Saultes45/Mini-Shake-Table-UoA/README.md

# Mini Shake Table UoA
 A repo for the in-house shake table ressources: both design files and exercises for students
