Saultes45/Mini-Shake-Table-UoA/Design Ressources/03_Diagrams/Mini Shake Front Panel.png

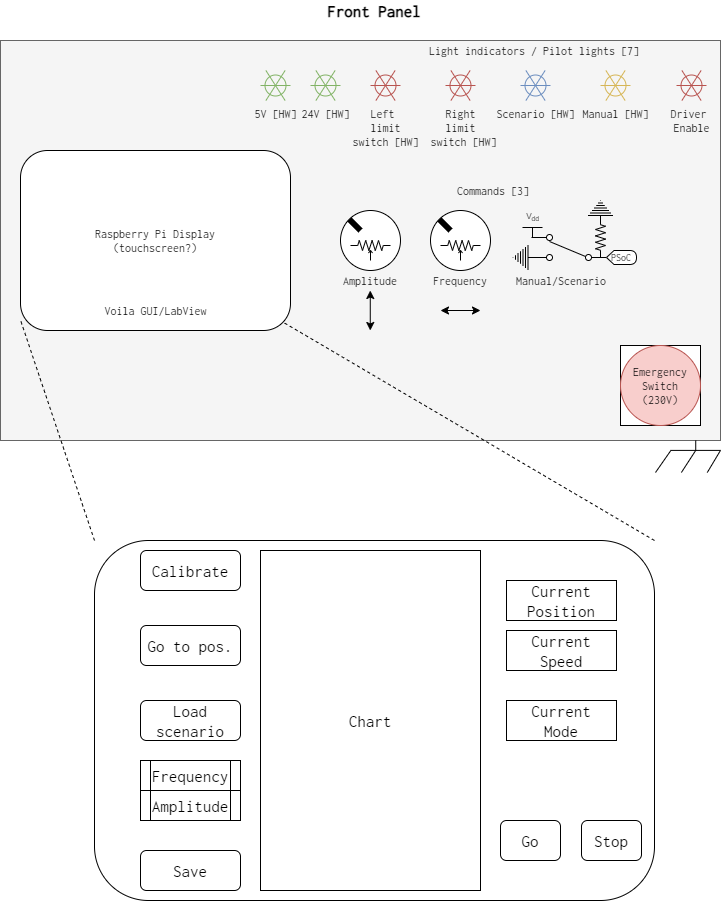
Design Ressources/03_Diagrams/Mini Shake Front Panel.png
