Saultes45/Mini-Shake-Table-UoA/Design Ressources/03_Diagrams/MiniShake bloc diagram stepper.png

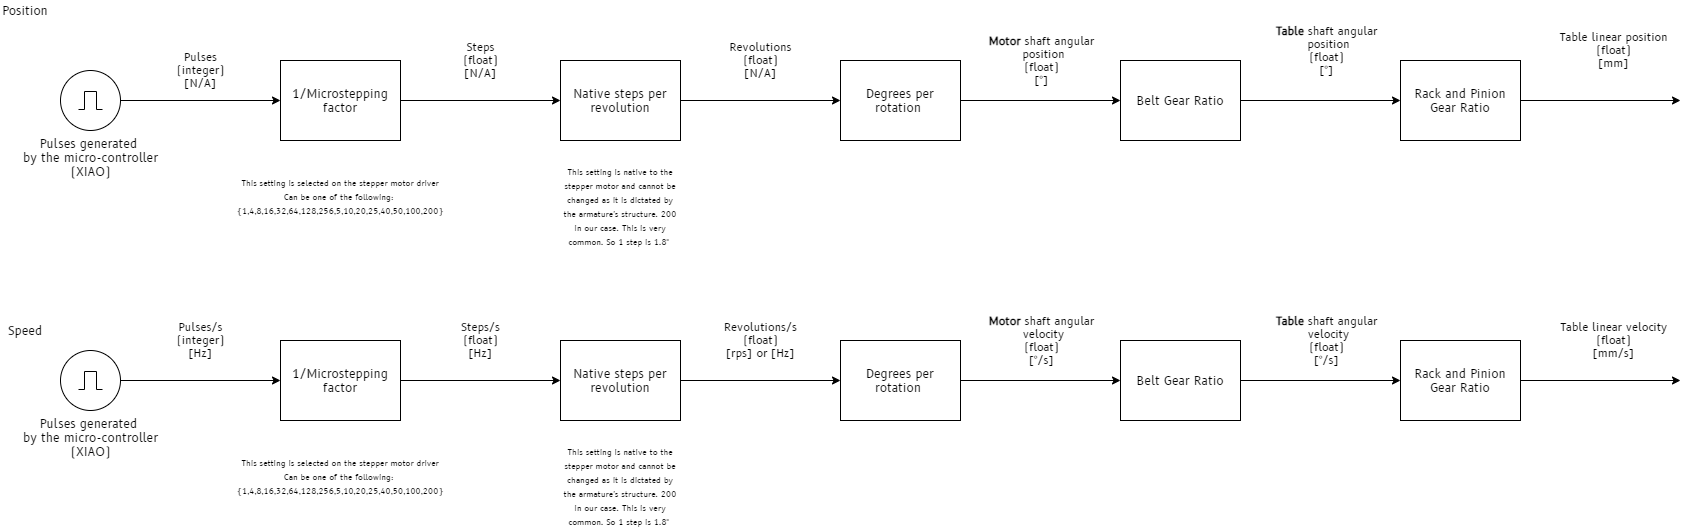
Design Ressources/03_Diagrams/MiniShake bloc diagram stepper.png
