Saultes45/Mini-Shake-Table-UoA/Design Ressources/03_Diagrams/MiniShaker Xiao Pinout.png

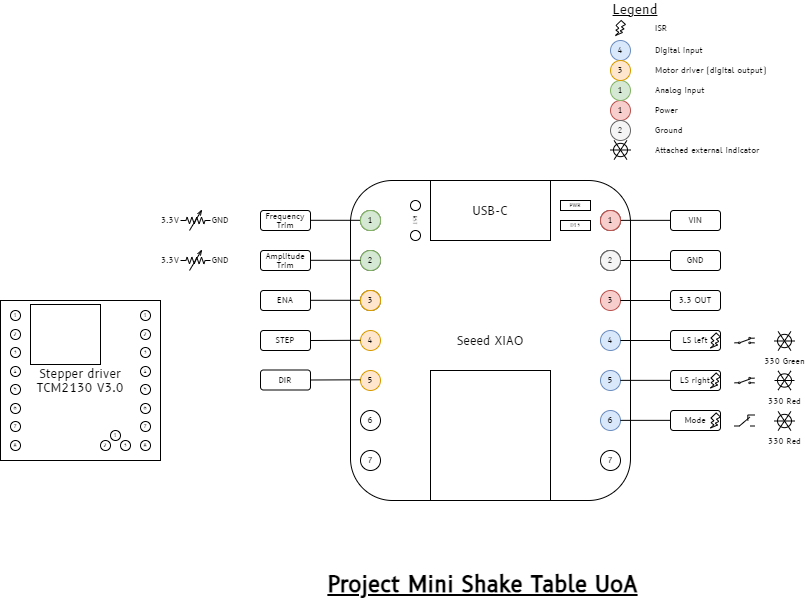
Design Ressources/03_Diagrams/MiniShaker Xiao Pinout.png
