Saultes45/Mini-Shake-Table-UoA/Design Ressources/03_Diagrams/Shake Table.png

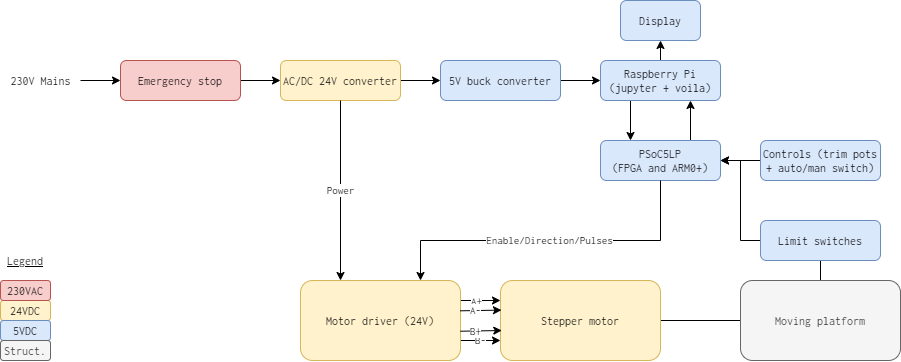
Design Ressources/03_Diagrams/Shake Table.png
