Saultes45/Mini-Shake-Table-UoA/Design Ressources/03_Diagrams/Trimpot Reading.png

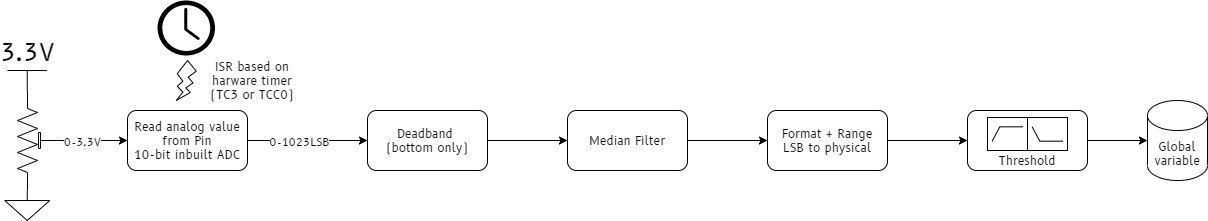
Design Ressources/03_Diagrams/Trimpot Reading.png
