Saultes45/Mini-Shake-Table-UoA/Design Ressources/02_PCB/BOM_Minishake RT micro_2021-07-20.xlsx

ID | Designator | Footprint | Quantity | Manufacturer Part | Manufacturer | Supplier | Supplier Part | Order?
1 | CN1,CN2,CN3,CN6,CN7,CN9,CN10,CN11,CN12,CN13 | CONN-TH_A2543WV-2P | 10 | A2543WV-2P | Changjiang Connectors | LCSC | C239362 | Yes
2 | CN4,CN5 | CONN-TH_A2543WV-3P | 2 | A2543WV-3P | Changjiang Connectors | LCSC | C239363 | Yes
3 | CN8 | CONN-TH_A2543WV-4P | 1 | A2543WV-4P | Changjiang Connectors | LCSC | C239364 | Yes
4 | F2 | F1210 | 1 | MF-USMF050-2 | BOURNS | LCSC | C210831 | Yes
5 | FID1,FID2,FID3,FID4 | FIDUCIAL | 4 |  |  |  |  | No
6 | P1 | UART_HEADER | 1 | Header 1*1P | ReliaPro | LCSC | C81276 | Yes
7 | R1,R2,R3,R4,R5,R6 | R0805 | 6 | RTT053303FTP | RALEC | LCSC | C104230 | Yes
8 | SB1,SB2,SB3,SB4,SB5,SB6,SB7,SB9 | 0402-BRIDGE | 8 | Solder Bridge |  |  |  | No
9 | SJ1 | SOLDER BRIDGE 3P | 1 |  |  |  |  | No
10 | SW1 | SW-SMD_4P-L6.0-W6.0-P4.50-LS9.0_C23873 | 1 | SMD Tactile Switch6*6*6mm | ReliaPro | LCSC | C23873 | No
11 | U1 | PI4_HAT_SLOTS_NO_POE | 1 | RaspberryPi 3 |  |  |  | No
12 | U4 | LM2596 DC-DC BUCK | 1 |  |  |  |  | Yes
13 | U5 | CONN-TH_2P-P2.54_JL301-50002U02 | 1 | JL301-50002U02 | JILN | LCSC | C395214 | Yes
14 | U6 | SEEEDUINO XIAO SMD 3 | 1 | 102010328 | Seeedstudio |  |  | Yes
