Saultes45/Mini-Shake-Table-UoA/Student Ressources/01_Tutorials/Tutorial 1.rtf

Tutorial 1 – Getting familiar with the machine, the front panel commands and indicators, and the general theory of operation

Goal: In this short tutorial, you will learn the different parts of the machine like the inputs, the readings and indicator and most importantly, the security feature made to protect you from the device and vice versa. Let's get started.
1. Theory of operation:
<TO BE FINISHED>

2. Presentation of the different parts of the machine [5]

1. front panel
2. controller
3. power transmission
4. table
5. rail
1.1. The knobs [2 of them]
They are only used in manual mode to choose, and slowing vary 2 movement parameters: the frequency of the movement and the amplitude.
1.2. The enable switch [2 of them]
Overrides the enable and disable orders from the controller. This is a security feature and is explained in detail in 1.2.
1.3. The mode switch [1 of them]
This switch let you pick a mode. You can choose between Manual and Scenario. In "Manual" mode, you use the 2 knobs to make the table describe the movement you want by tweaking the frequency and amplitude you wish. In Scenario mode, the movements you want the table to describe are already pre-programmed in the controller and they will be executed automatically.
1.4. The indicators or pilot lights [6 of them]
There are 6 indicators on the front panel. Some are just for debug, and others are for checking the machine's state so you can understand what it is doing and in which phase it is.
The 2 green indicators indicate when there is power going to the motor (24V) and when there is power going to the controller (3.3V). Both of them should be on at all times when the machine is plugged and the mains switch is in the ON position. If not, your machine has a problem and is will not work.
The 2 red indicators correspond to the 2 limit switches: the left and right one. They illuminate as long as the switch is pressed. The only time you should see those 2 indicator illumination is during calibration mode, when the controller is trying to detect where the table has reached one end.
The amber indicator is linked to the “Enable” state of the motor. When the motor is enabled, and caution is strongly recommended, this indicator is ON. When it is OFF then it MIGHT be safe to operate. To be 100% sure, please use the disable override rocker switch and check the enable status with the help of the indicator.
The white or blue (depending of the model) indicates if the position of the Scenario-manual rocker switch. It just indicates the state of the rocker switch and not the state the controller is in. In calibration mode for example, the mode select rocker switch could be in manual, the indicator will reflect this switch position but in reality, the controller is in calibration mode and will switch to manual as soon as it can. If the “manual” mode is selected, the indicator will be ON, and if the “scenario” mode is selected, the indicator will be OFF.
1. The security features [3]

1.1. The limit switches
There are 2 and are located on both sides of the rail. They are simple temporary spring-loaded, very sensitive switches. They are triggered when the table or any object slams into it. The code detects and acts immediately, within a few ms, to disable the motor. It is important to understand that disabling the motor means the absolute positioning of the table is lost, and therefore, a calibration is required. In calibration mode, limit switches indicate when the table has reached one end of the table.
1.2. The stepper disable toggle (or rocker) switch
The stepper is a strong motor by default, and it packs a lot of torque for its relatively small size. There are very few chances for you to fight its action and succeed. That is the 2.5A we are feeding it, which can go up to 7.2. A stepper motor is stronger when it is static. In that state, the torque and current consumed are maximal. When it is producing a motion, however, the stepper is more susceptible to being moved against. Indeed, in that state, the current fluctuations in its 2 coils are designed to induce rotation of its shaft. This alternance of current diminishes the overall current and, therefore, torque.
As a side note, it is essential to notice that when a stepper is static, it uses a lot of power. This power, not being used entirely as mechanical energy to hold the motor shaft in place, must be dissipated. This dissipation occurs as thermal energy, and the 2 coils of the stepper slowly turns into giant resistors. When no testing is being done, please disable the power going to the stepper (procedure explained below) to avoid premature ageing of the coils.
Thanks to the built-in function of the stepper controller, it is possible to disable any power going to the stepper in a matter of ms. The state of the stepper, i.e. if it is enabled or disabled, is indicated on the front panel by the amber or yellow indicator. Off is disabled and safe to operate, ON is enabled, and caution is advised.
This function is partly handled by the controller: in some particular conditions, the controller will disable the stepper for you. But you can override and disable the stepper irrespective of the controller orders with the dedicated rocker switch exposed in the front panel. This rocker switch is made as a last-chance or barrier of protection. It is helpful primarily in 2 cases.
First, when there is a problem with the shake table and the limit switches are not being triggered (in this case, the mains switch (below) can be used as well).
The second case is as another layer of security for when you are handling equipment close to the moving part of the table or moving the table manually (discouraged) and want to make sure the motor will stay off.
It has been presented before, but any disabling of the motor will make it lose its absolute position. Therefore calibration is required after each disabling.
1.3. The emergency switch
If anything seems out of place or if there is a weird noise or smell, it's time to take action and disable all the power going to the machine. This is your best shot at stopping a critical problem before it is time to get the nearest fire extinguisher. You can turn off all power by simply slamming the large red emergency button. It is conveniently located on the left side of the table, far away from any potential danger, so it's always safe to press it. To reset it, like any emergency button, you have to twist it clockwise like you would screw it (righty-tighty) about a 1/6th of a turn.
