Saultes45/Mini-Shake-Table-UoA/Student Ressources/01_Tutorials/Tutorial 3.rtf

Tutorial 3 – Getting familiar with the Raspberry Pi GUI running an existing scenario, creating your own and testing it
