Saultes45/Mini-Shake-Table-UoA/Student Ressources/01_Tutorials/List of tutorials.docx

Tutorial 1 – Getting familiar with the machine, the front panel commands and indicators, and the general theory of operation

Tutorial 2 – Calibration, centring and manual trimpot adjustments

Tutorial 3 – Getting familiar with the Raspberry Pi GUI running an existing scenario, creating your own and testing it
