Saultes45/Mini-Shake-Table-UoA/Student Ressources/01_Tutorials/Tutorial 2.rtf

Tutorial 2 – Calibration, centring and manual trimpot adjustments

Goal: In this short tutorial, you will learn the sequencing of the machine and how to run the simpliest movement possible to execute on this shake table: the manual mode. Let's get started.

What is the "manual" mode: in manual mode, yuou are in in control of the movement, and with great power comes great mecanical energy. With 2 control knobs you will be able to create different kinds of motion to exite a structure at different modes with different amplitudes. The control of the movement is made through 2 parameter: the frequency and the amplitude of the movement. Thoses 2 parameters are independants .

The controller will not execute the mouvement until both parameters are non-null. so if you want to produce some oscillations, you will have to turn both knobs pass their deadband. Otherwise the controller will not move at all. Indeed, what kind of movement is one with 0 amplitude or 0 frequency?

Deadband and filtering.
Because the signal coming back from the knob contains some electrical noise, it wouldn't be wise to simply read it as is. There a bit of conditioning that takes place. Simply put, the controller filters the signal to smooth it out and to make it more stable.
A deadband hasd also been implemented. Simply put, a very small portion of the start of the knobs has been rendered inactive. The controller will consider any value in this "band" or portion to be 0 even though is actually not. This is a simple trick to make a quick and soft start when changing manual parameter values.
If you are curious, you can refer to the simple block diagram called "Trimpots reading" in the annexes
