Saultes45/Mini-Shake-Table-UoA/Student Ressources/00_Test Profiles/Test - S.xlsx

Time To Target [ms] | Target [mm]
500 | 25
500 | -50
500 | 75
500 | -100
500 | 200
500 | 0
