Saultes45/Mini-Shake-Table-UoA/Student Ressources/00_Test Profiles/High F Low A.xlsx

Time To Target [ms] | Target [mm]
500 | 25
500 | -25
500 | 25
500 | -25
500 | 25
500 | -25
