Saultes45/Mini-Shake-Table-UoA/(threads)

Thread 1 (2021-07-21):

Problem in manual control with knobs

Saultes45, 2021-07-21:
Right LS seems to trigger even if it was physically not.
We have this as the output:

```
Current mode: 1 | 1
Current mode: 1 | 1
You are going to lose the reference position, calibration will be required
DISABLING the stepper...done
DISABLING the TRIMPOTS...done
ENABLING the TRIMPOTS...done
Current mode: 1 | 1
RIGHT Limit Switch ISR triggered 23513, current status: 1
```

Saultes45, 2021-08-04:
This issue is from an old version and the described issue does not occur anymore. Will be closed.

Closed 2021-08-04.
