Saultes45/Mini-Shake-Table-UoA/Design Ressources/00_Structure/Mini Shake Table Final 23.09.pdf

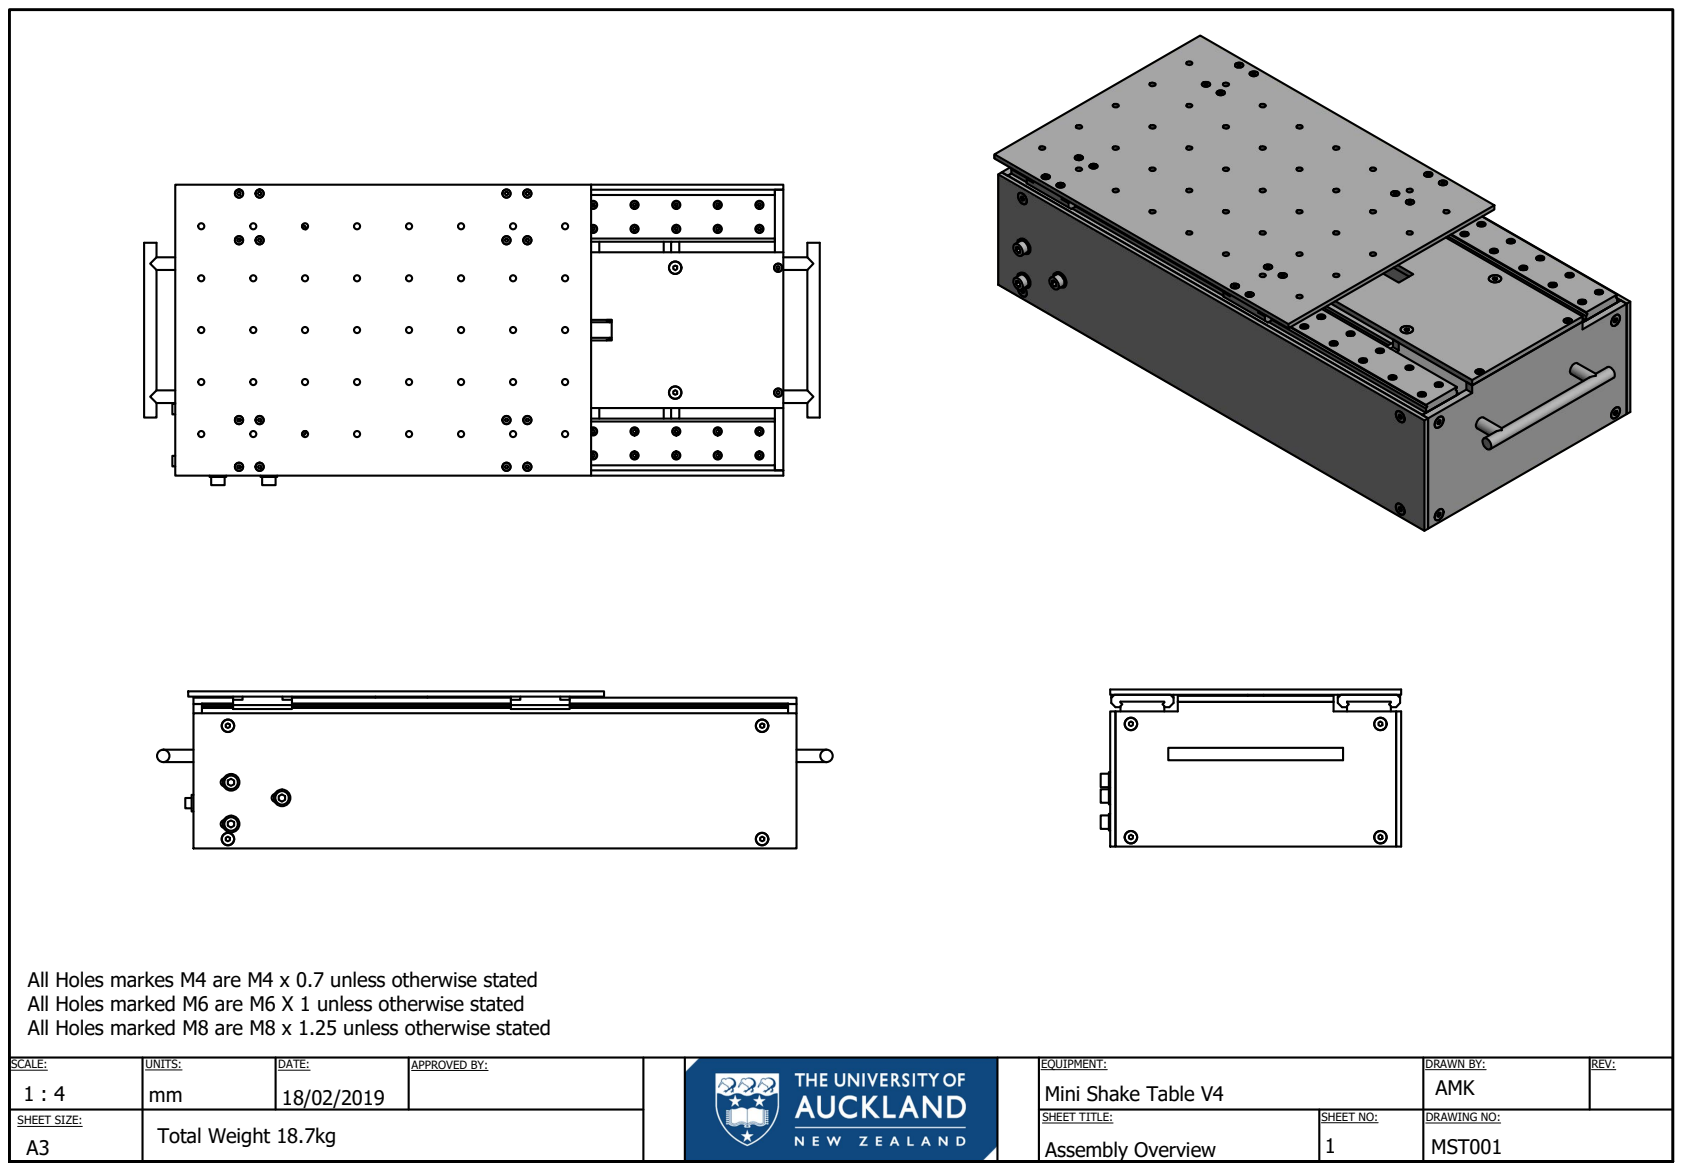
[picture p6: page 1]
All H All H All H

S C A L E : 1 : 4 | U N I T S : | D AT E : 1 8 / 0 2 / 2 0 1 9 | A P P R O V E D B Y : | | | E Q U I P M E N T : a k e T a ble V 4 | D RA W N B Y : A M K | R E V :

S H E E T S I Z E : A 3 | T o t al W e i g h t 1 8 . 7 k g | | | S H E E T T I T L E : bly O v e r v i e w | S H E E T N O : 1 | D RA W I N G N O : M S T 0 0 1

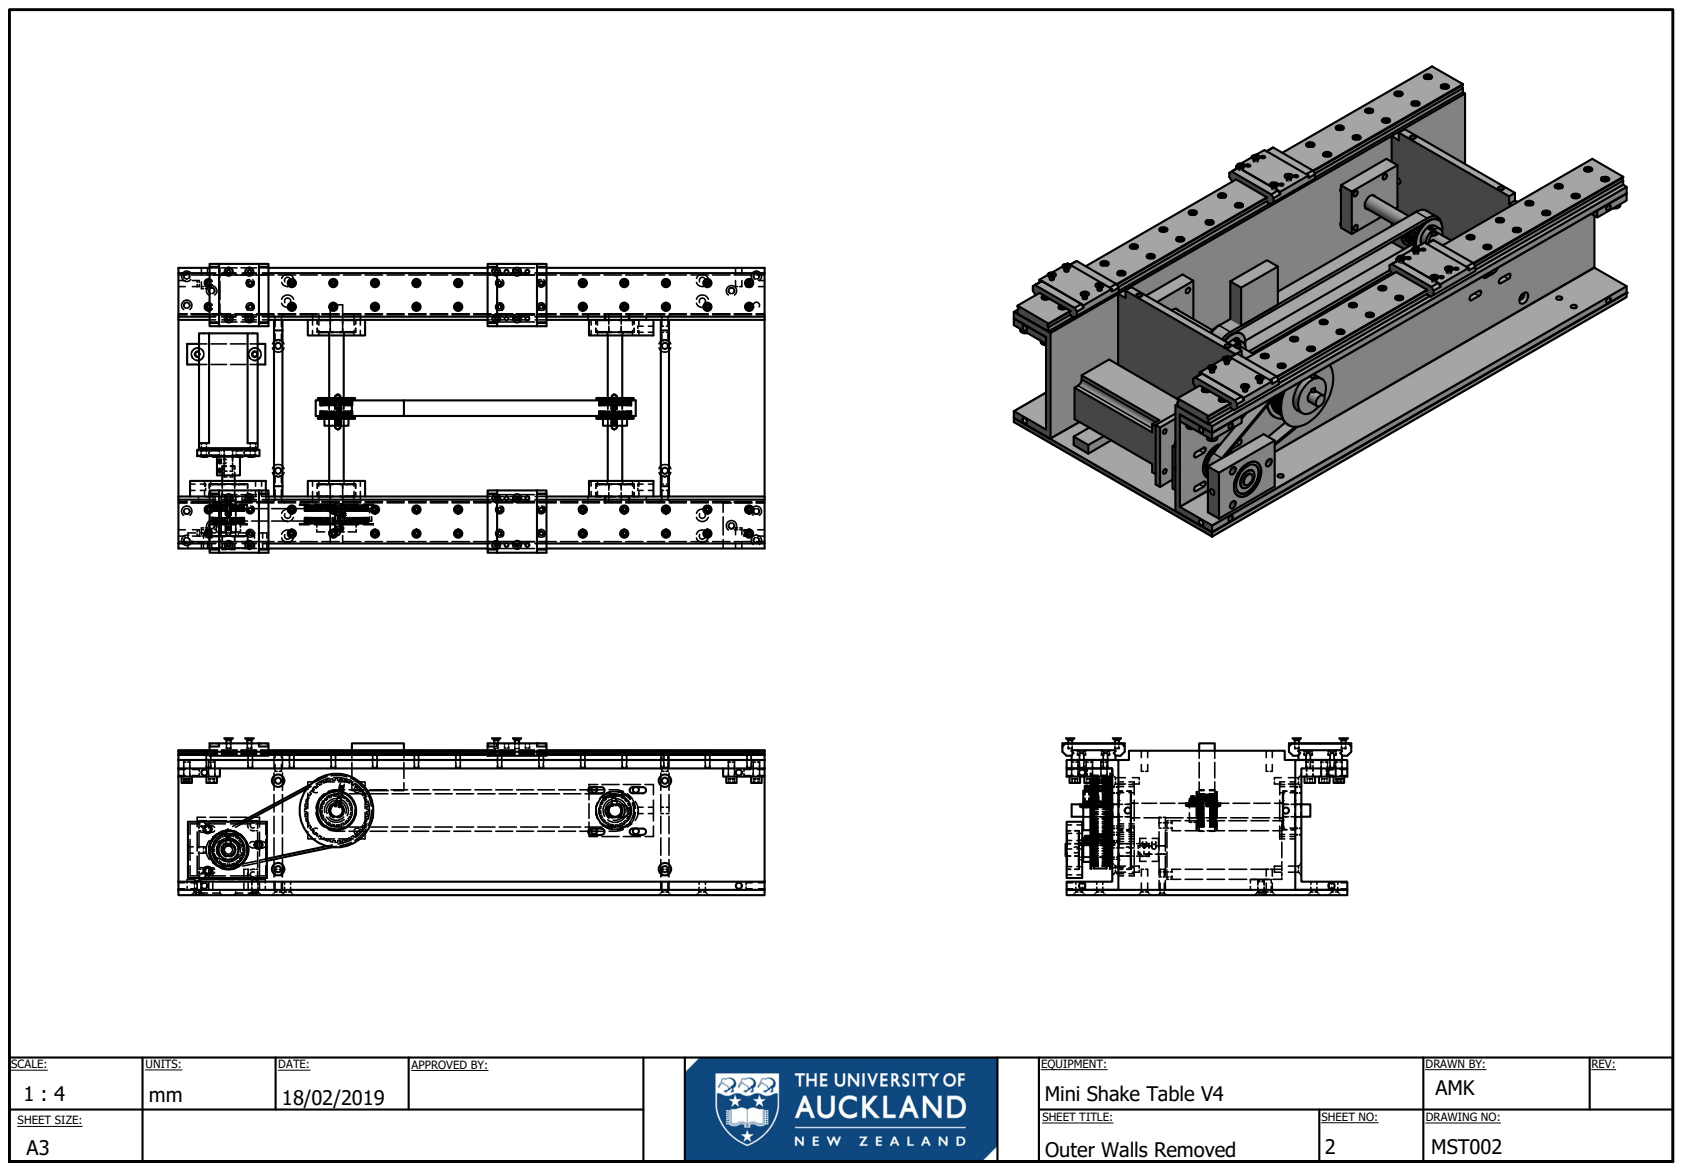
[picture p7: page 2]

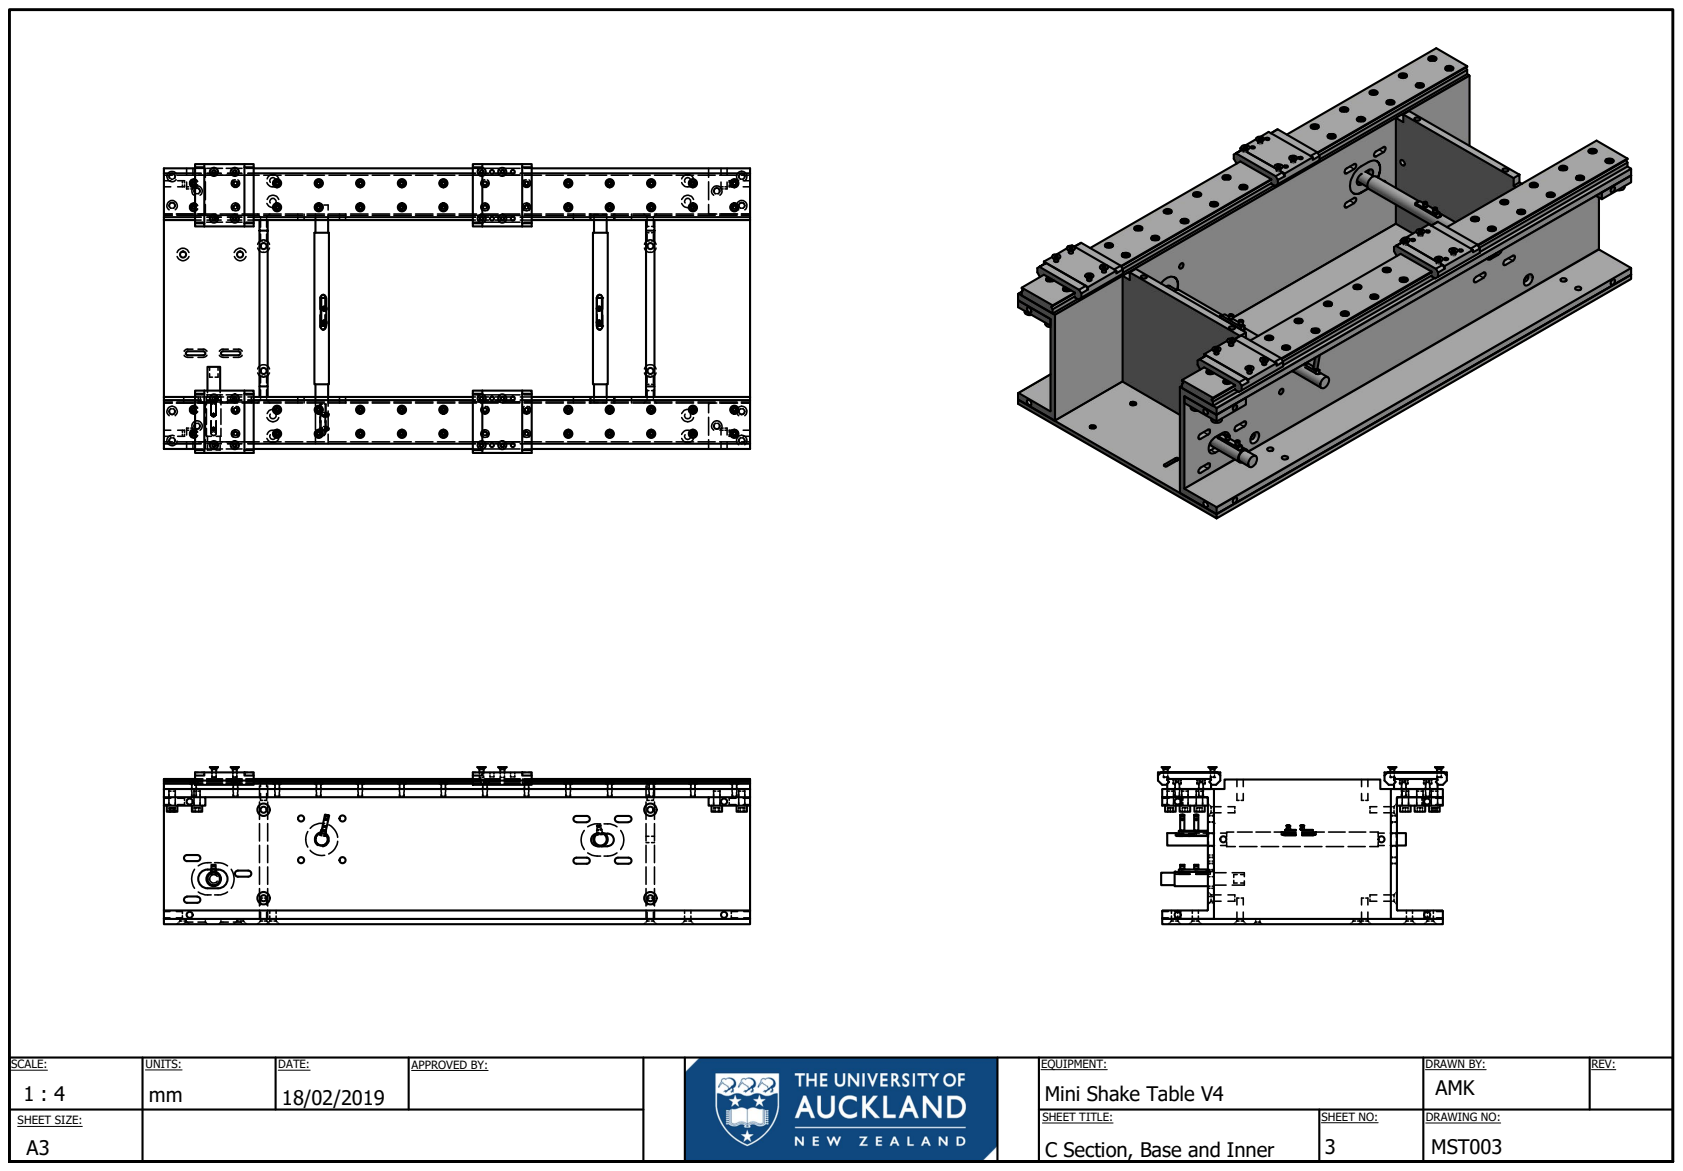
[picture p8: page 3]

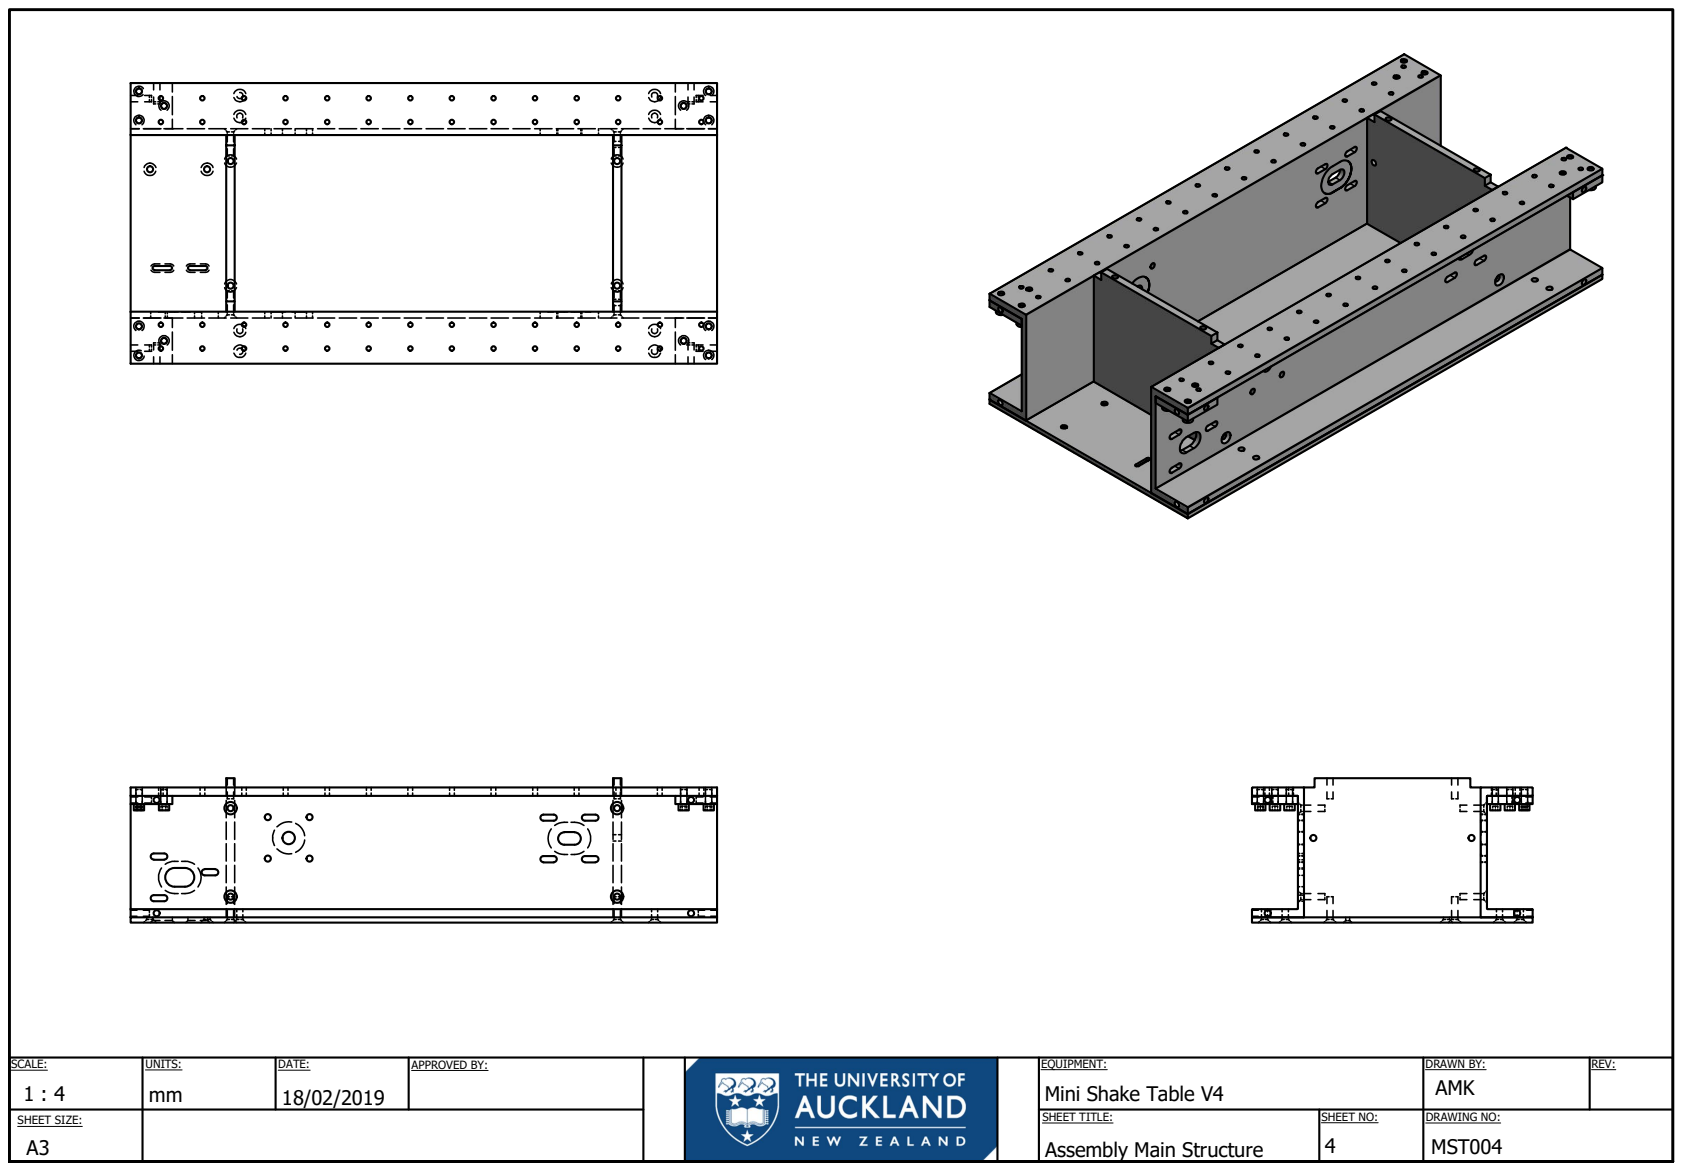
[picture p9: page 4]

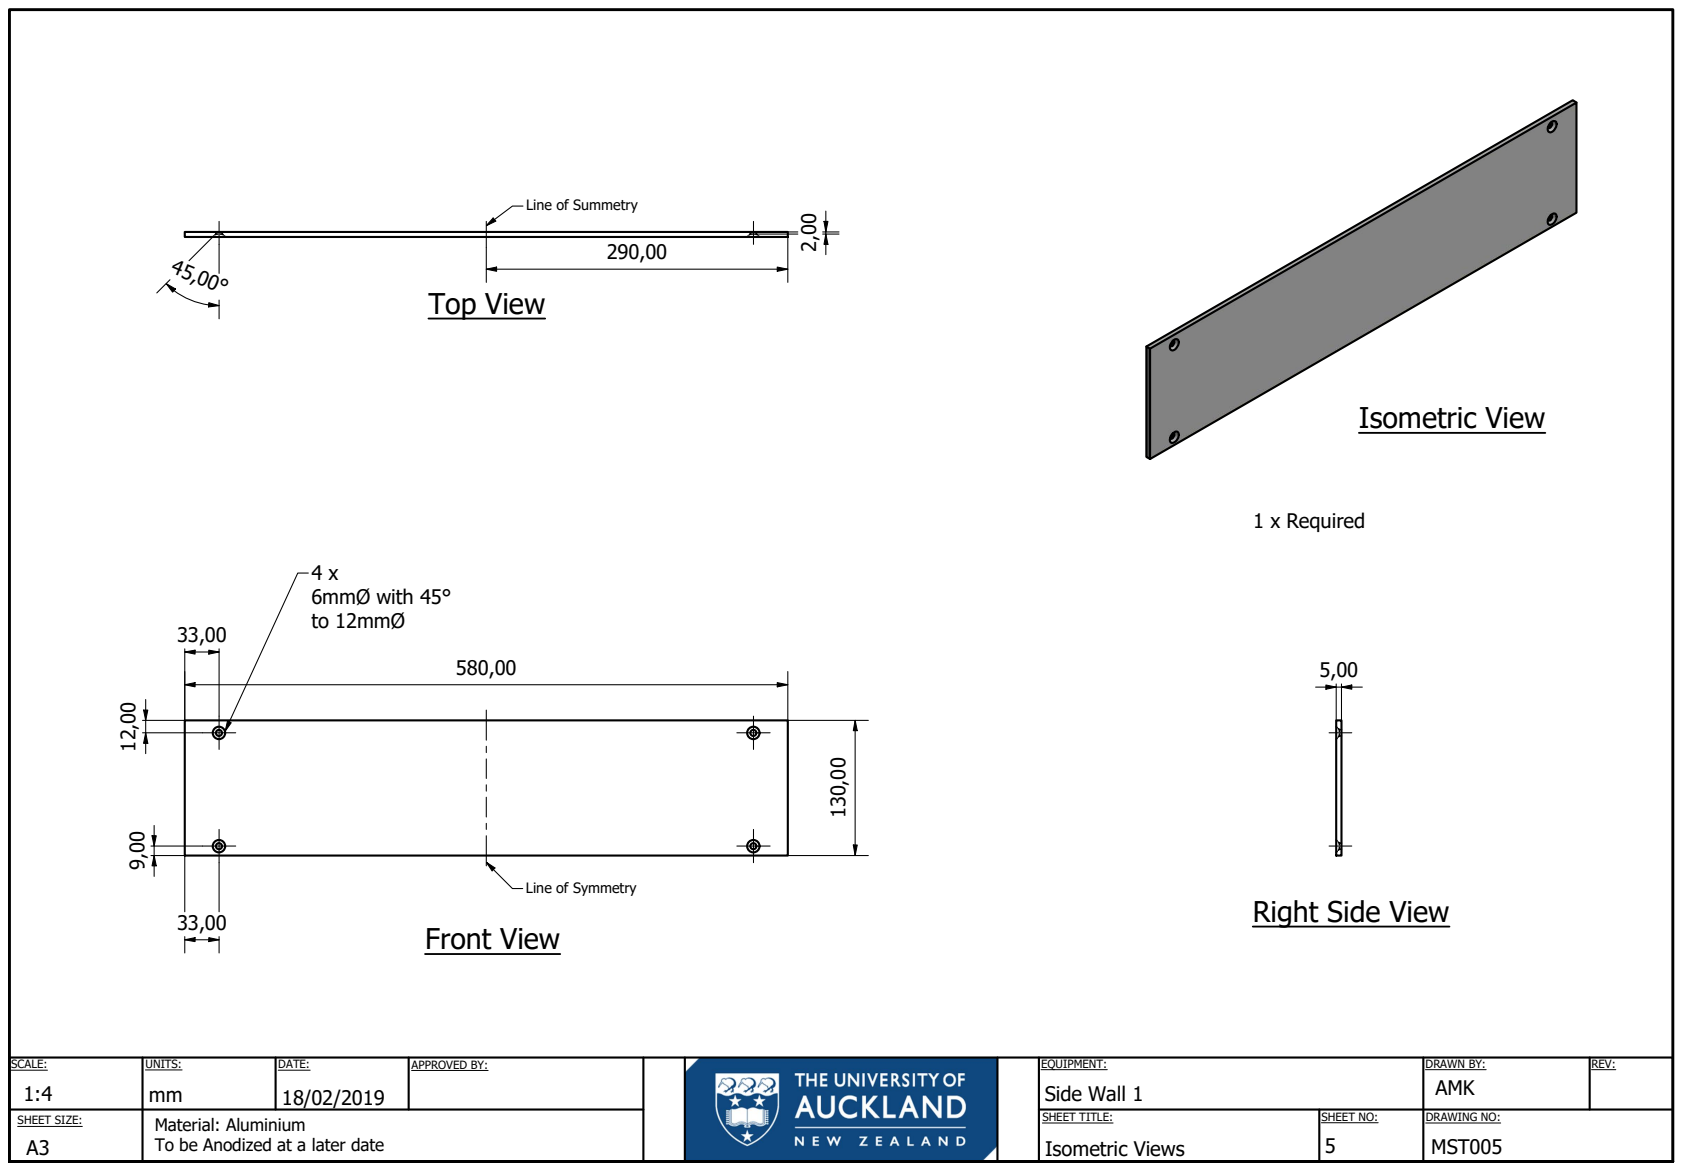
[picture p10: page 5]
SCALE:; UNITS:; DATE:; APPROVED BY:; EQUIPMENT:; SHEET TITLE:; SHEET NO:; DRAWN BY:; DRAWING NO:; Isometric Views; MST005; SHEET SIZE:; Side Wall 1; 4 x 6mmØ with 45° to 12mmØ; Front View; Top View; Isometric View; 1 x Required

Line of Summetry

Line of Symmetry

Right Side View

Material: Aluminium
To be Anodized at a later date

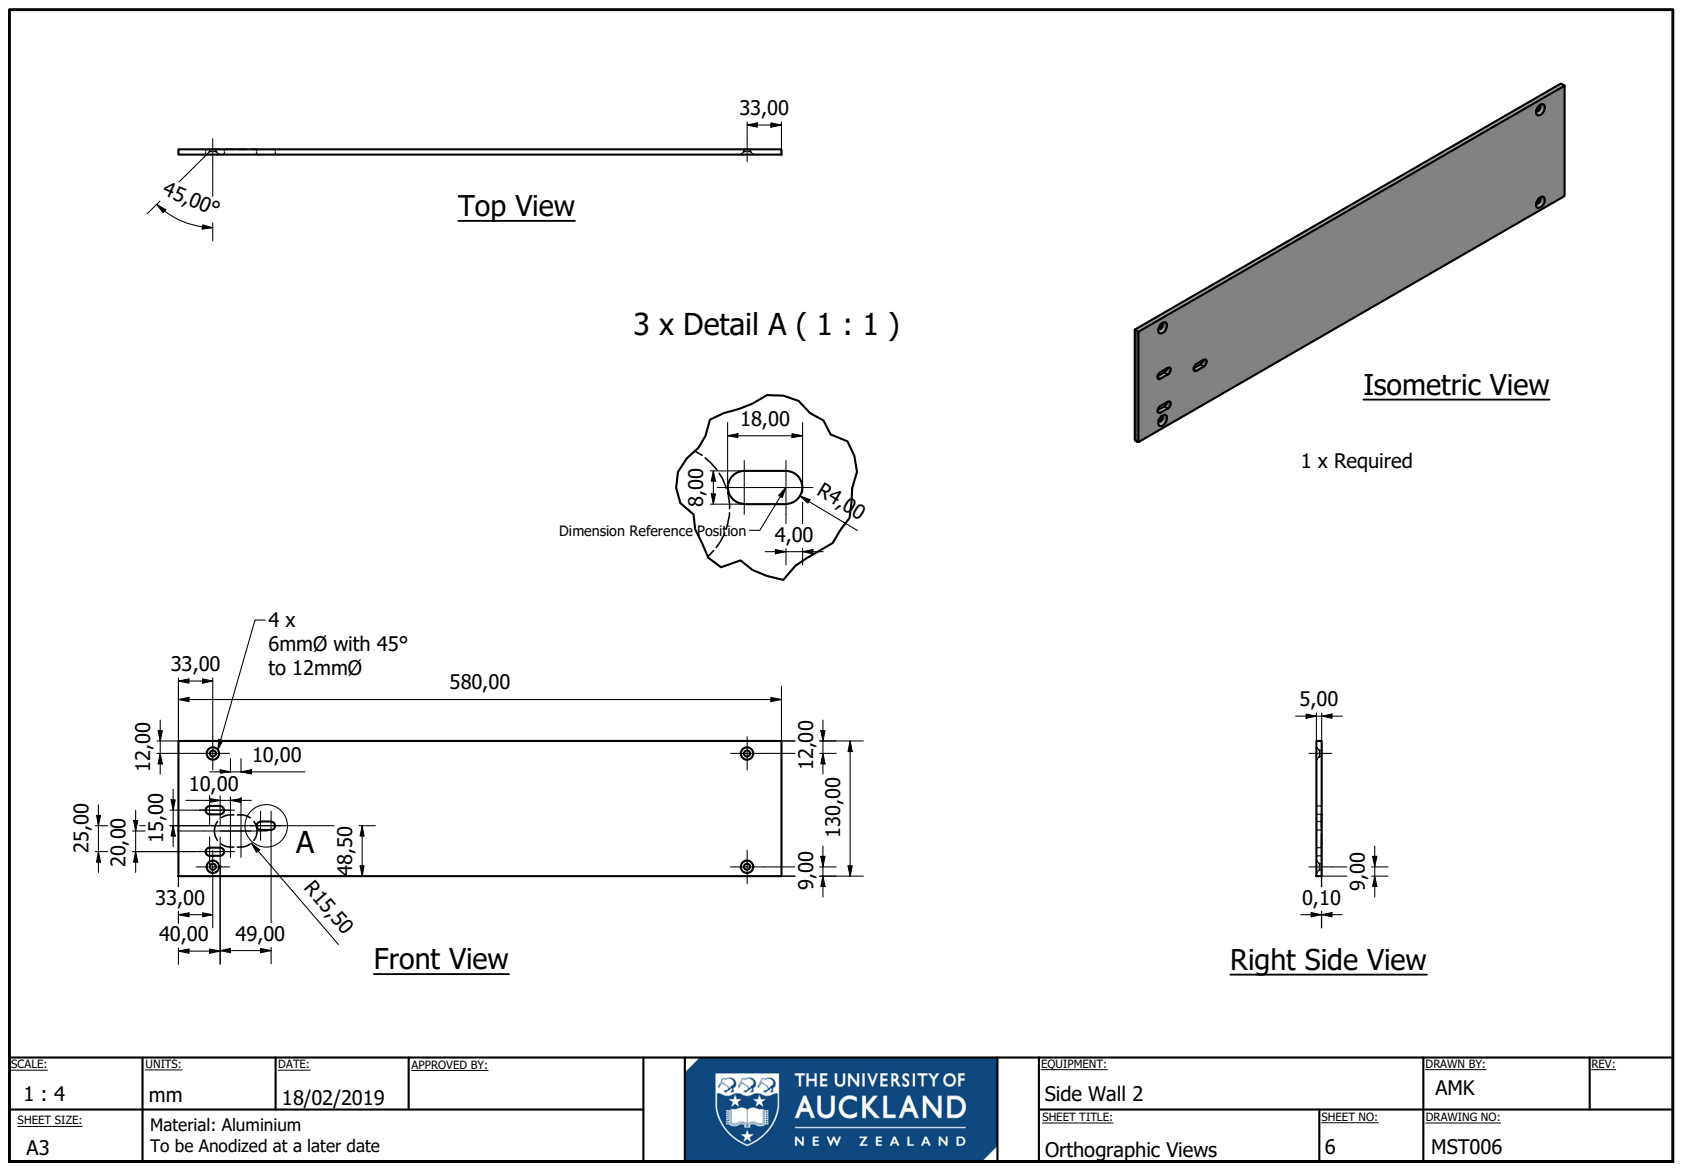
[picture p11: page 6]
3 x Detail A ( 1 : 1 ); SCALE:; UNITS:; DATE:; APPROVED BY:; EQUIPMENT:; DRAWN BY:; Orthographic Views; MST006; Side Wall 2; Front View; Right Side View; Isometric View; 4 x 6mmØ with 45° to 12mmØ; Top View; 1 x Required

Dimension Reference Position

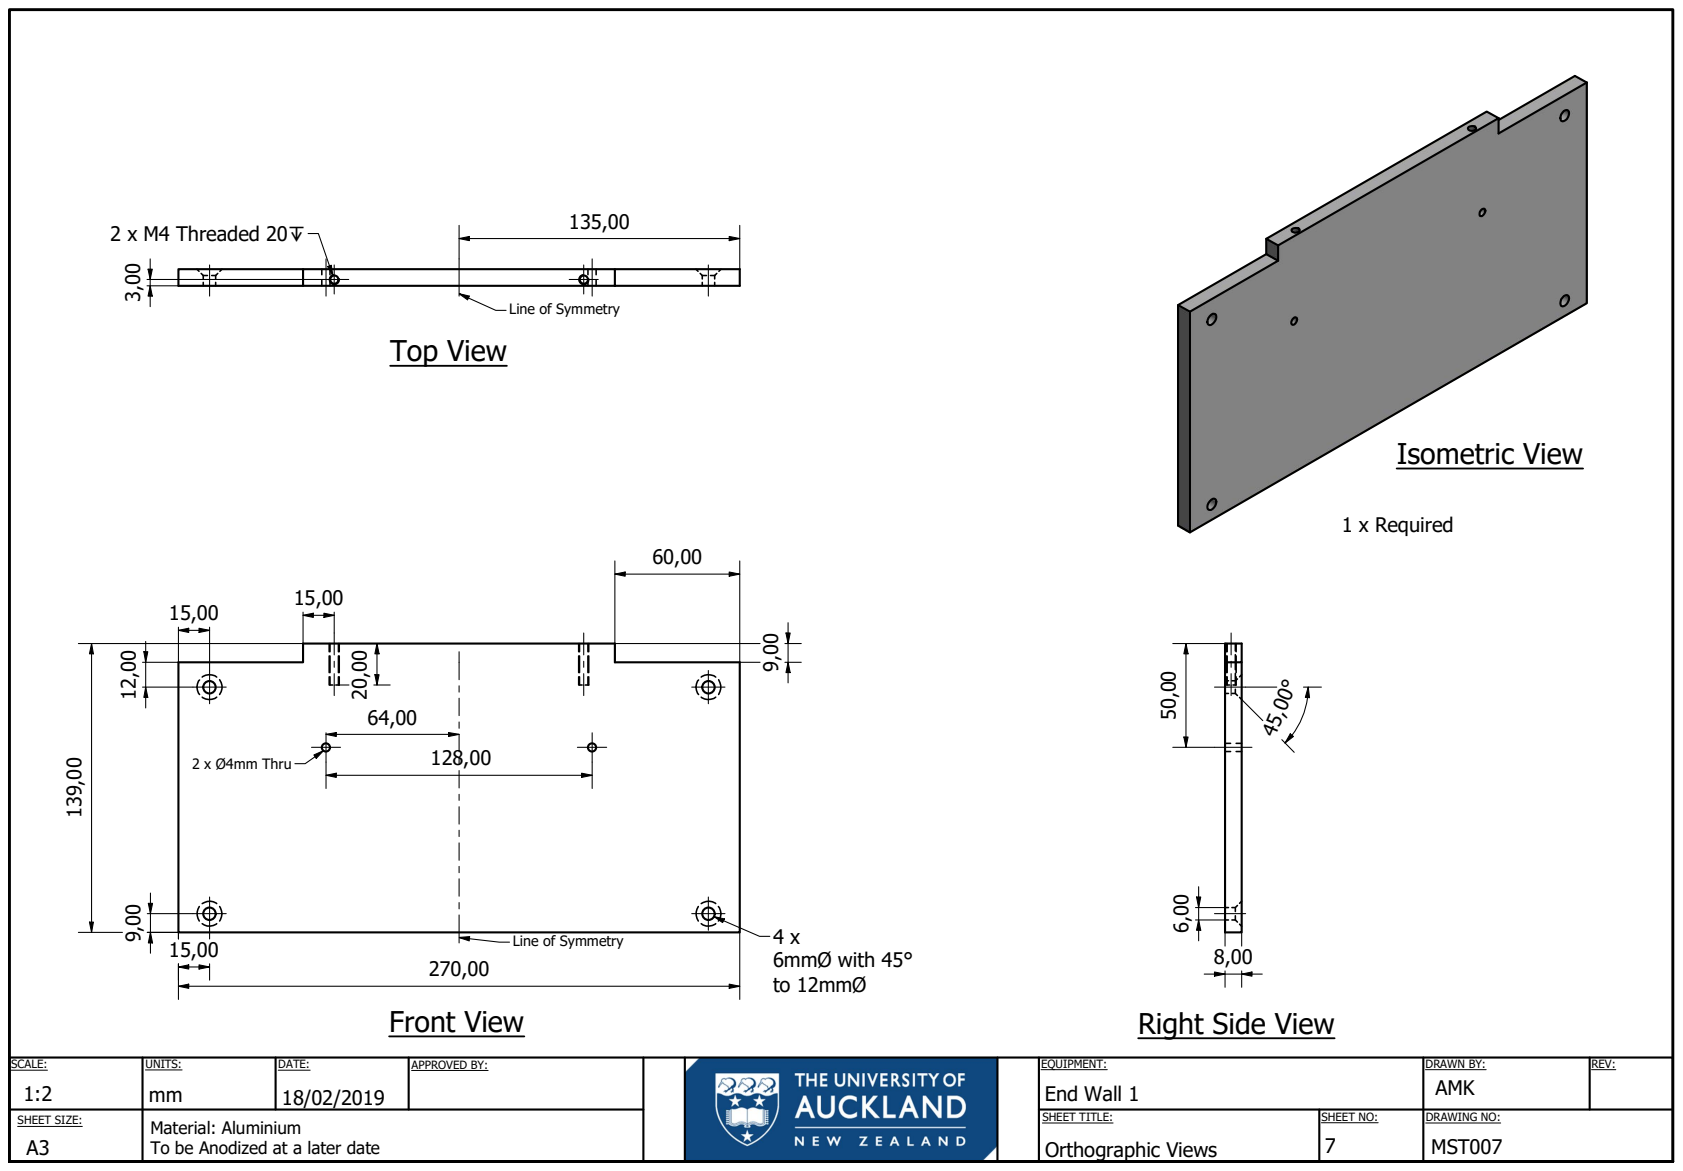
[picture p12: page 7]
SCALE:; UNITS:; DATE:; APPROVED BY:; EQUIPMENT:; DRAWN BY:; Orthographic Views; MST007; End Wall 1; 4 x 6mmØ with 45° to 12mmØ; Front View; Right Side View; Isometric View; Top View; 2 x Ø4mm Thru; 1 x Required

Line of Symmetry

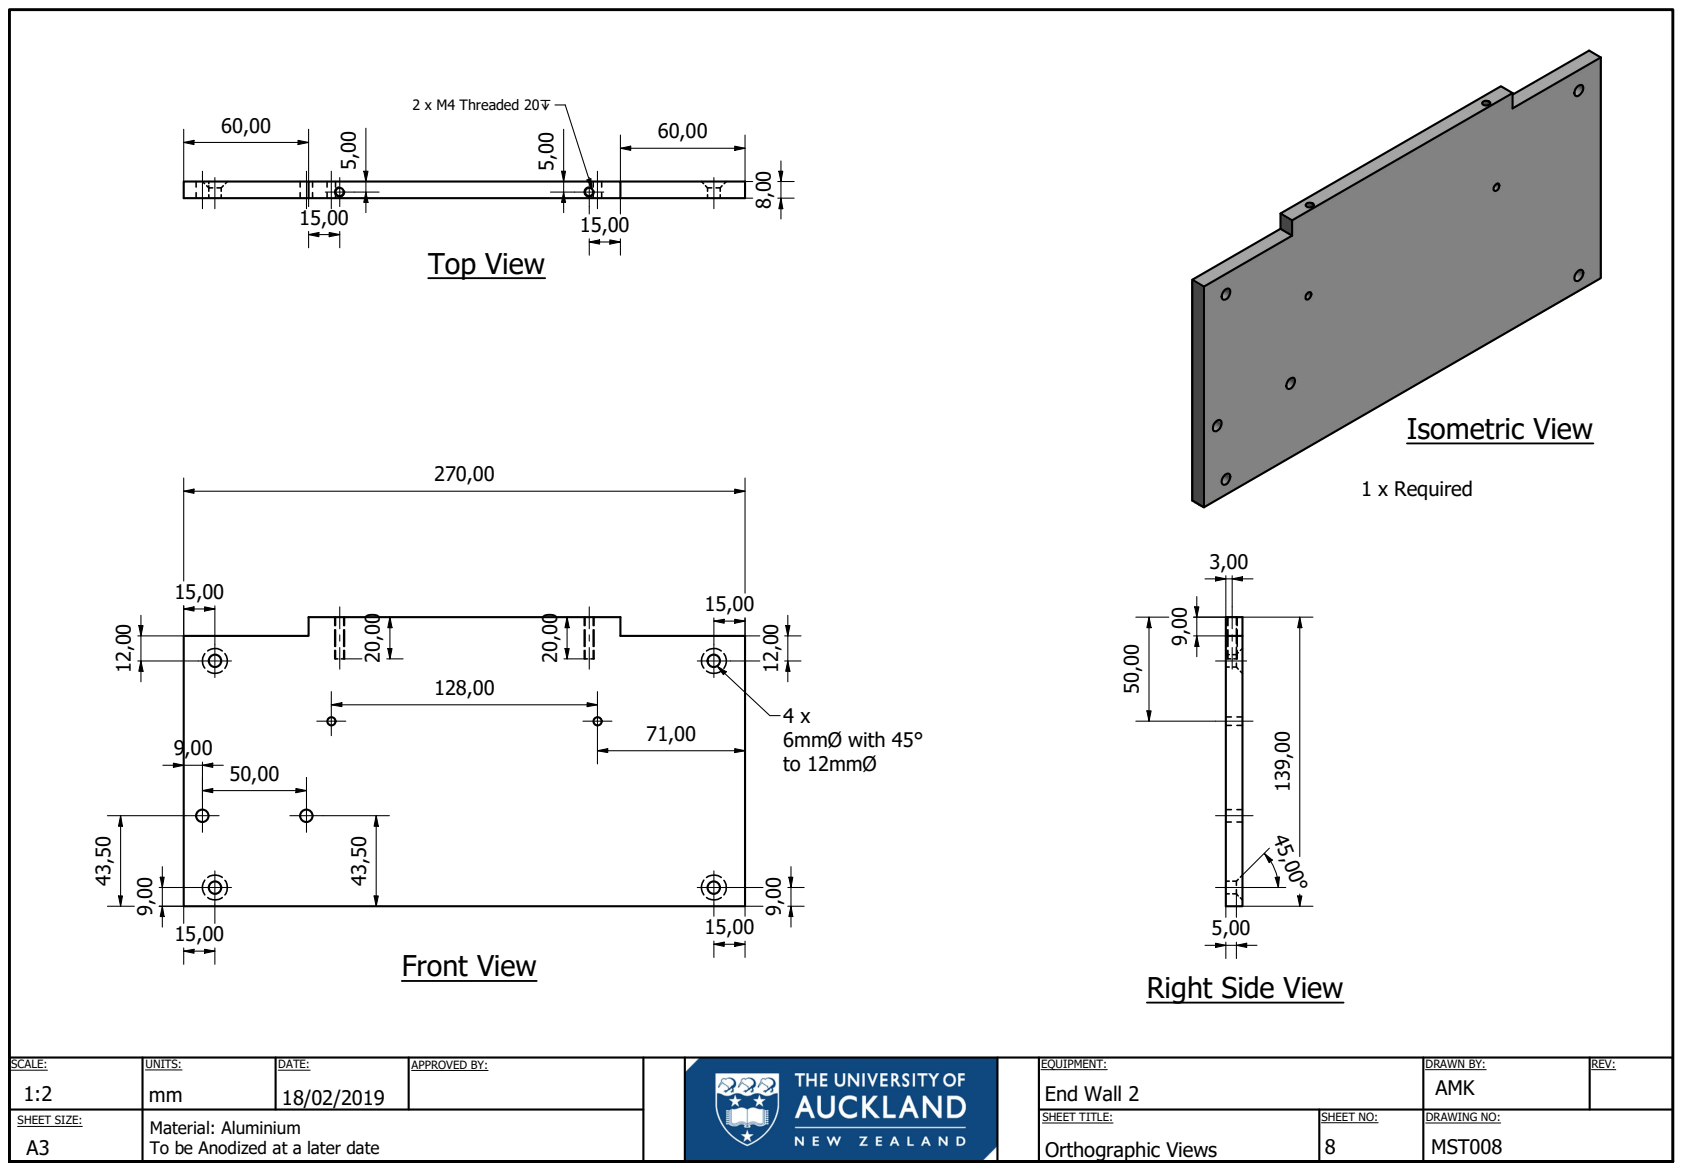
[picture p13: page 8]
SCALE:; UNITS:; DATE:; APPROVED BY:; EQUIPMENT:; DRAWN BY:; Orthographic Views; MST008; End Wall 2; Front View; Top View; Isometric View; 4 x 6mmØ with 45° to 12mmØ; 1 x Required

Right Side View

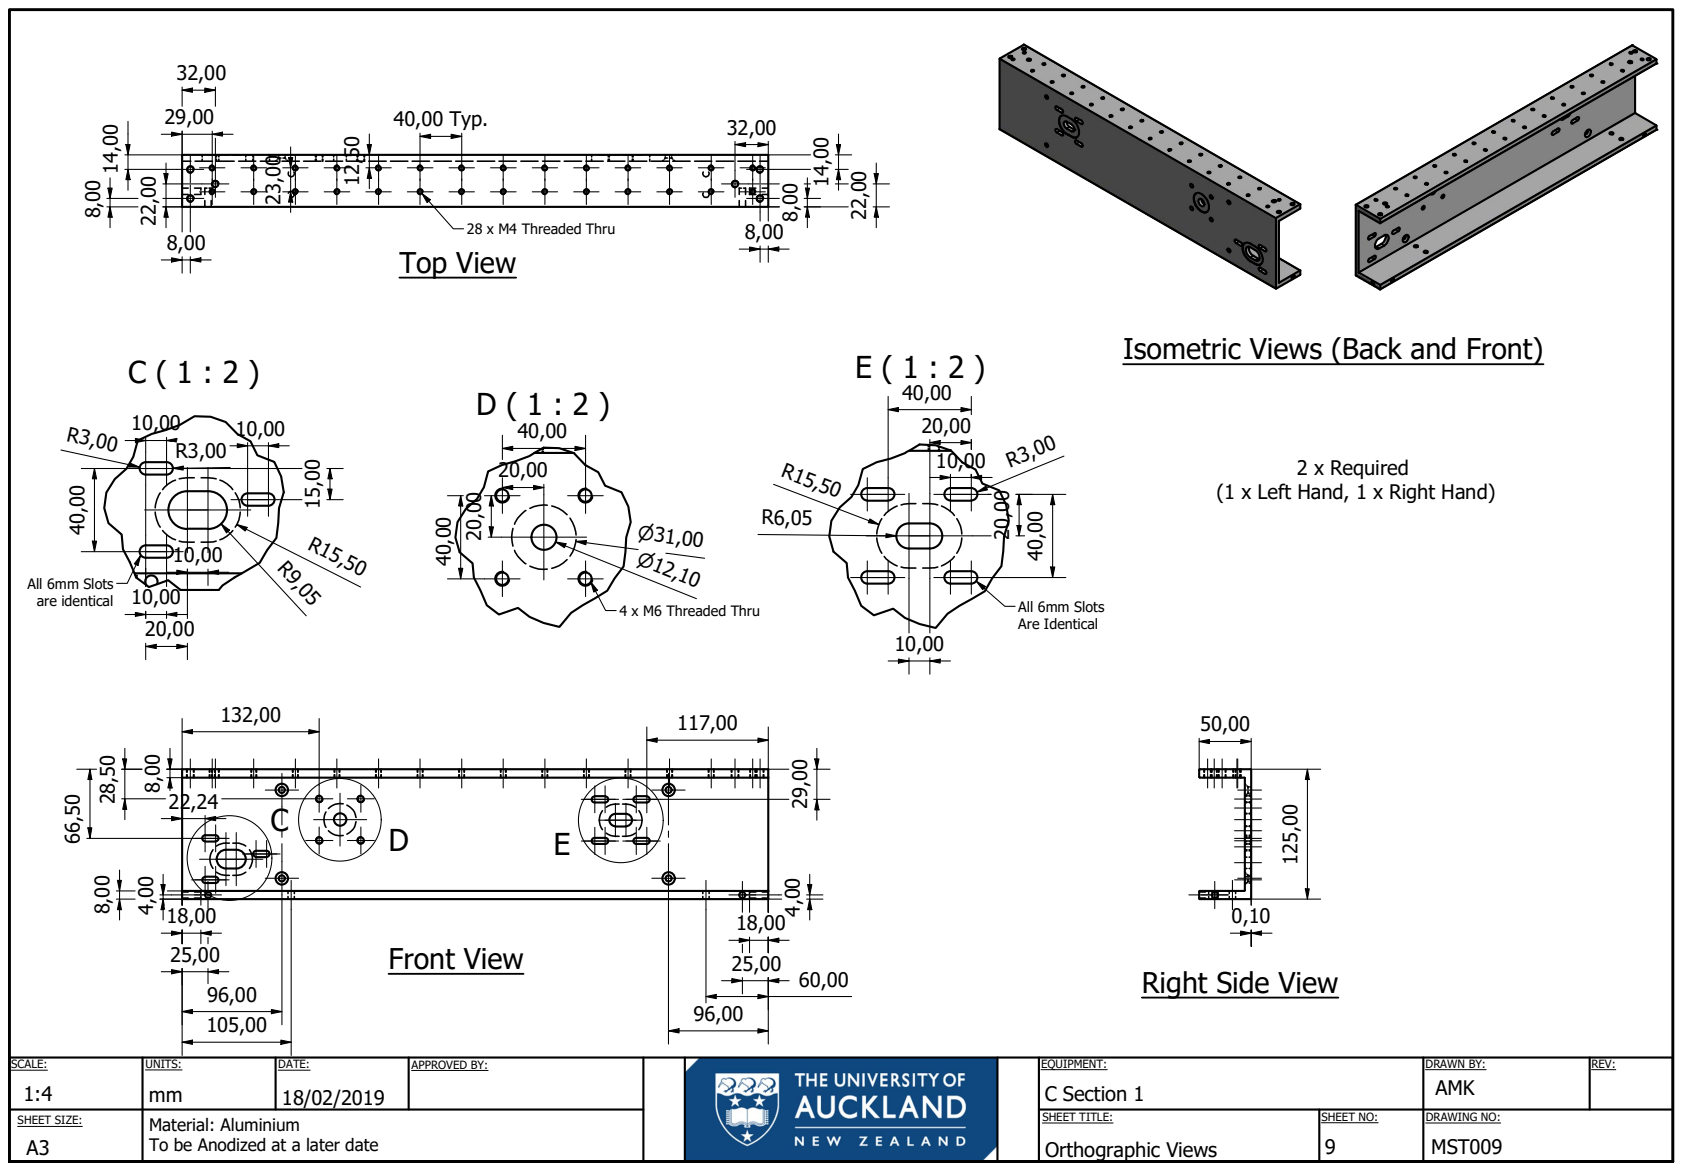
[picture p14: page 9]
SCALE:; UNITS:; DATE:; APPROVED BY:; EQUIPMENT:; DRAWN BY:; Orthographic Views; MST009; C Section 1; AMK; 40,00 Typ.; 28 x M4 Threaded Thru; All 6mm Slots are identical; 4 x M6 Threaded Thru; All 6mm Slots Are Identical; Front View; Top View; 2 x Required

Isometric Views (Back and Front)

(1 x Left Hand, 1 x Right Hand)

Right Side View

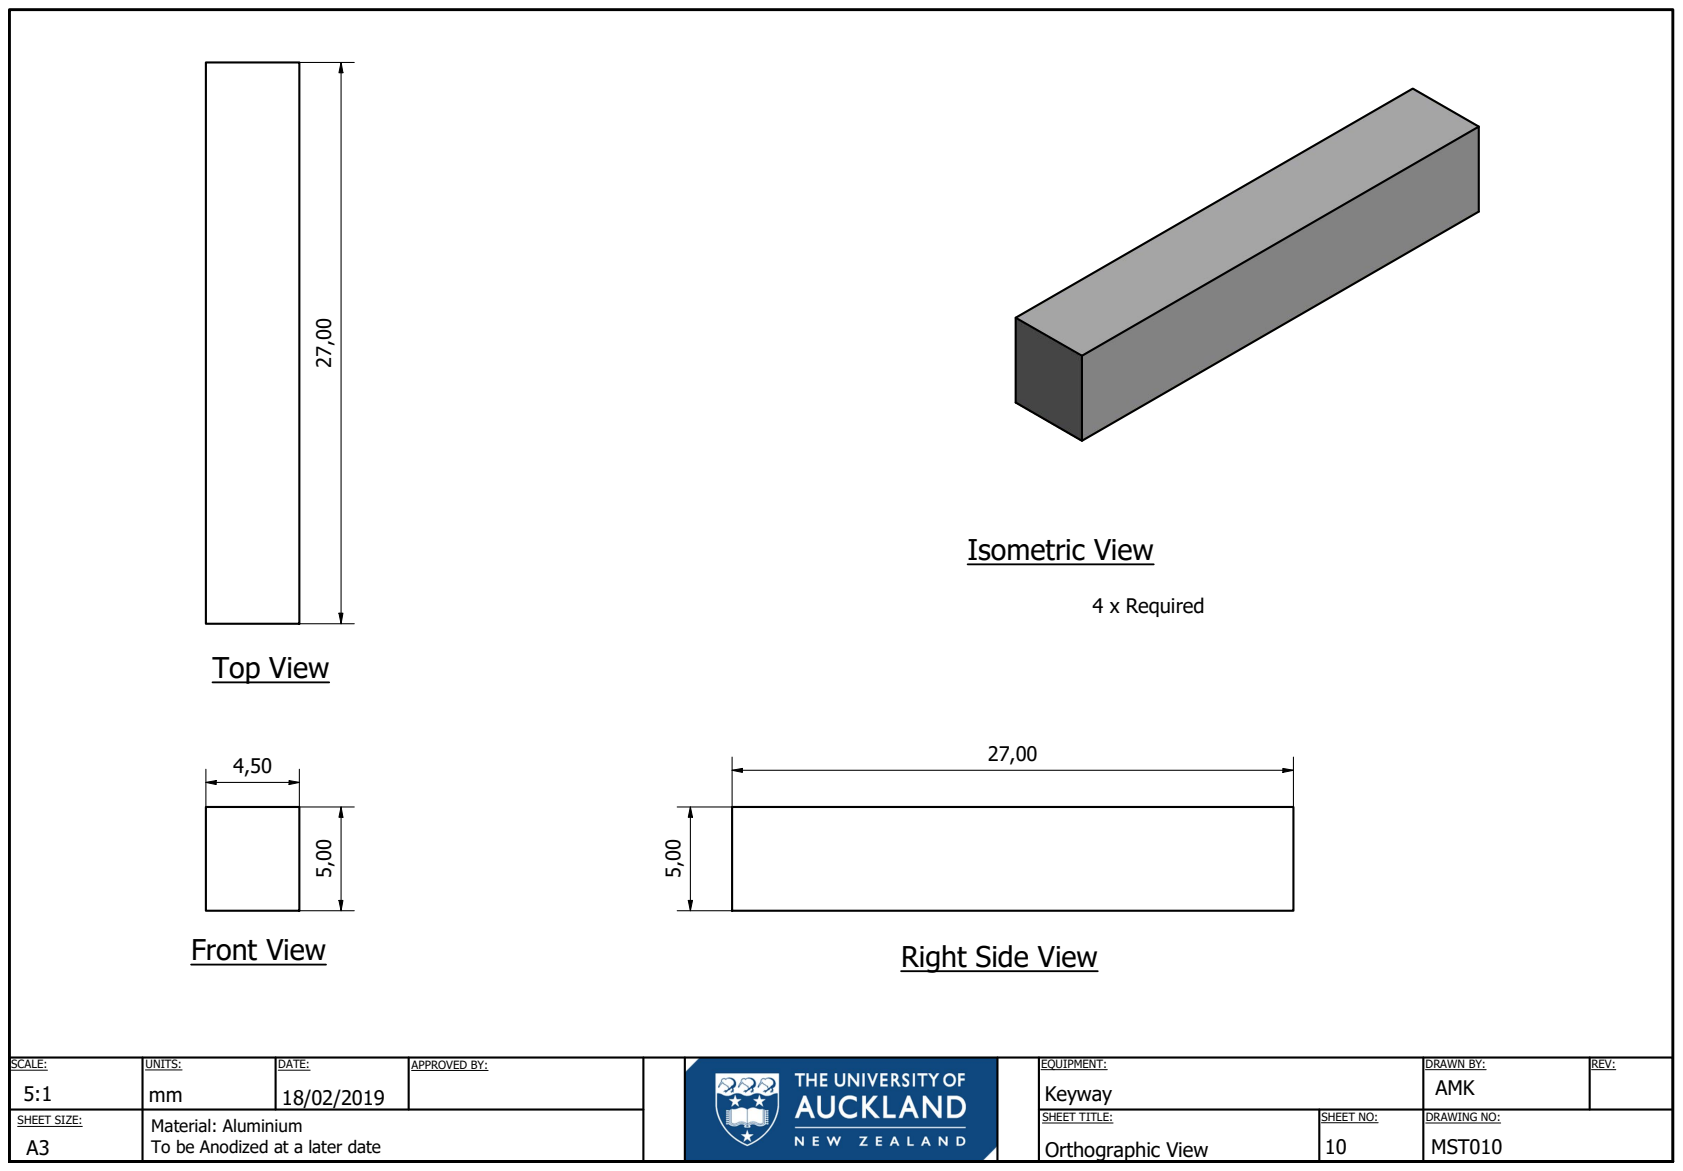
[picture p15: page 10]
Front View; Right Side View; Top View; Isometric View; 4 x Required

SCALE: 5:1 | UNITS: mm | DATE: 18/02/2019 | APPROVED BY: | EQUIPMENT: Keyway | DRAWN BY: AMK | REV:

Orthographic View | 10 | MST010

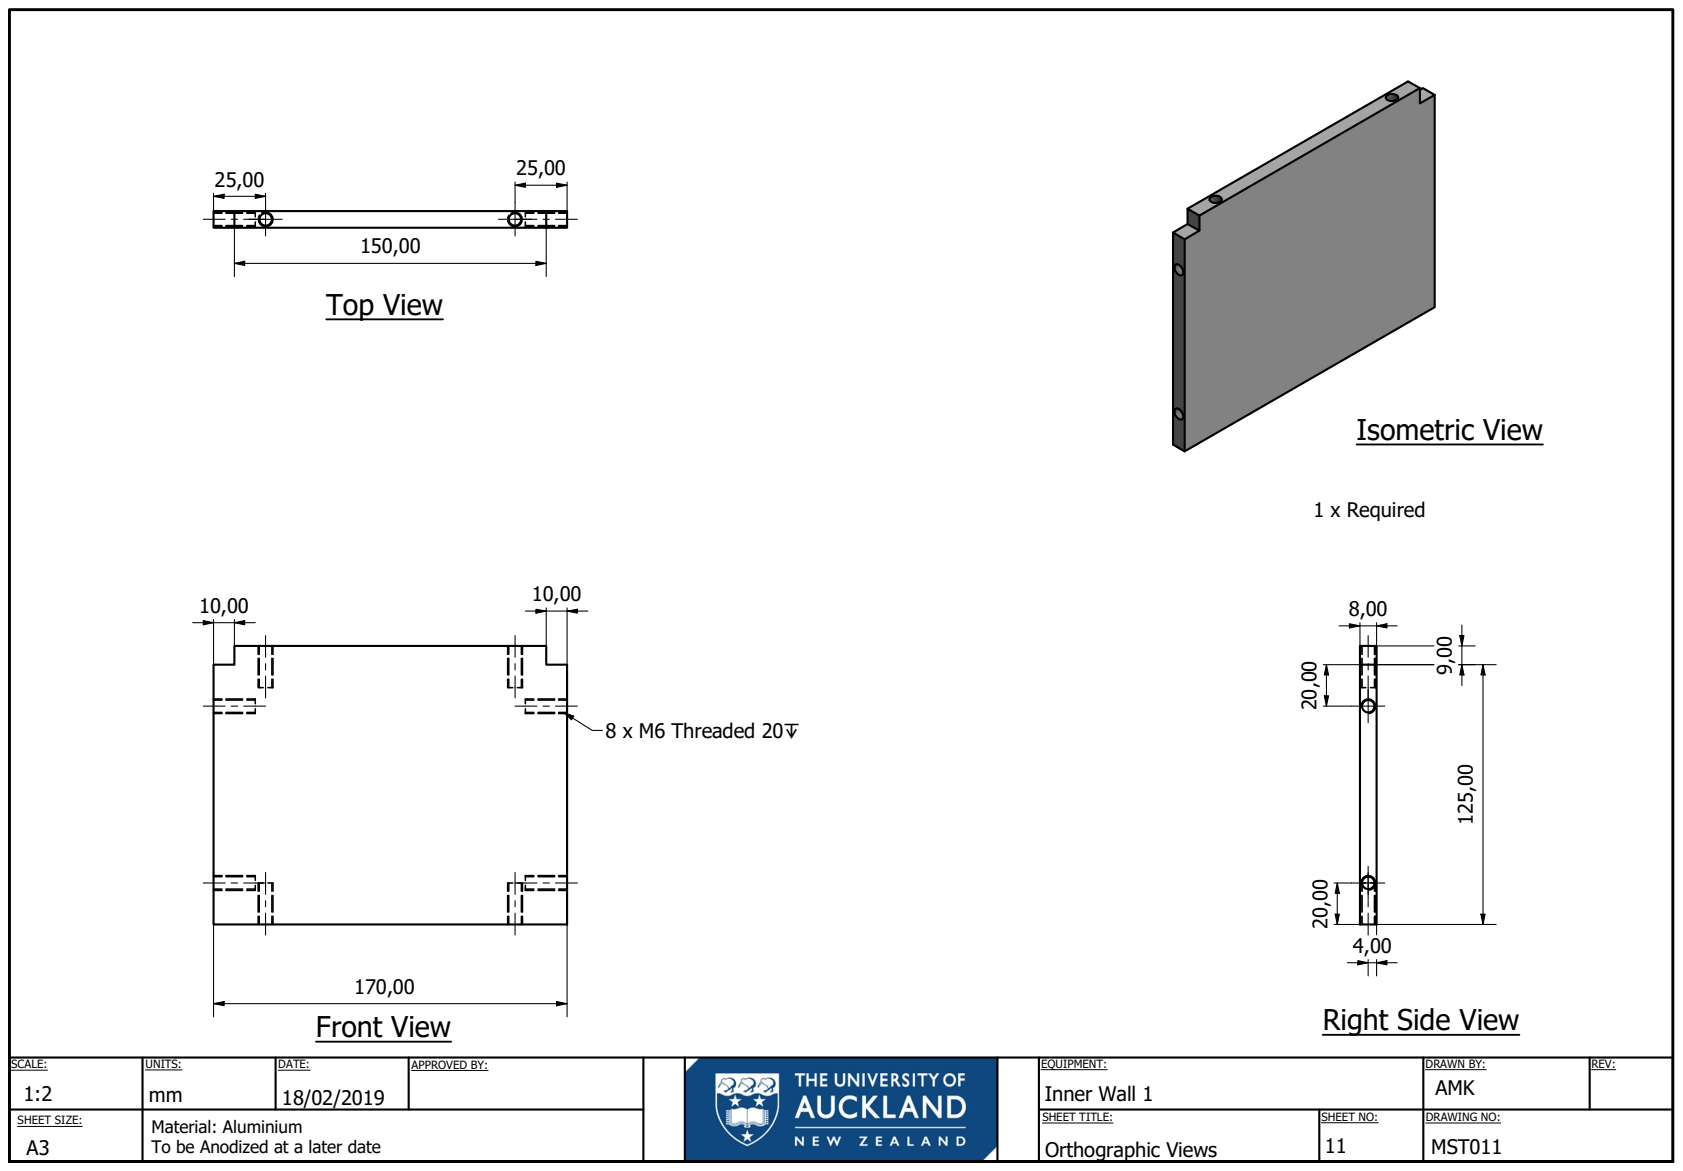
[picture p16: page 11]
SCALE:; UNITS:; DATE:; APPROVED BY:; EQUIPMENT:; DRAWN BY:; Orthographic Views; MST011; Inner Wall 1; Front View; Right Side View; Top View; Isometric View; 1 x Required

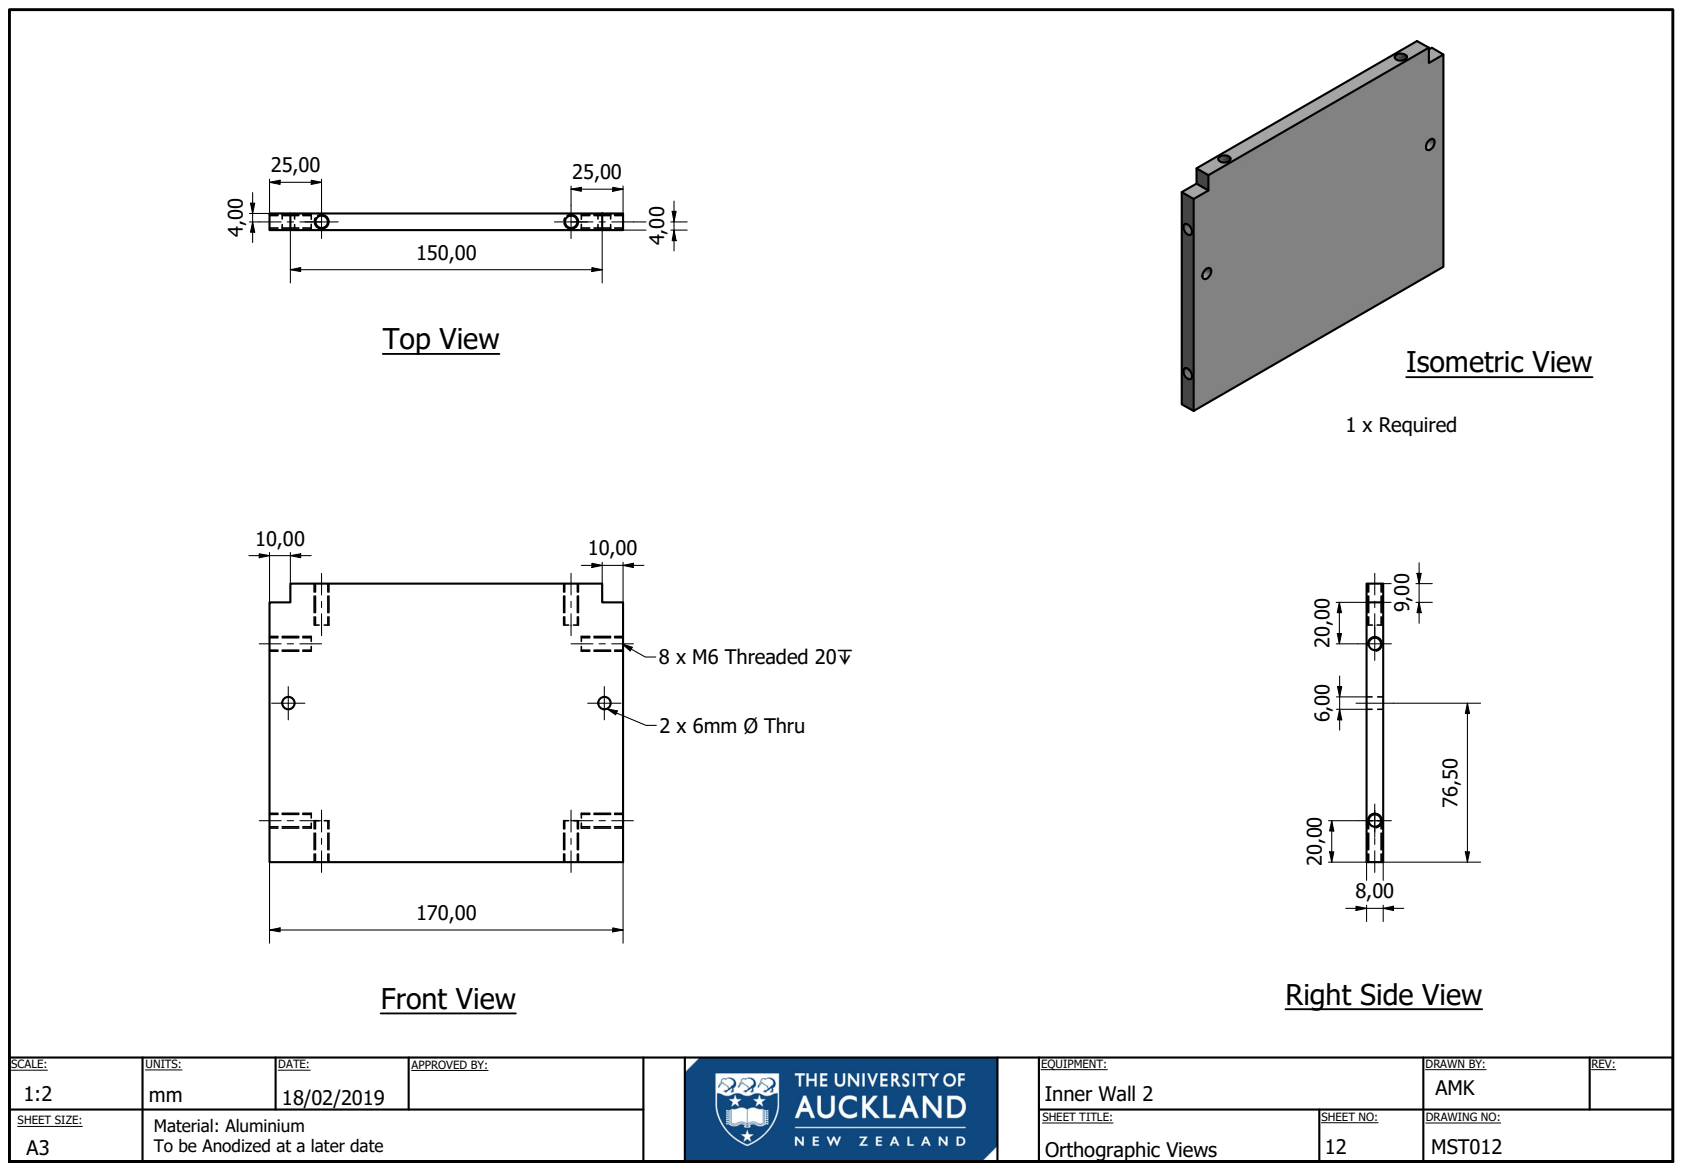
[picture p17: page 12]
SCALE:; UNITS:; DATE:; APPROVED BY:; EQUIPMENT:; DRAWN BY:; Orthographic Views; MST012; Inner Wall 2; Front View; Right Side View; Top View; Isometric View; 2 x 6mm Ø Thru; 1 x Required

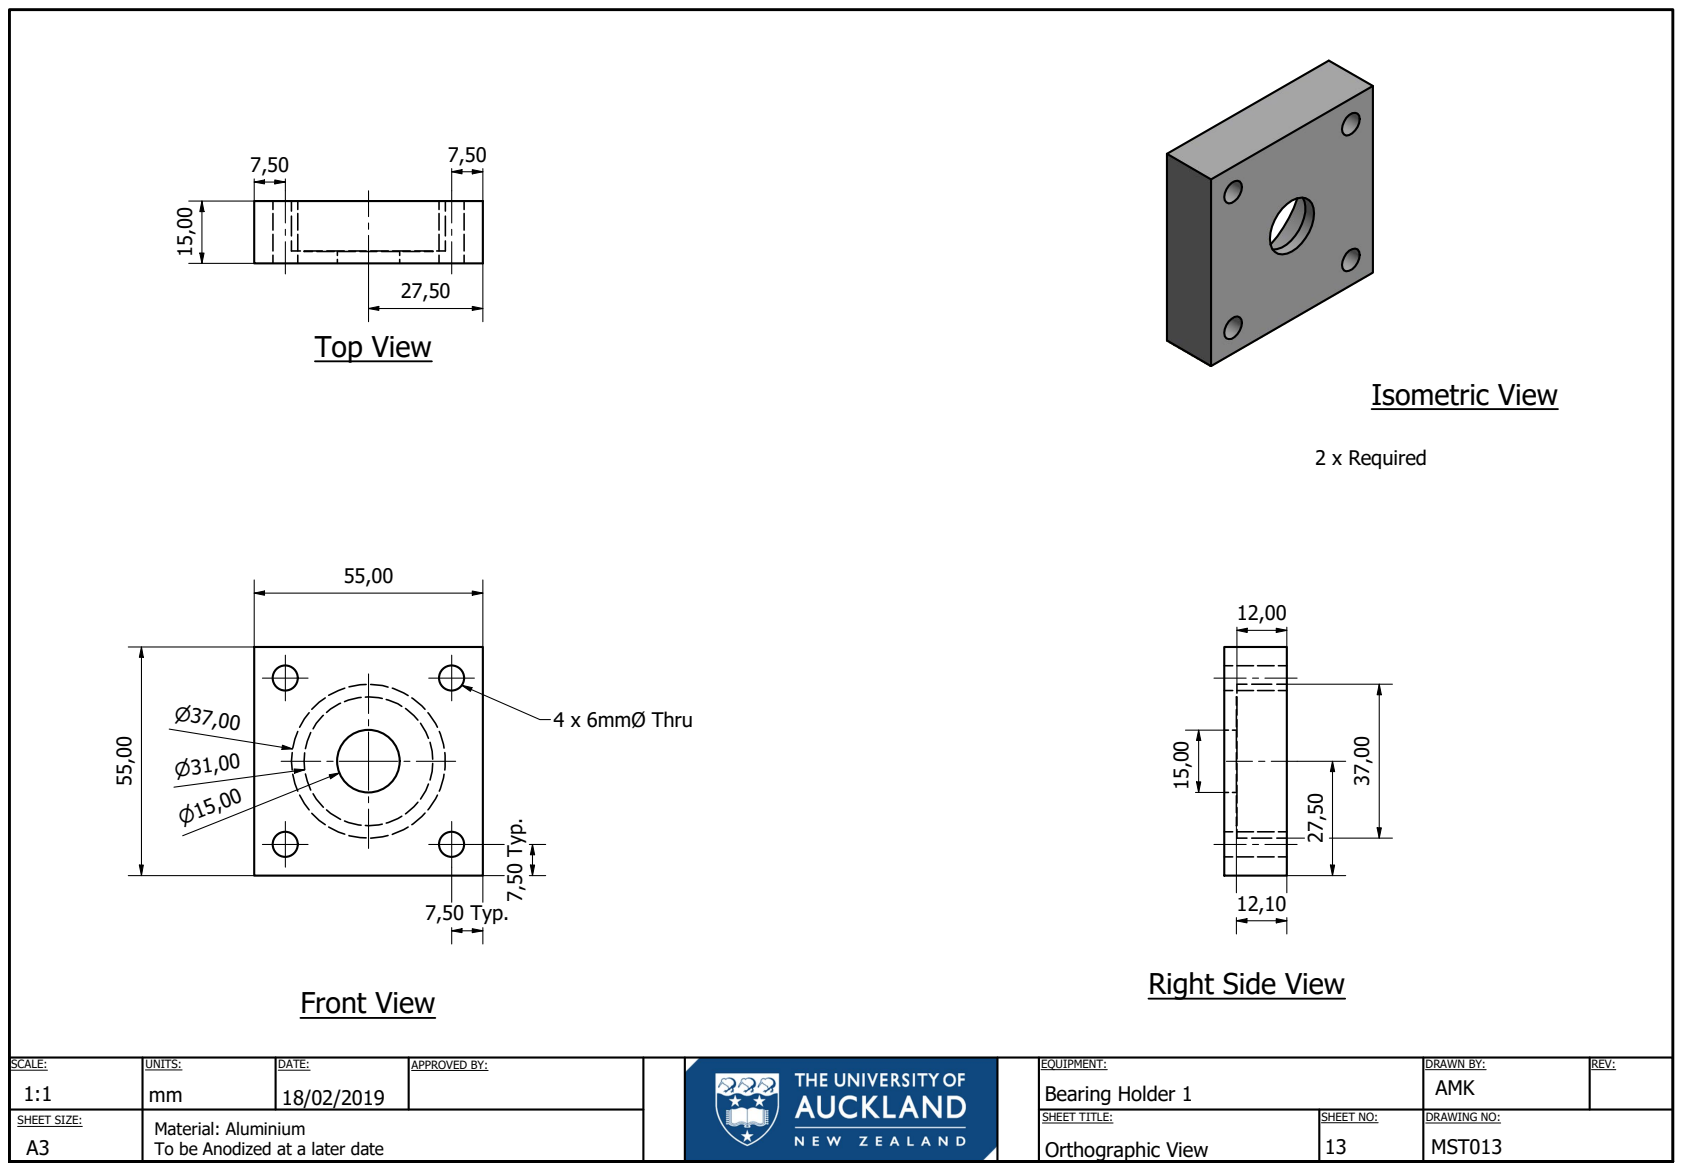
[picture p18: page 13]
SCALE:; UNITS:; DATE:; APPROVED BY:; EQUIPMENT:; DRAWN BY:; Orthographic View; MST013; Bearing Holder 1; Front View; Top View; Isometric View; 4 x 6mmØ Thru; 7,50 Typ.; 2 x Required

Right Side View

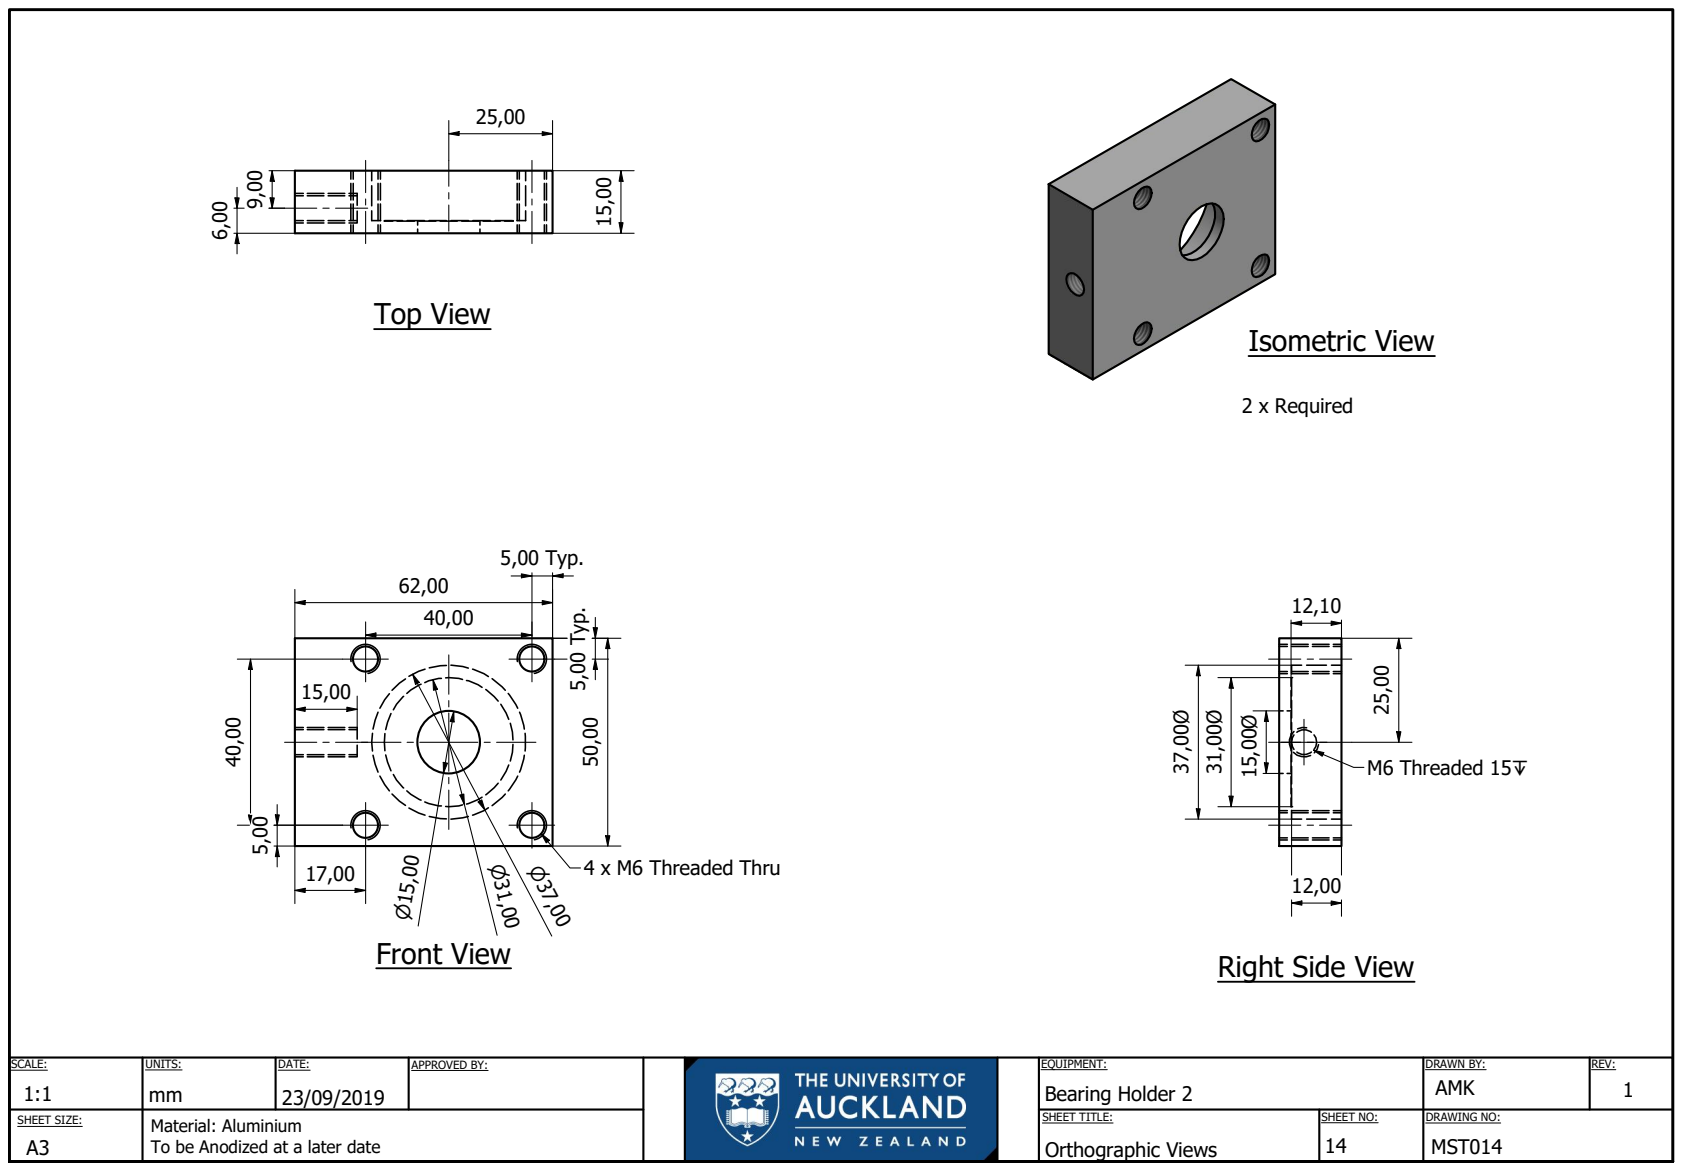
[picture p19: page 14]
4 x M6 Threaded Thru; 5,00 Typ.; Front View; Top View; Isometric View; 2 x Required

Right Side View

SCALE: 1:1 | UNITS: mm | DATE: 23/09/2019 | APPROVED BY: | EQUIPMENT: Bearing Holder 2 | DRAWN BY: AMK | REV: 1

Orthographic Views | 14 | MST014

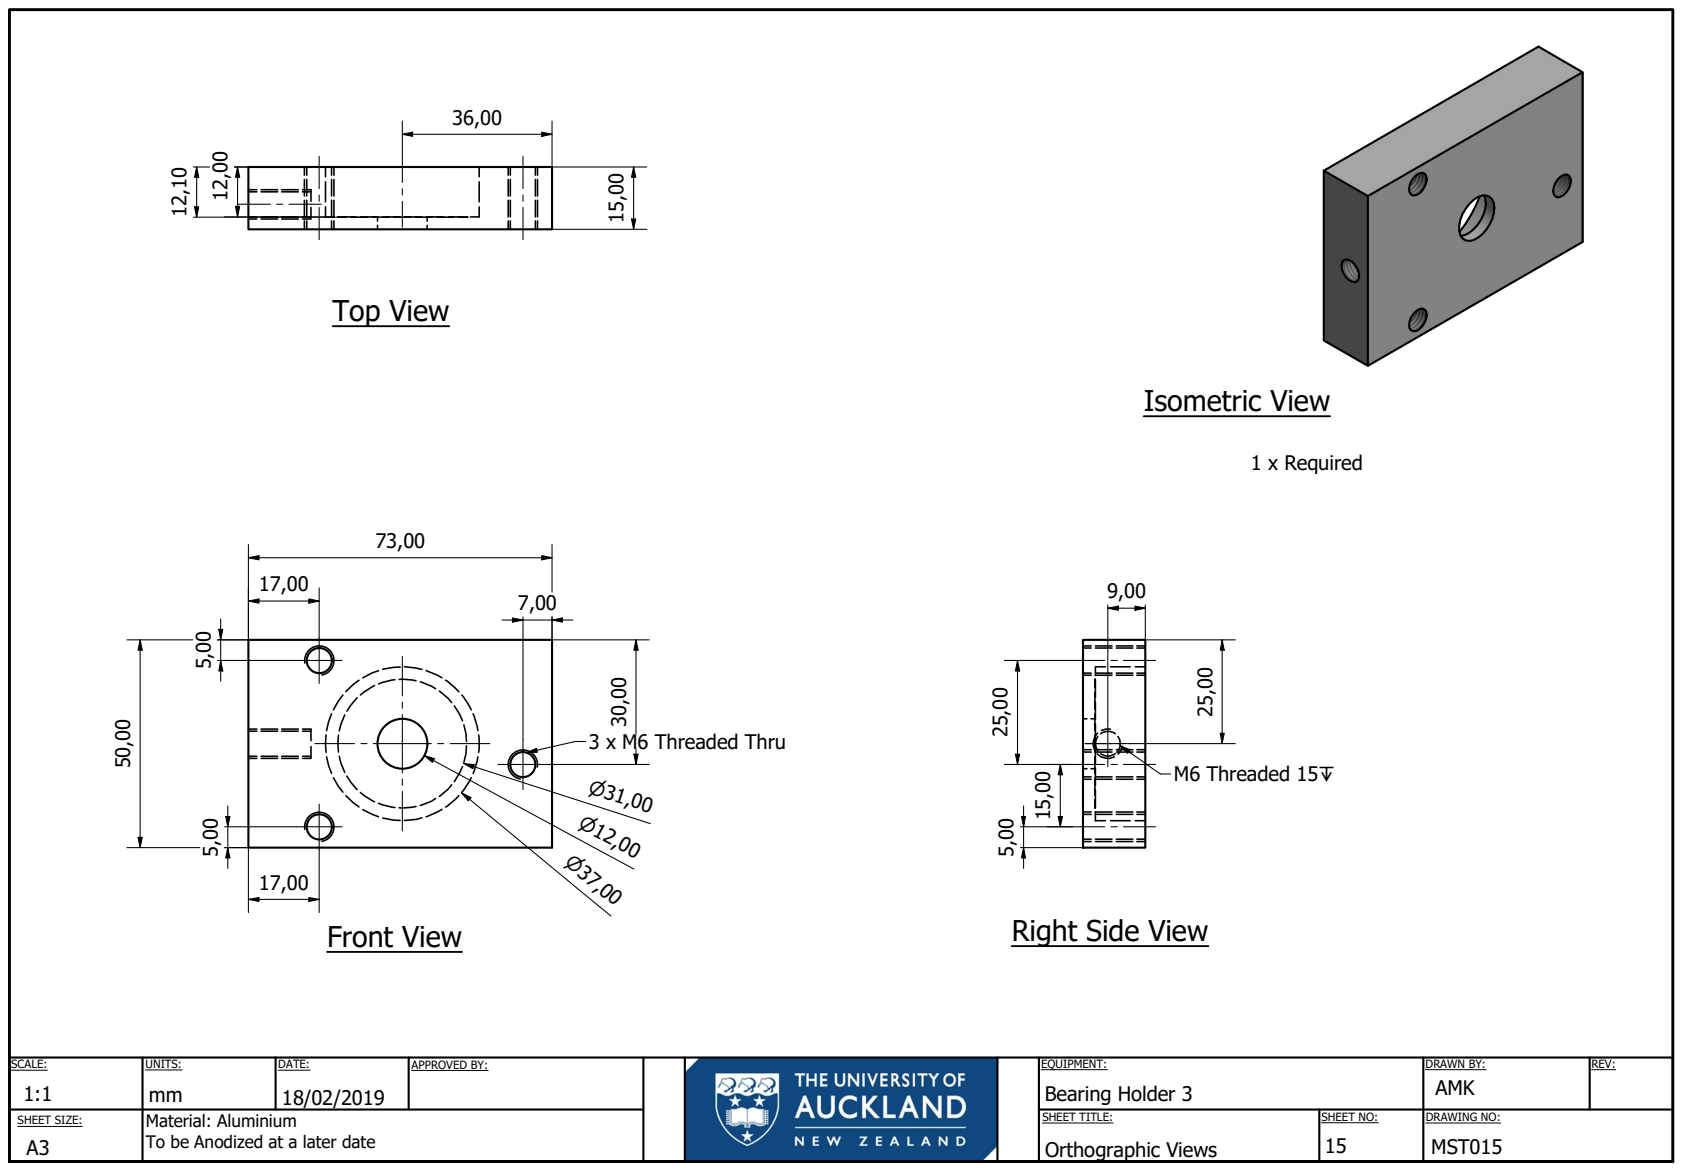
[picture p20: page 15]
SCALE:; UNITS:; DATE:; APPROVED BY:; EQUIPMENT:; DRAWN BY:; Orthographic Views; MST015; Bearing Holder 3; 3 x M6 Threaded Thru; Front View; Right Side View; Top View; Isometric View; 1 x Required

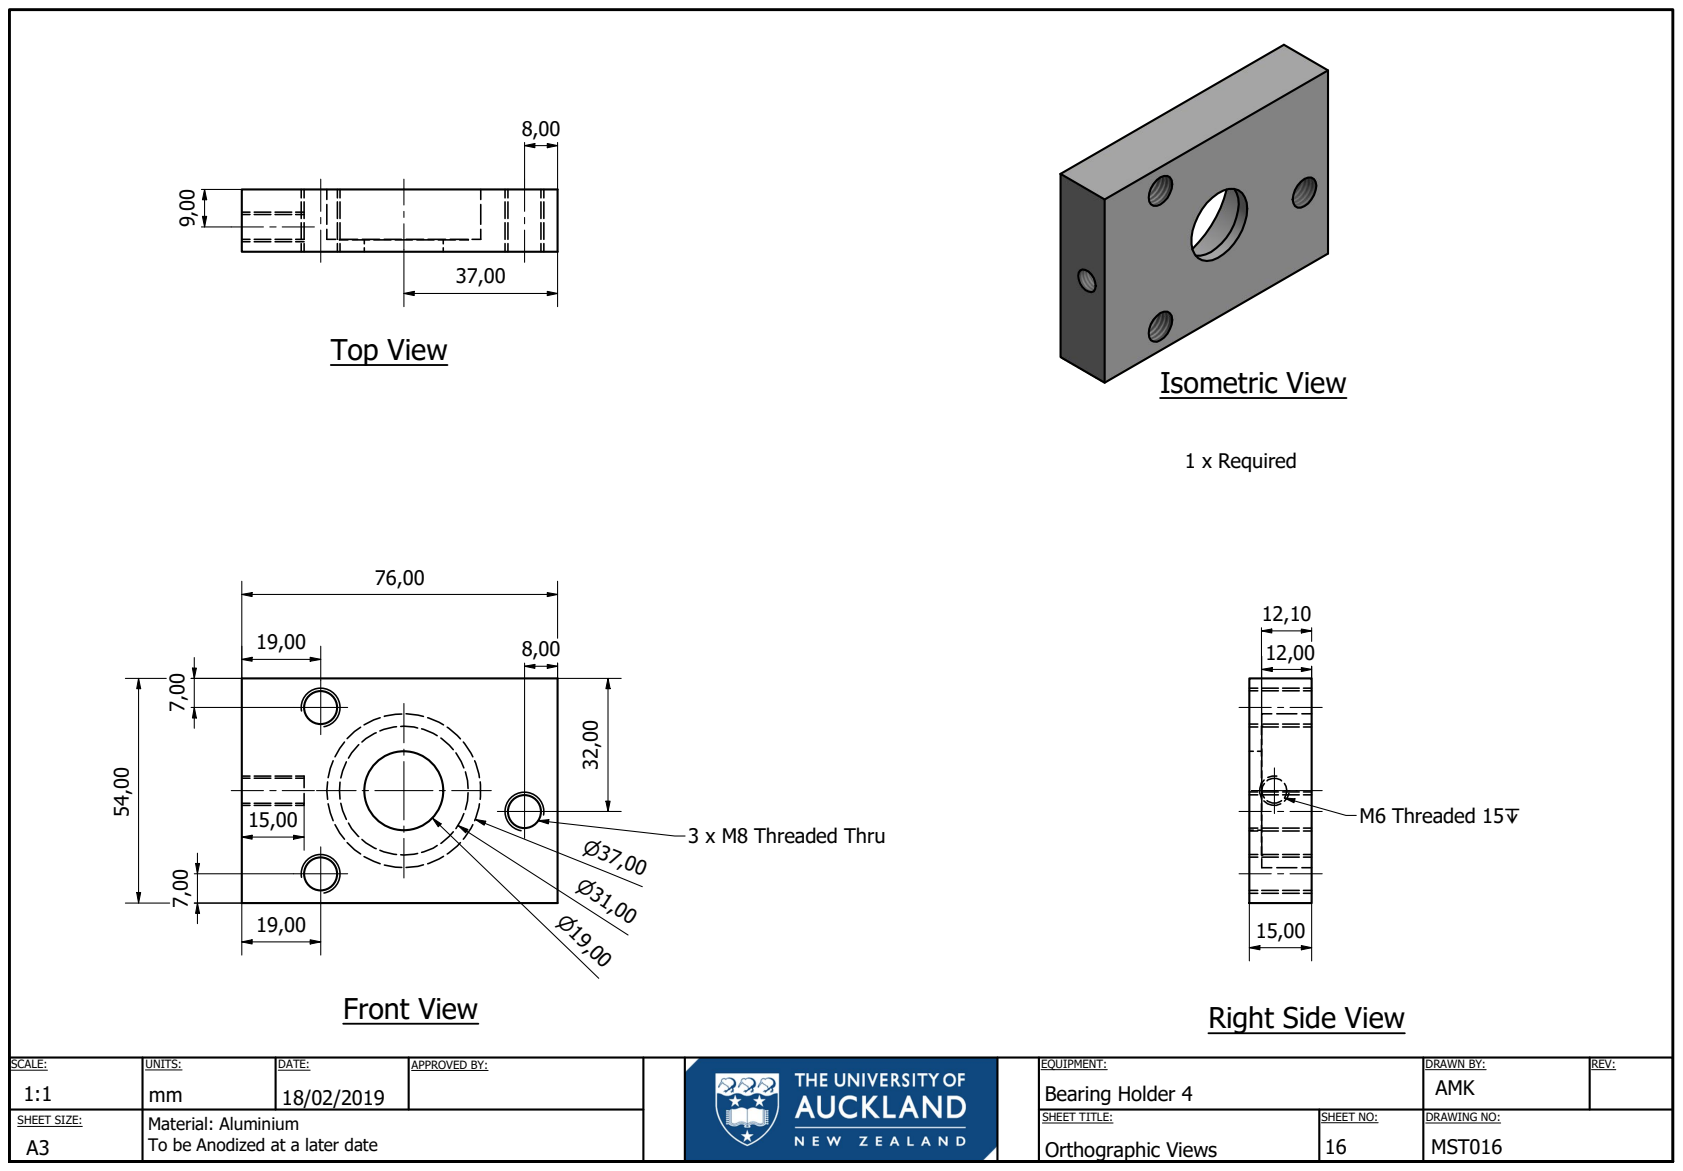
[picture p21: page 16]
Front View; Right Side View; Top View; 3 x M8 Threaded Thru; Isometric View; 1 x Required

SCALE: 1:1 | UNITS: mm | DATE: 18/02/2019 | APPROVED BY: | EQUIPMENT: Bearing Holder 4 | DRAWN BY: AMK | REV:

Orthographic Views | 16 | MST016

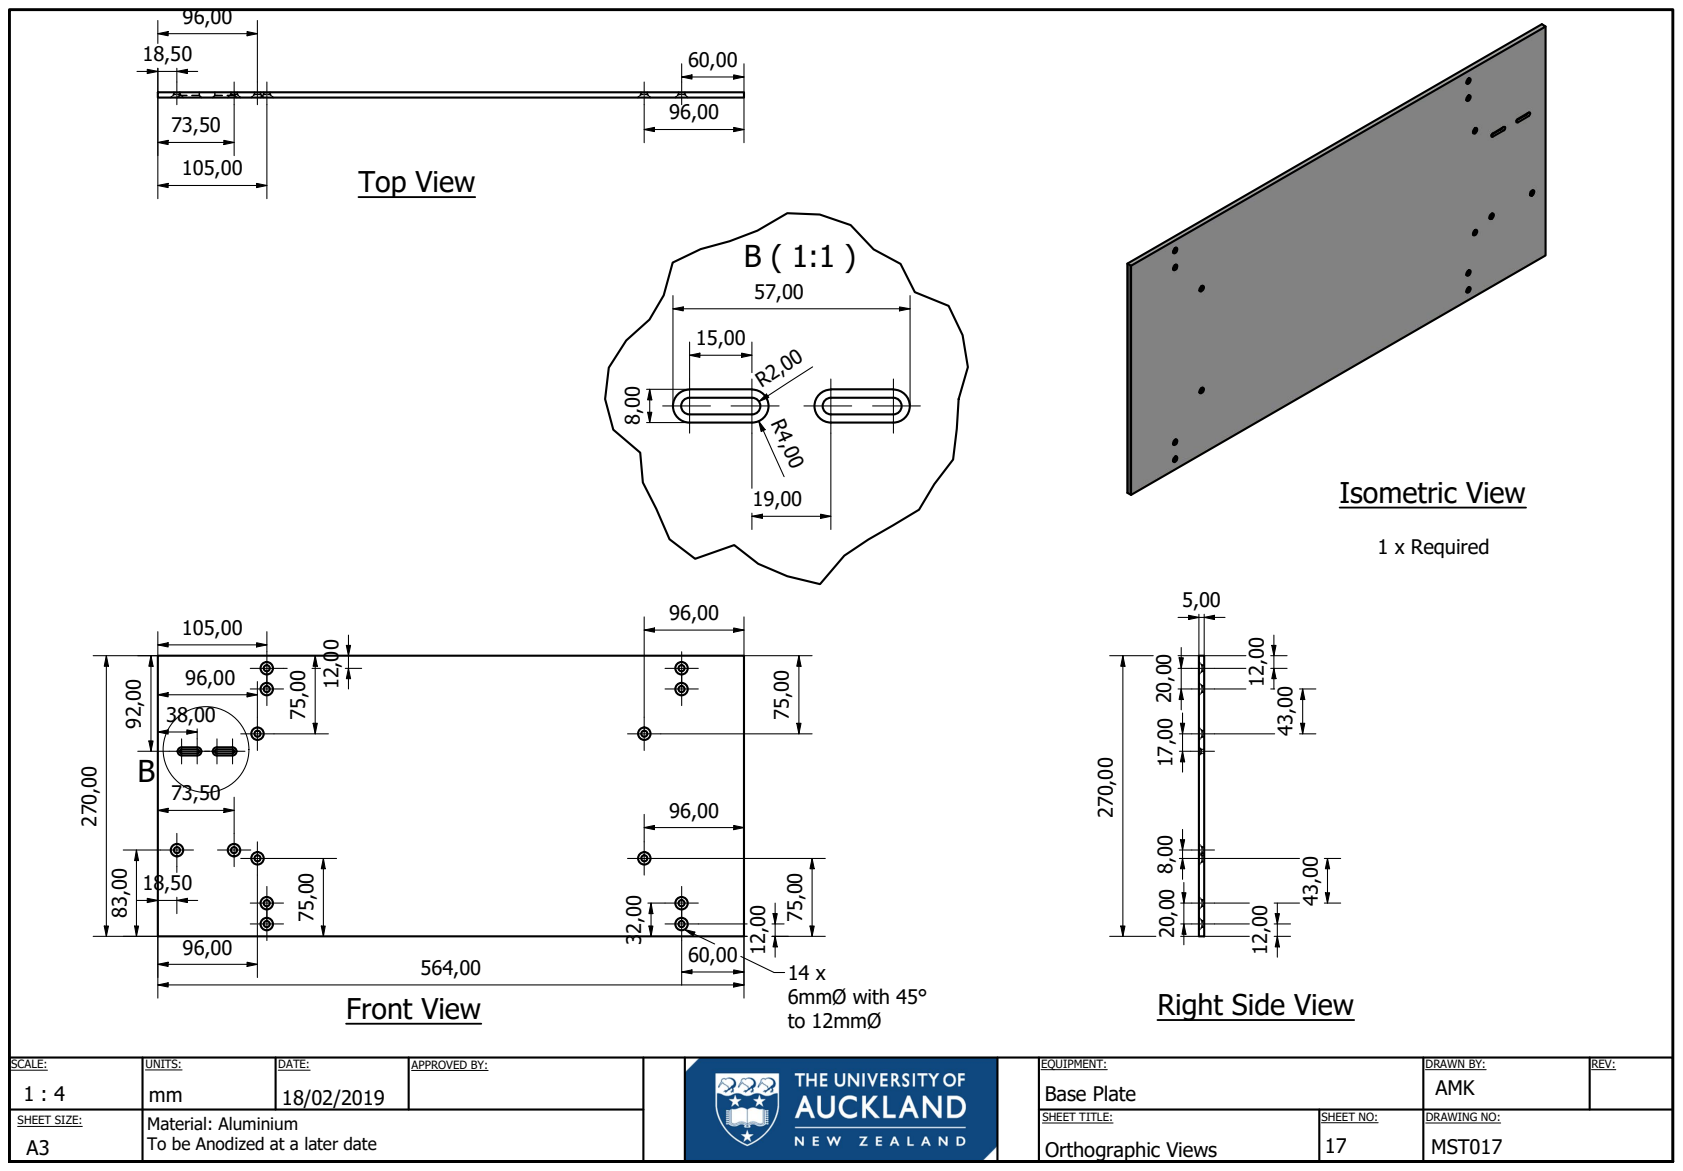
[picture p22: page 17]
SCALE:; UNITS:; DATE:; APPROVED BY:; EQUIPMENT:; DRAWN BY:; Orthographic Views; MST017; Base Plate; Front View; Top View; 14 x 6mmØ with 45° to 12mmØ; Isometric View; 1 x Required

Right Side View

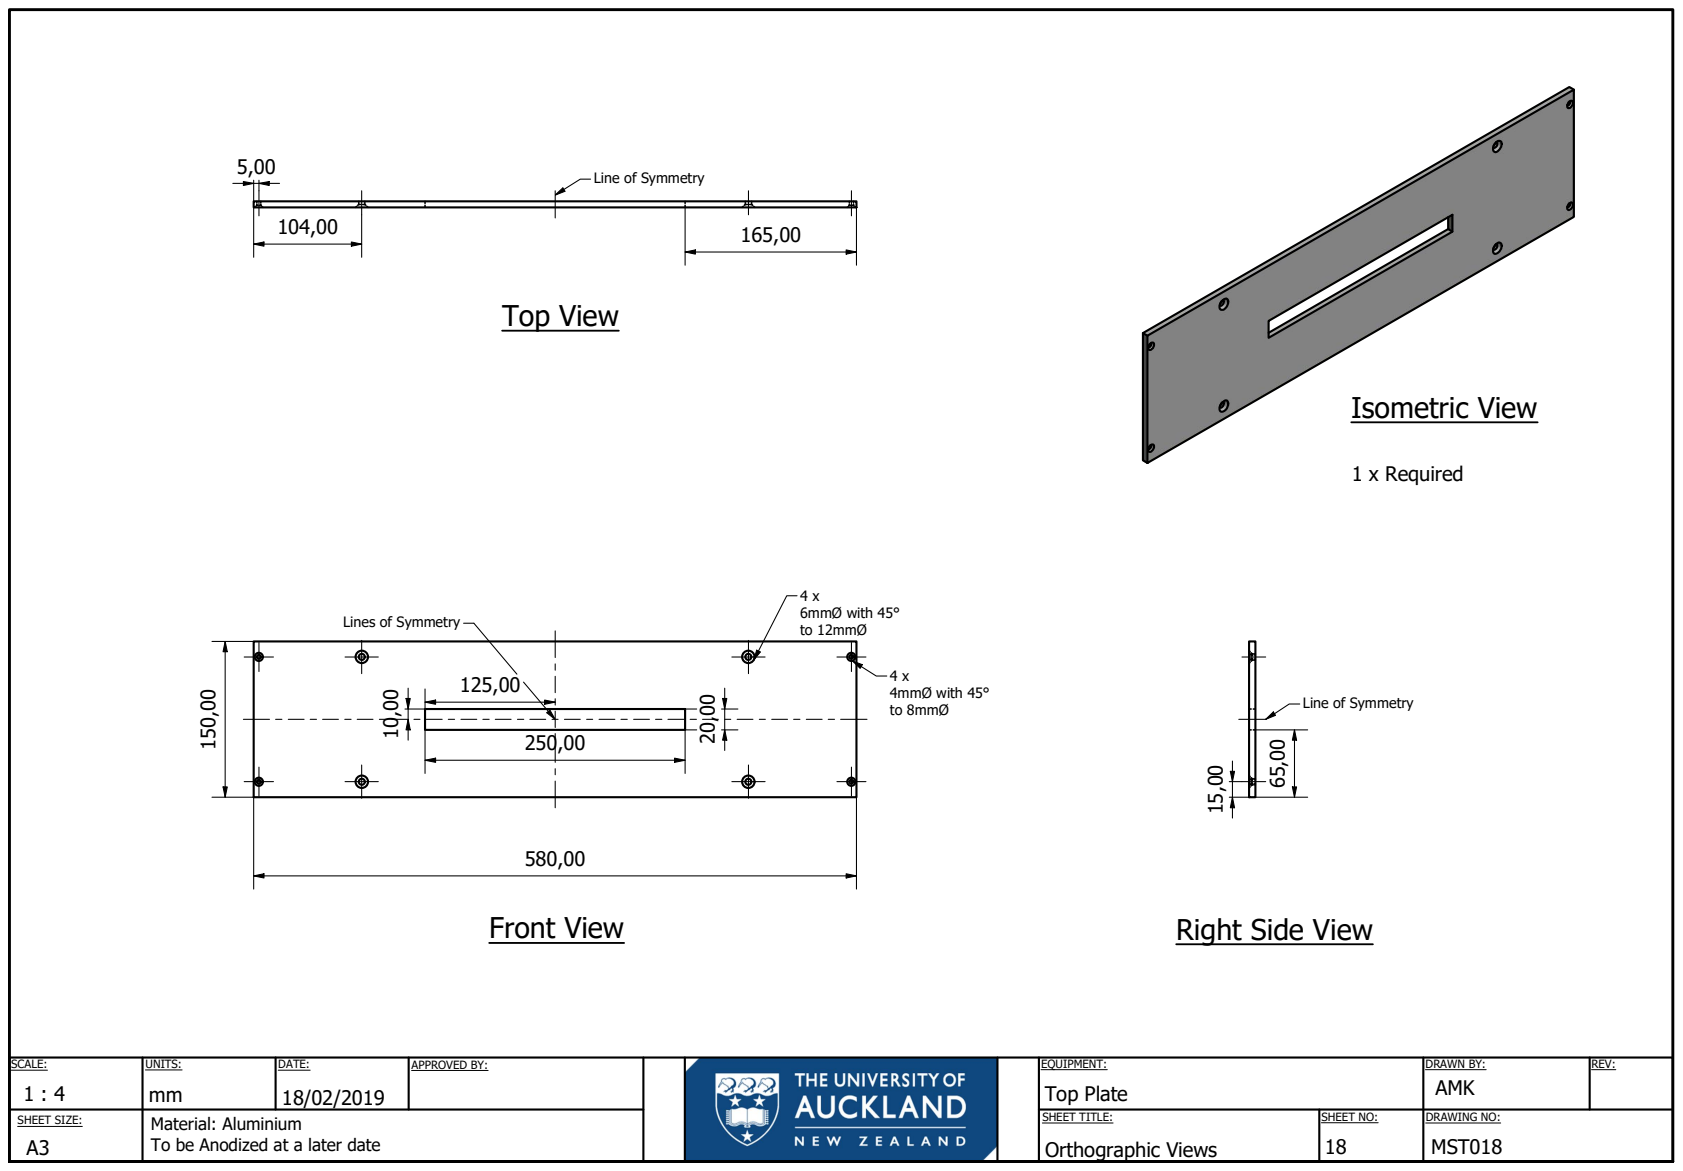
[picture p23: page 18]
4 x 4mmØ with 45° to 8mmØ; 4 x 6mmØ with 45° to 12mmØ; Front View; Right Side View; Top View; Isometric View; 1 x Required

Line of Symmetry

Lines of Symmetry

SCALE: 1 : 4 | UNITS: mm | DATE: 18/02/2019 | APPROVED BY: | EQUIPMENT: Top Plate | DRAWN BY: AMK | REV:

Orthographic Views | 18 | MST018

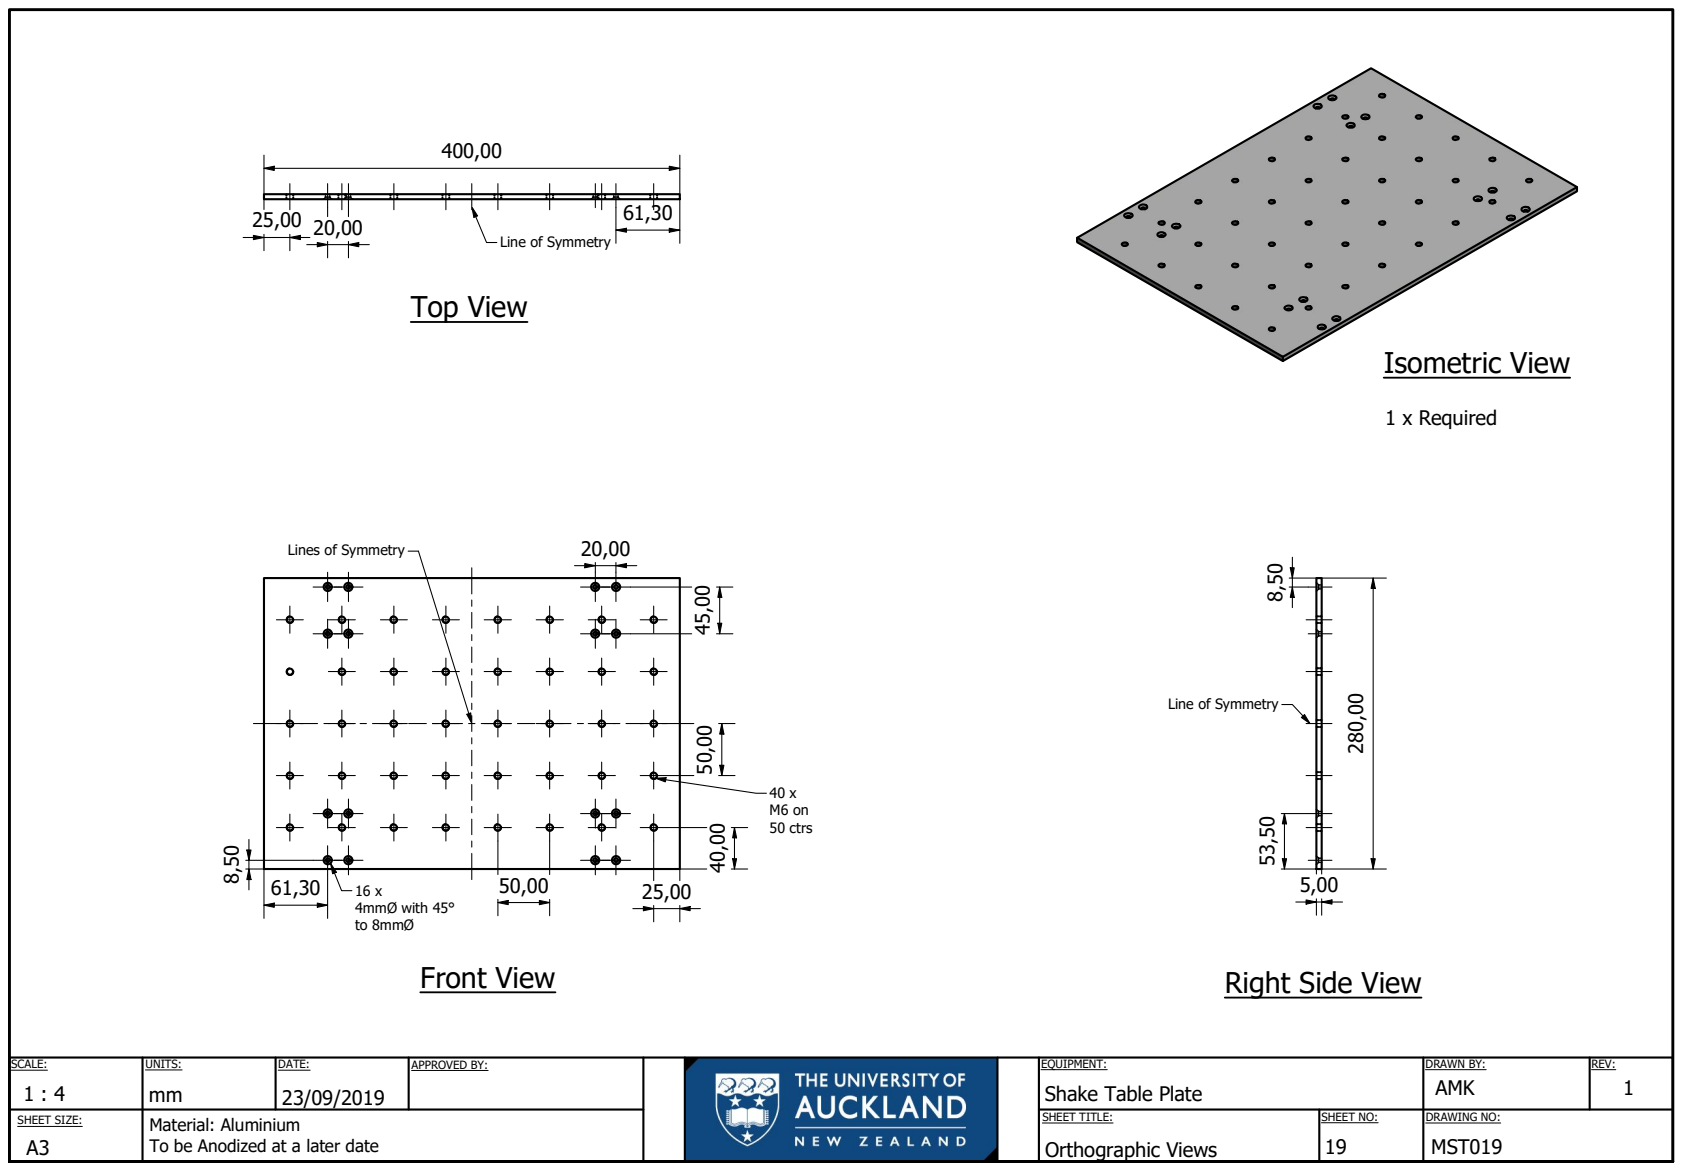
[picture p24: page 19]
40 x M6 on 50 ctrs; 4mmØ with 45° to 8mmØ; Front View; Right Side View; Top View; Isometric View; 1 x Required

Line of Symmetry

Lines of Symmetry

SCALE: 1 : 4 | UNITS: mm | DATE: 23/09/2019 | APPROVED BY: | EQUIPMENT: Shake Table Plate | DRAWN BY: AMK | REV: 1

Orthographic Views | 19 | MST019

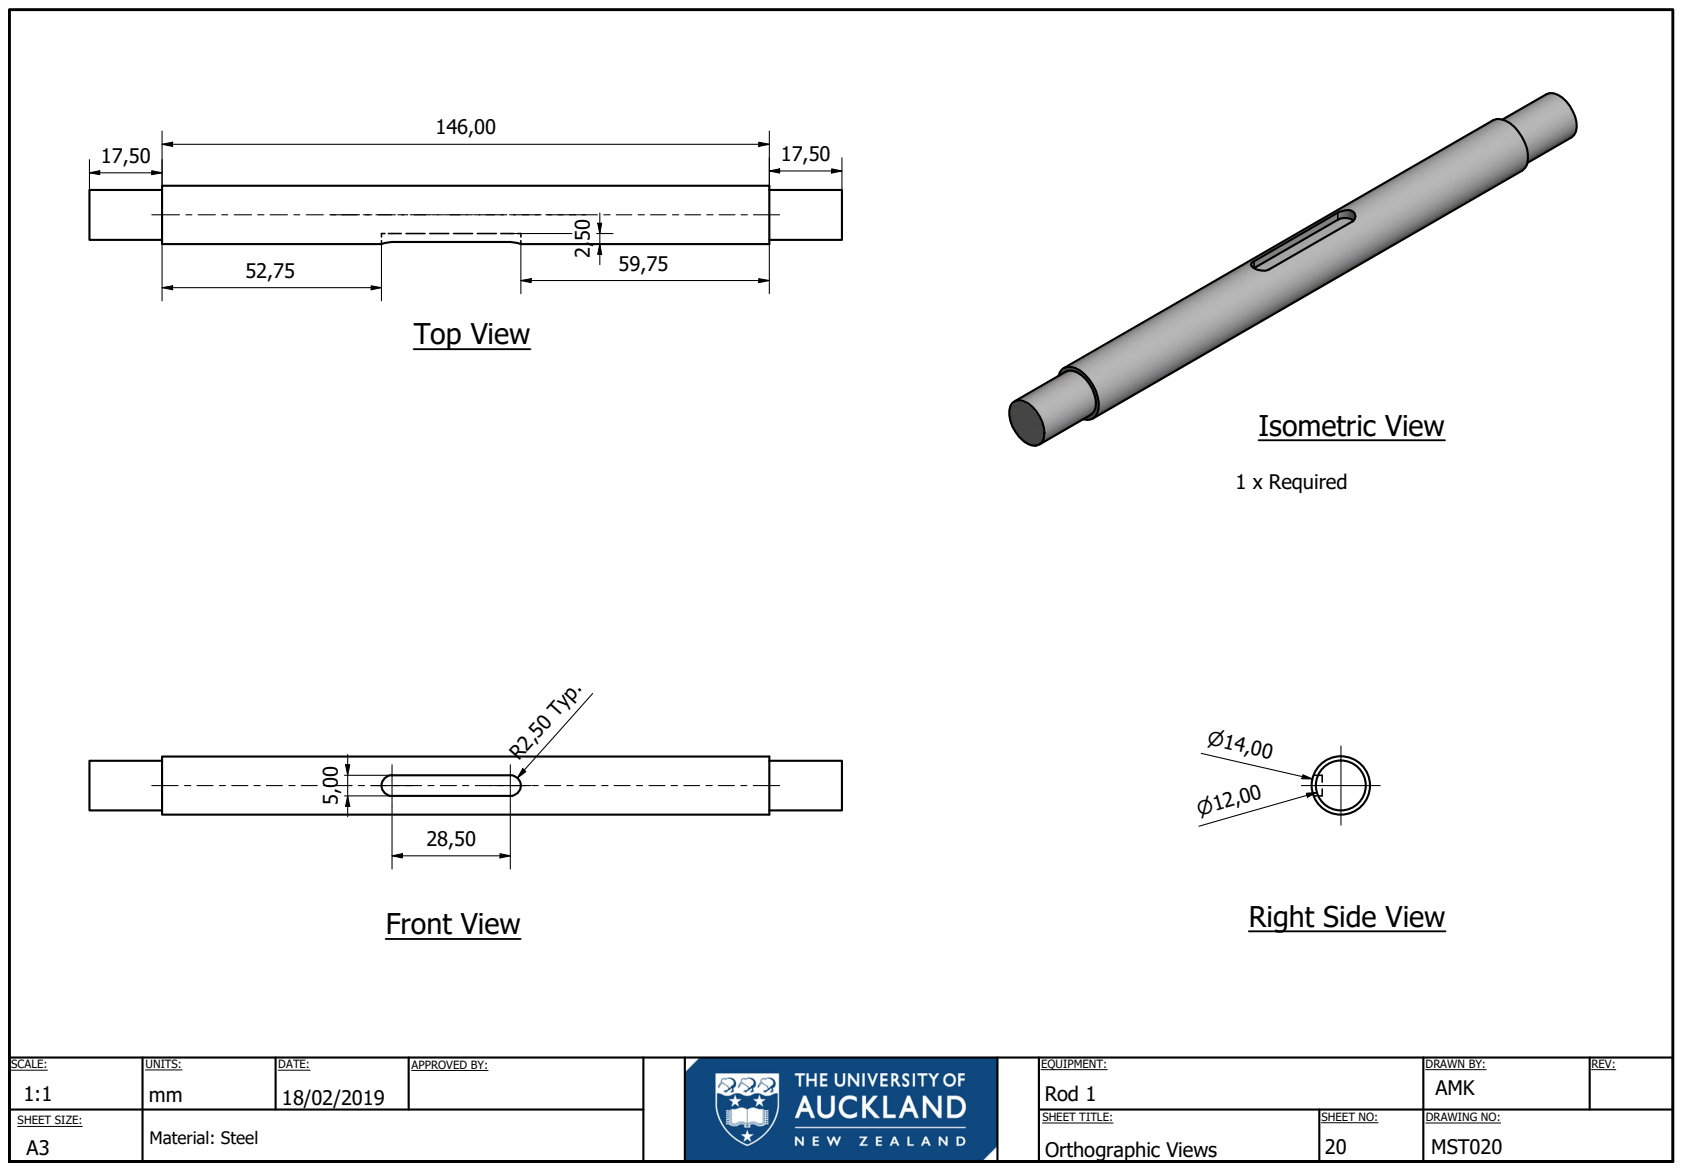
[picture p25: page 20]
Front View; Right Side View; Top View; Isometric View; R2,50 Typ.; 1 x Required

SCALE: 1:1 | UNITS: mm | DATE: 18/02/2019 | APPROVED BY: | | | EQUIPMENT: Rod 1 | DRAWN BY: AMK | REV:

Material: Steel | | | Orthographic Views | 20 | MST020

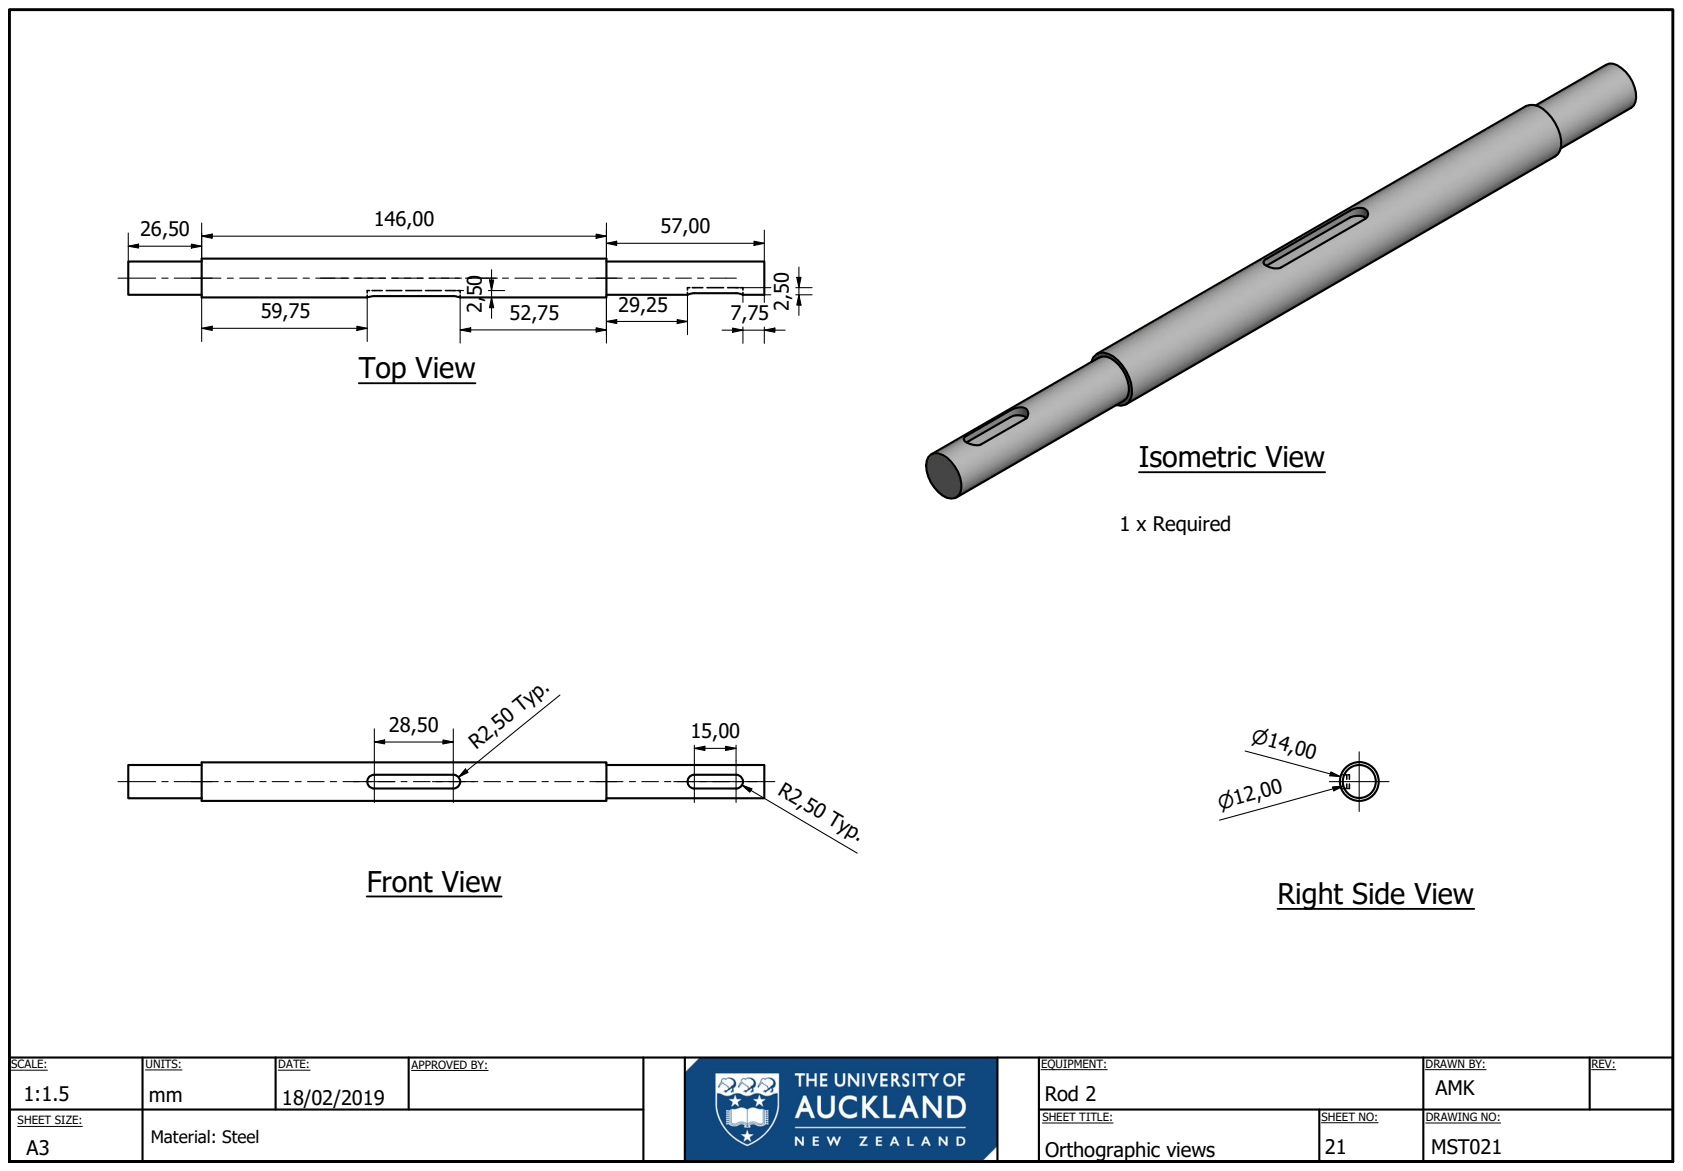
[picture p26: page 21]
SCALE:; UNITS:; DATE:; APPROVED BY:; EQUIPMENT:; DRAWN BY:; Orthographic views; MST021; Rod 2; Isometric View; Front View; Right Side View; Top View; R2,50 Typ.; Material: Steel; 1 x Required

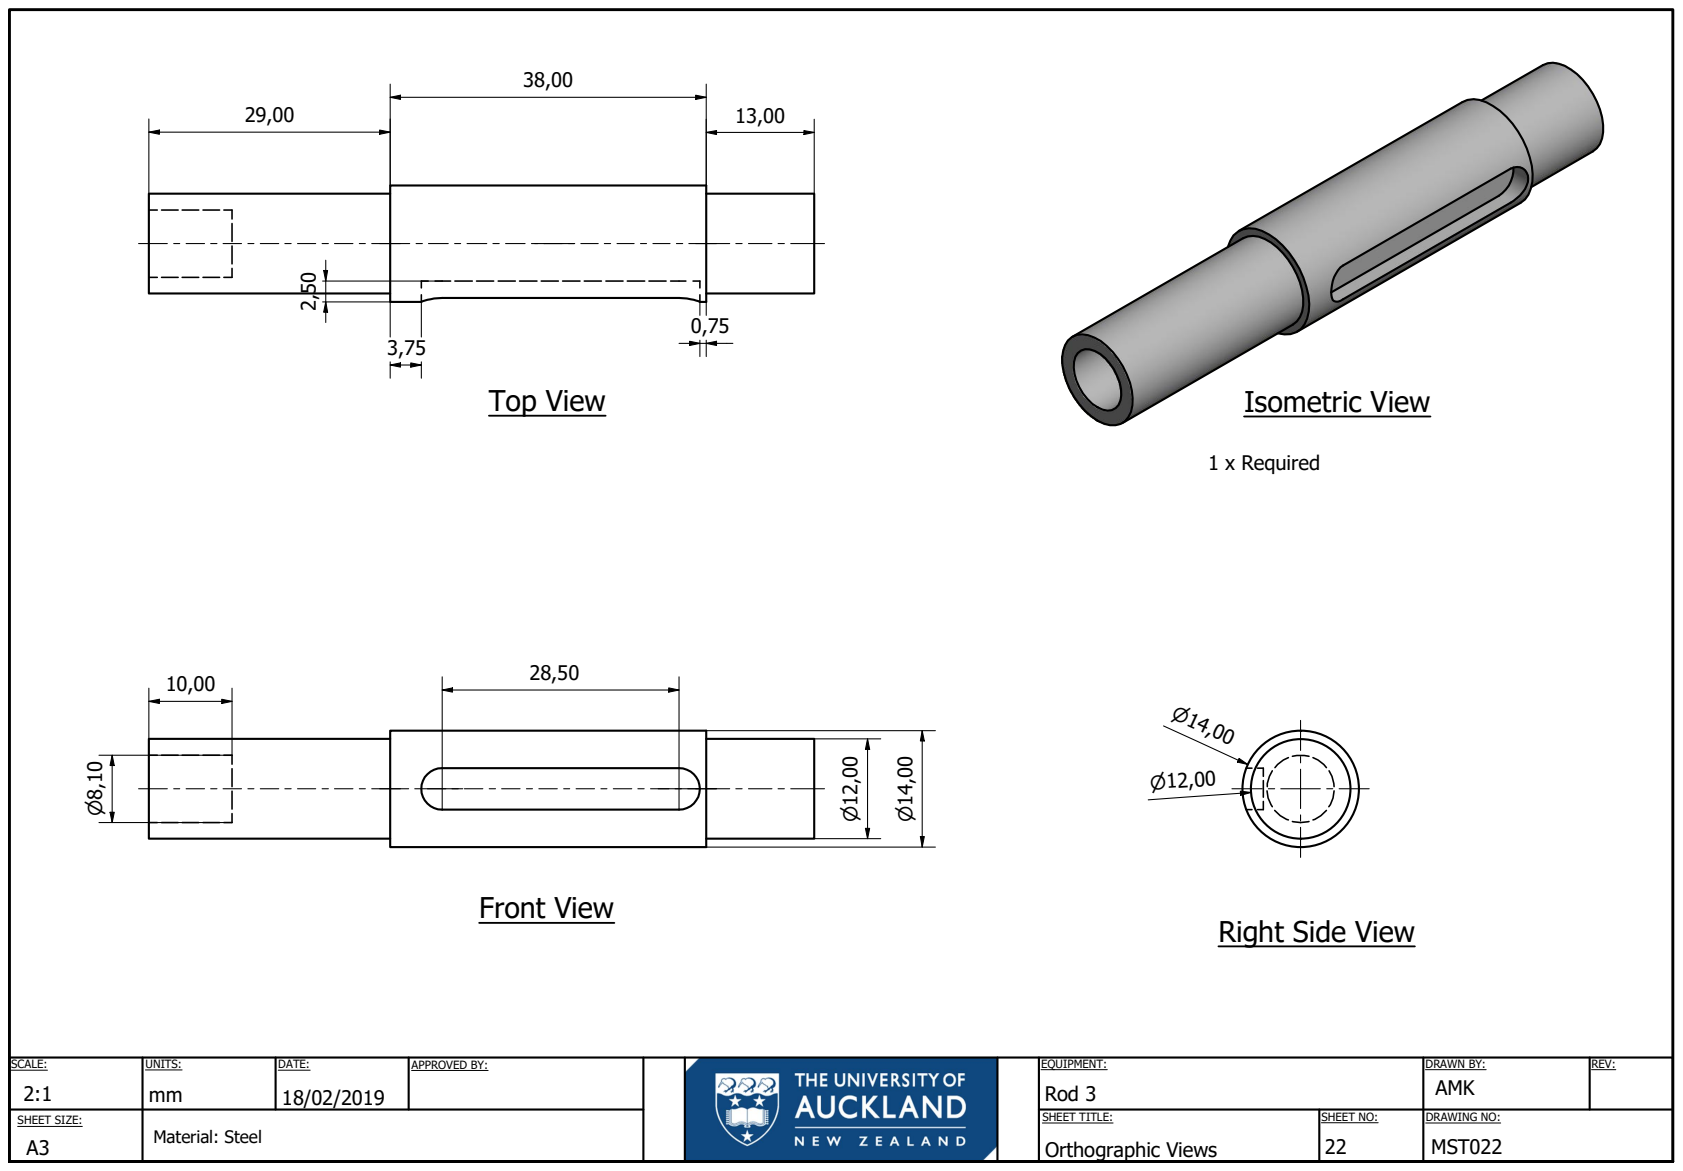
[picture p27: page 22]
Front View; Top View; Isometric View; 1 x Required

Right Side View

SCALE: 2:1 | UNITS: mm | DATE: 18/02/2019 | APPROVED BY: | | | EQUIPMENT: Rod 3 | DRAWN BY: AMK | REV:

Material: Steel | | | Orthographic Views | 22 | MST022

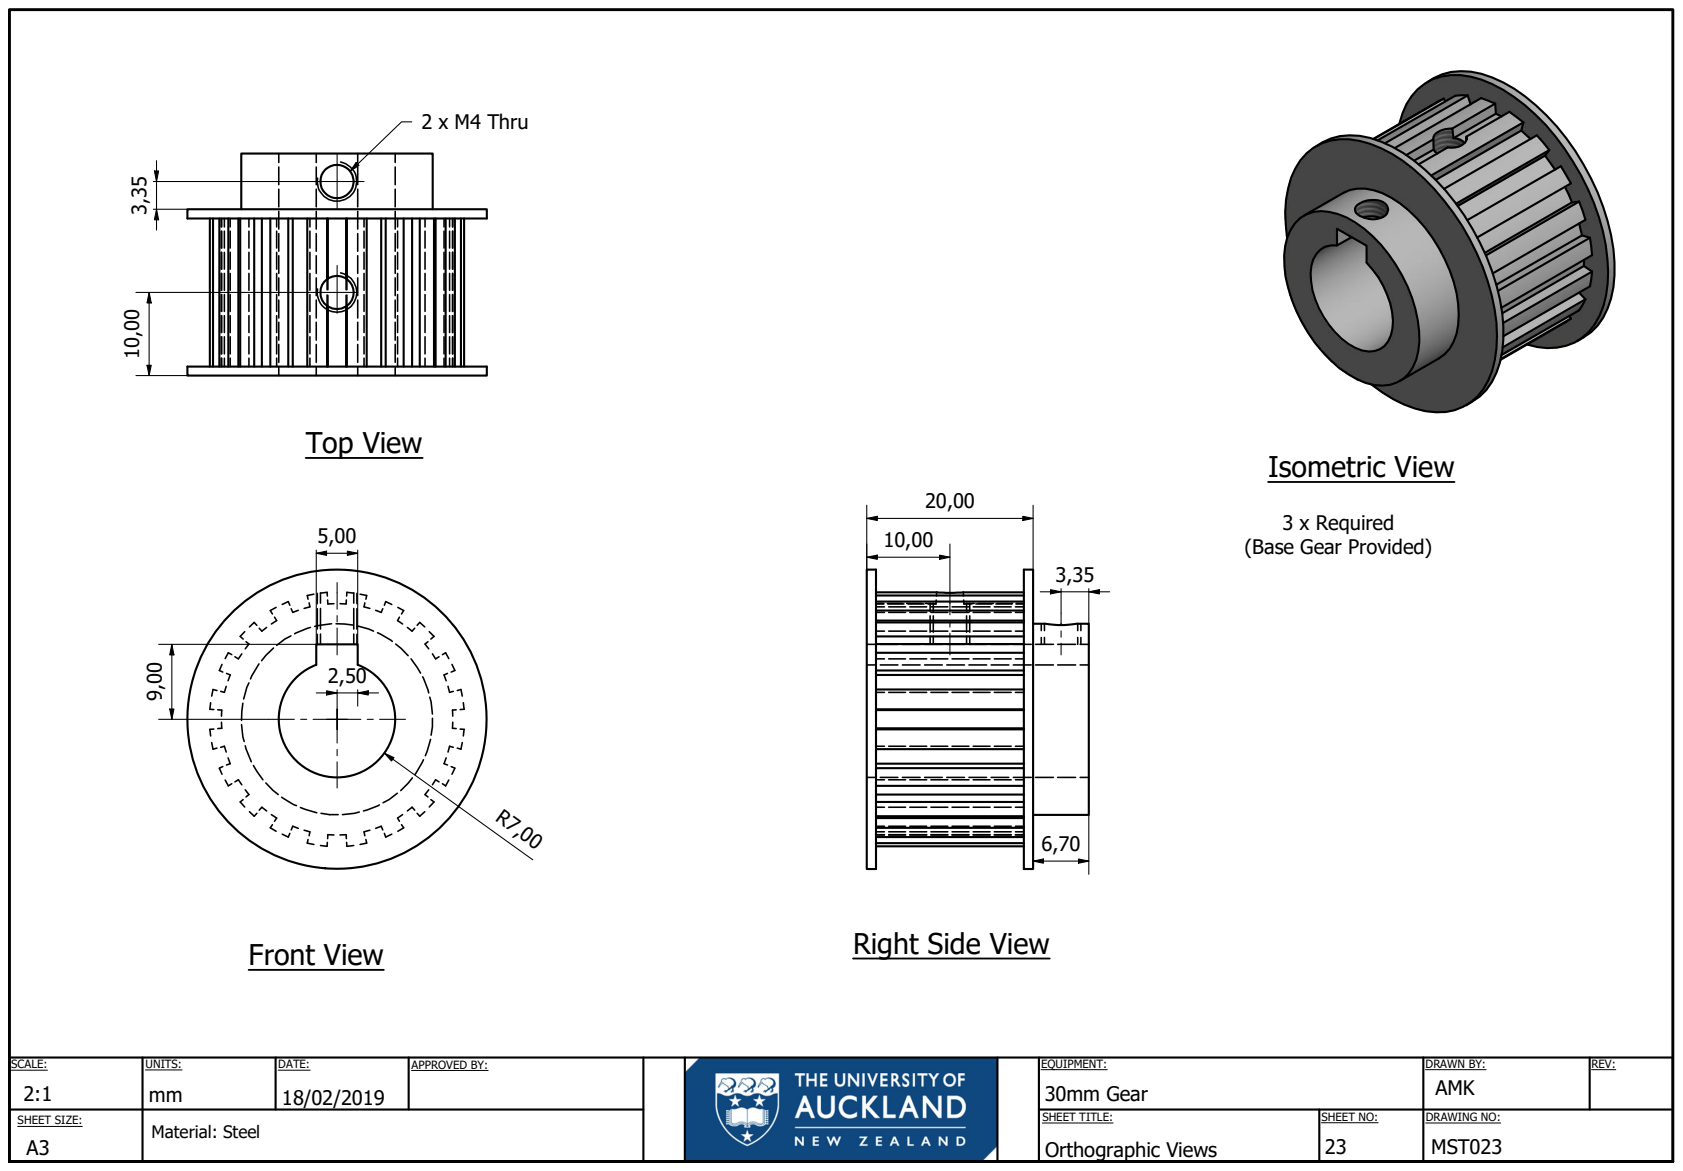
[picture p28: page 23]
SCALE:; UNITS:; DATE:; APPROVED BY:; EQUIPMENT:; DRAWN BY:; Orthographic Views; MST023; 30mm Gear; AMK; 2 x M4 Thru; Front View; Top View; Isometric View; Material: Steel

3 x Required
(Base Gear Provided)

Right Side View

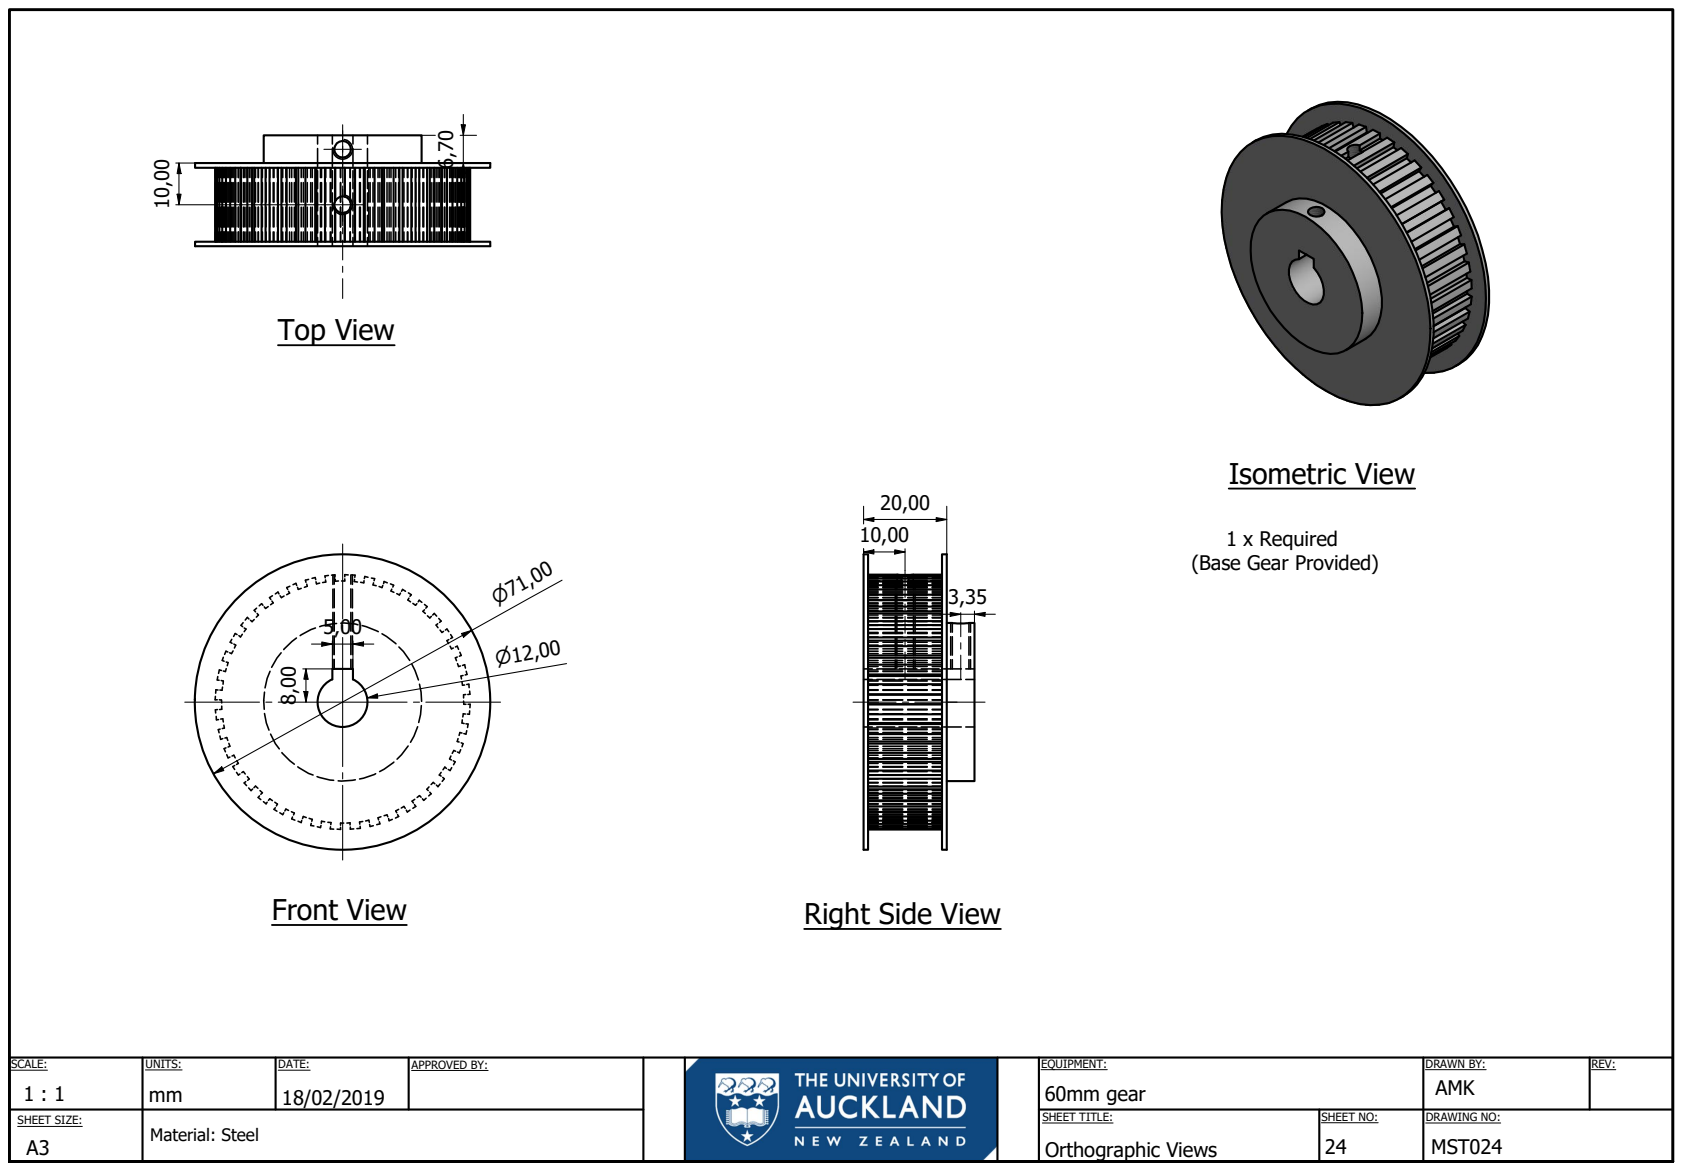
[picture p29: page 24]
SCALE:; UNITS:; DATE:; APPROVED BY:; EQUIPMENT:; DRAWN BY:; Orthographic Views; MST024; 60mm gear; AMK; Isometric View; Front View; Right Side View; Top View; Material: Steel

1 x Required
(Base Gear Provided)

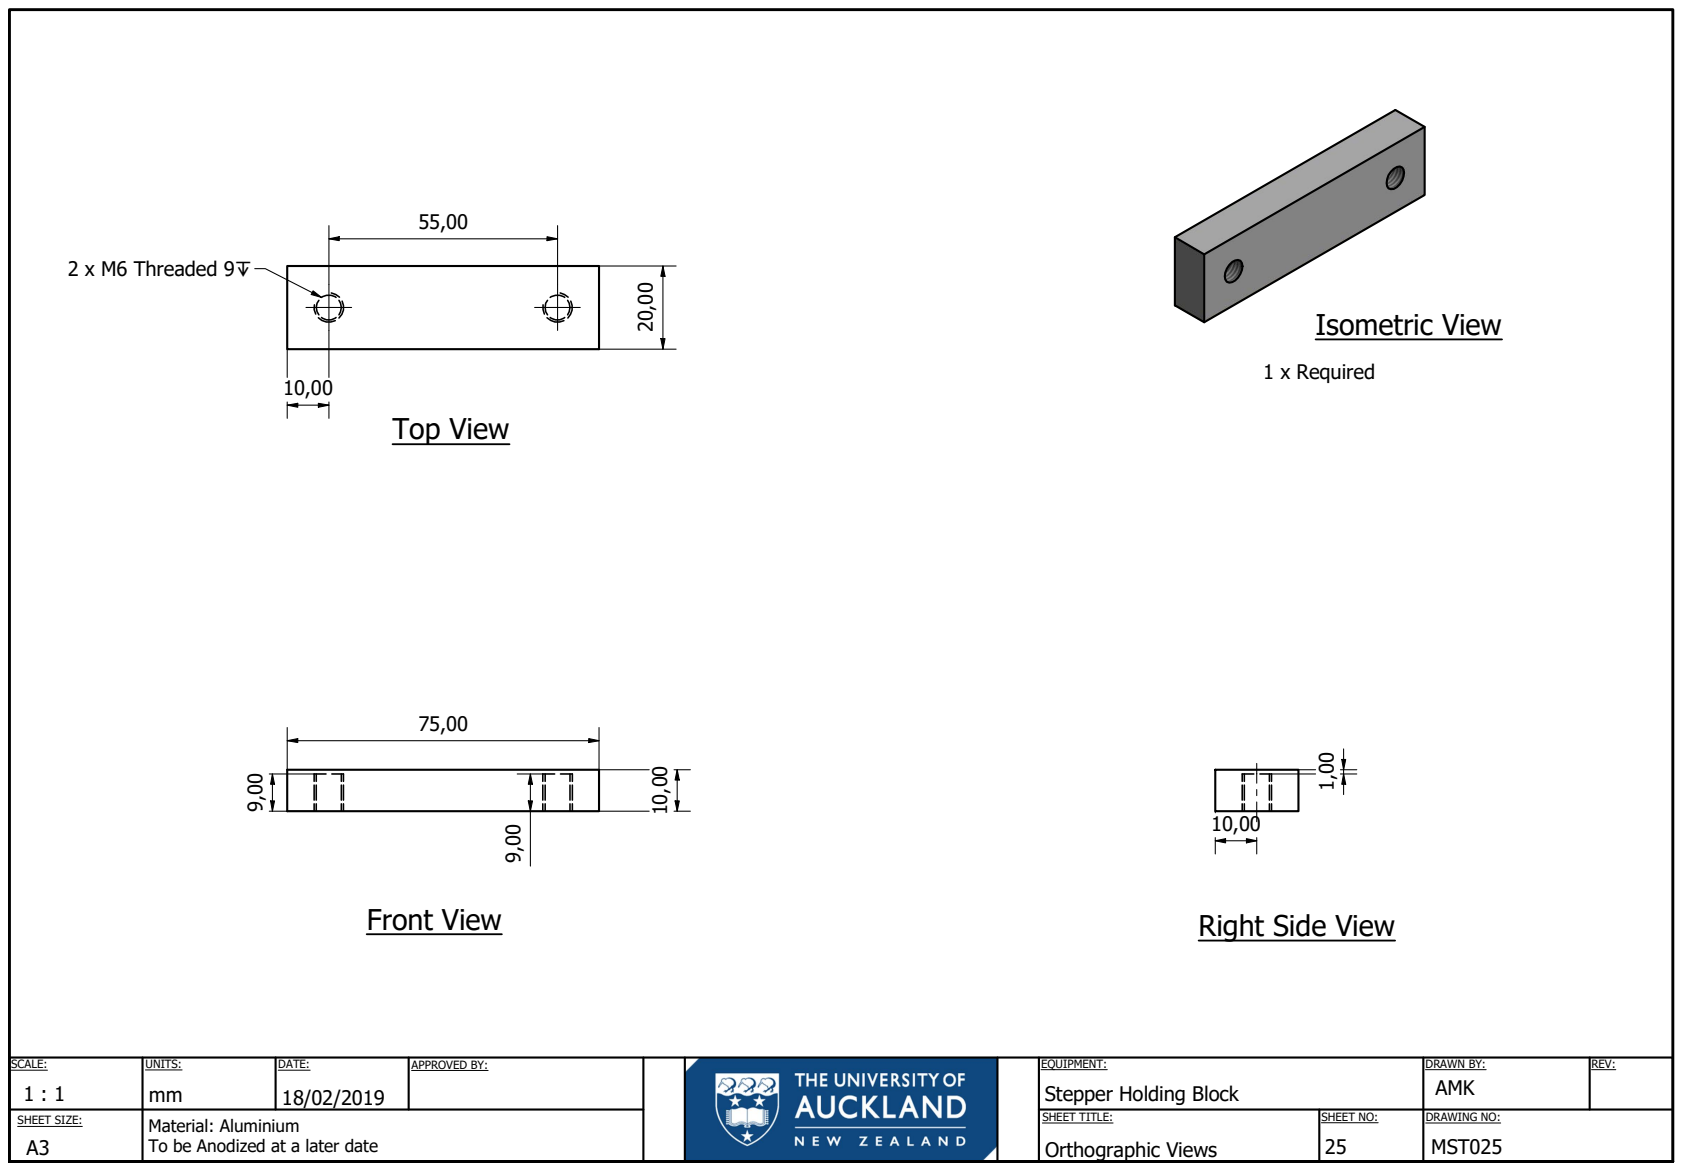
[picture p30: page 25]
SCALE:; UNITS:; DATE:; APPROVED BY:; EQUIPMENT:; DRAWN BY:; Orthographic Views; MST025; Stepper Holding Block; Front View; Top View; Isometric View; 1 x Required

Right Side View

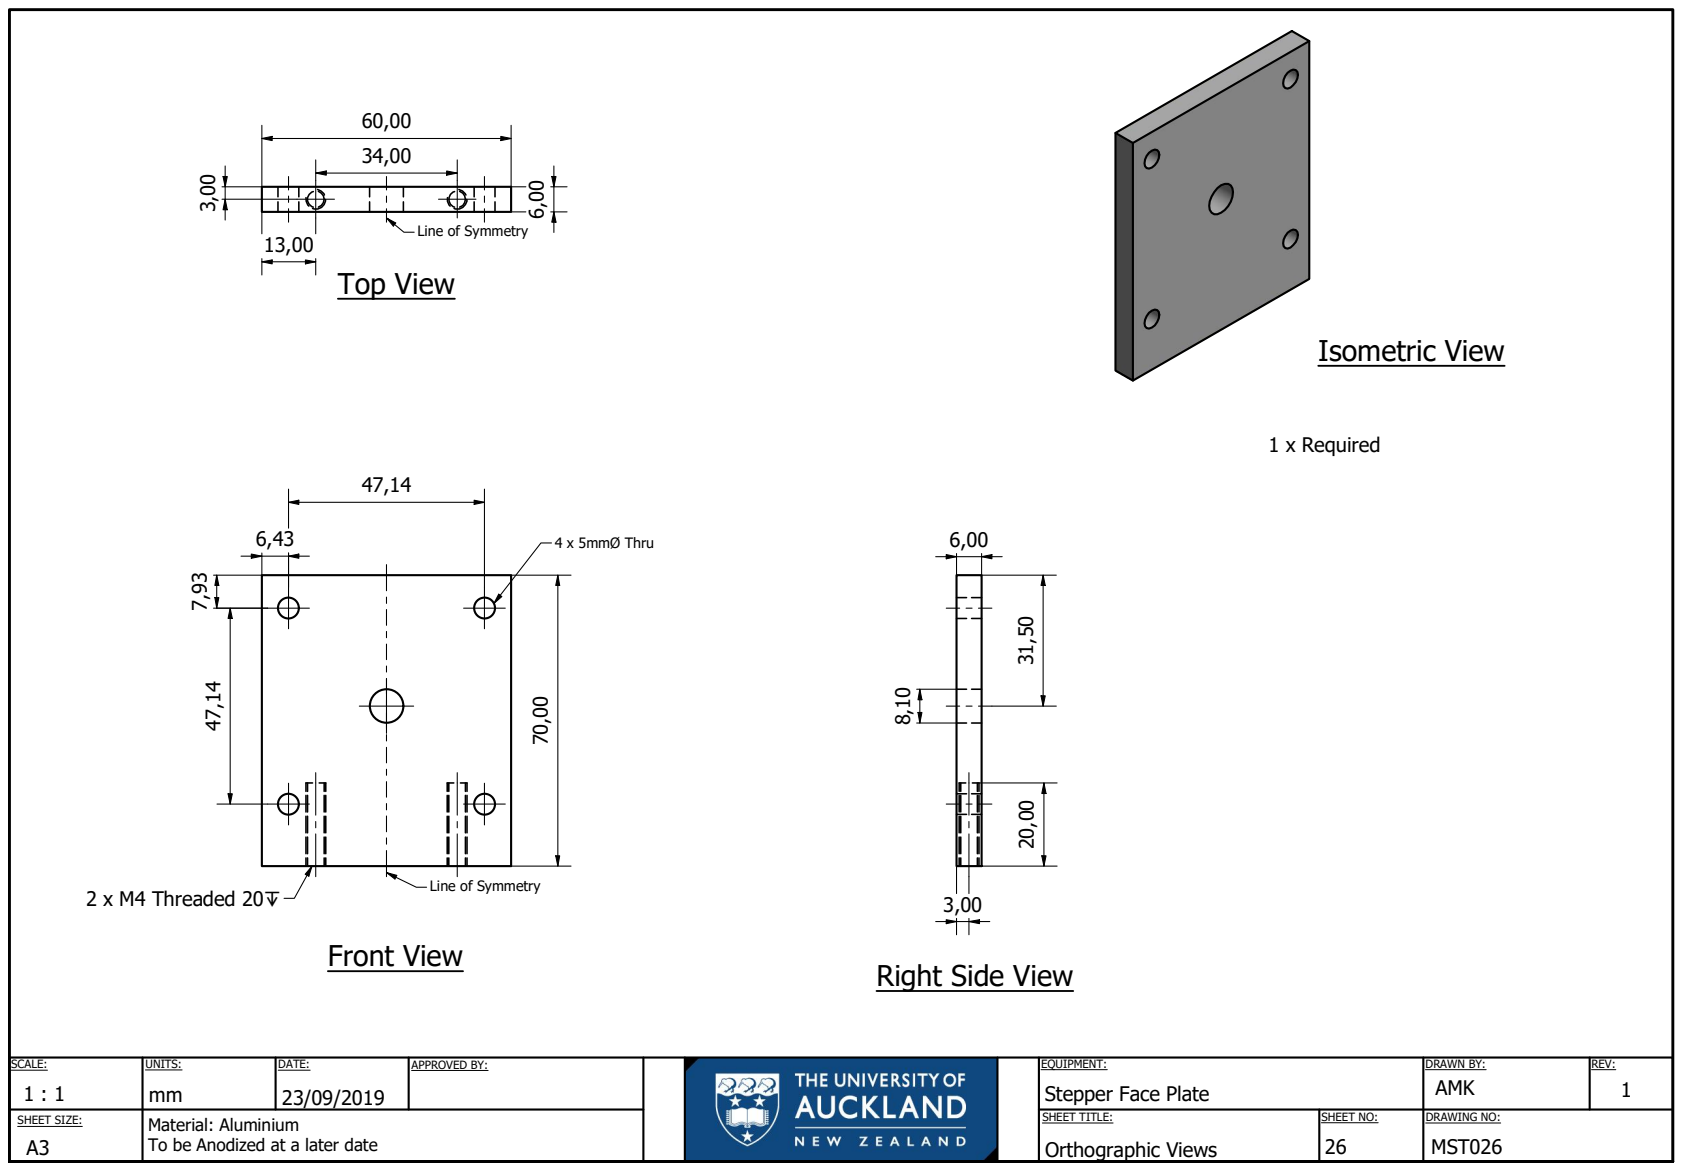
[picture p31: page 26]
SCALE:; UNITS:; DATE:; APPROVED BY:; EQUIPMENT:; DRAWN BY:; Orthographic Views; MST026; Stepper Face Plate; 4 x 5mmØ Thru; Front View; Isometric View; 1 x Required

Line of Symmetry
Top View

Right Side View

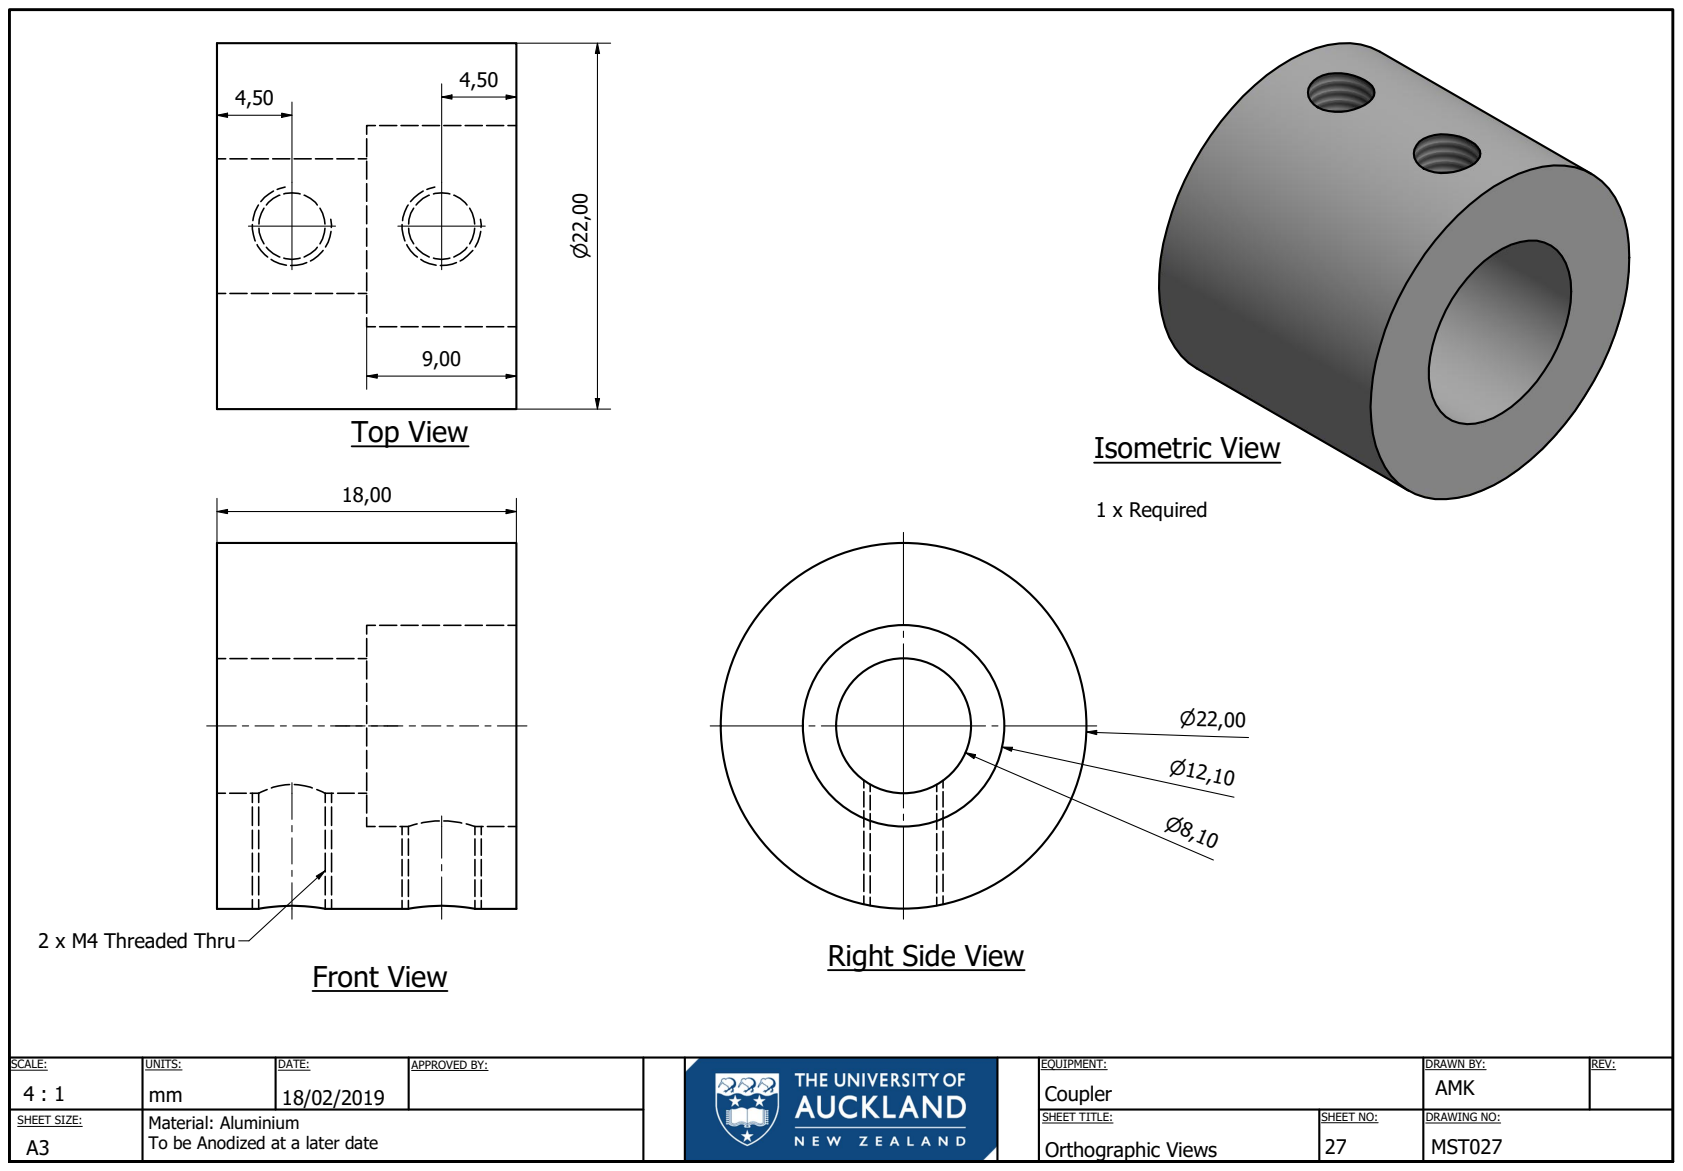
[picture p32: page 27]
2 x M4 Threaded Thru; Front View; Top View; Isometric View; 1 x Required

Right Side View

SCALE: 4 : 1 | UNITS: mm | DATE: 18/02/2019 | APPROVED BY: | EQUIPMENT: Coupler | DRAWN BY: AMK | REV:

Orthographic Views | 27 | MST027

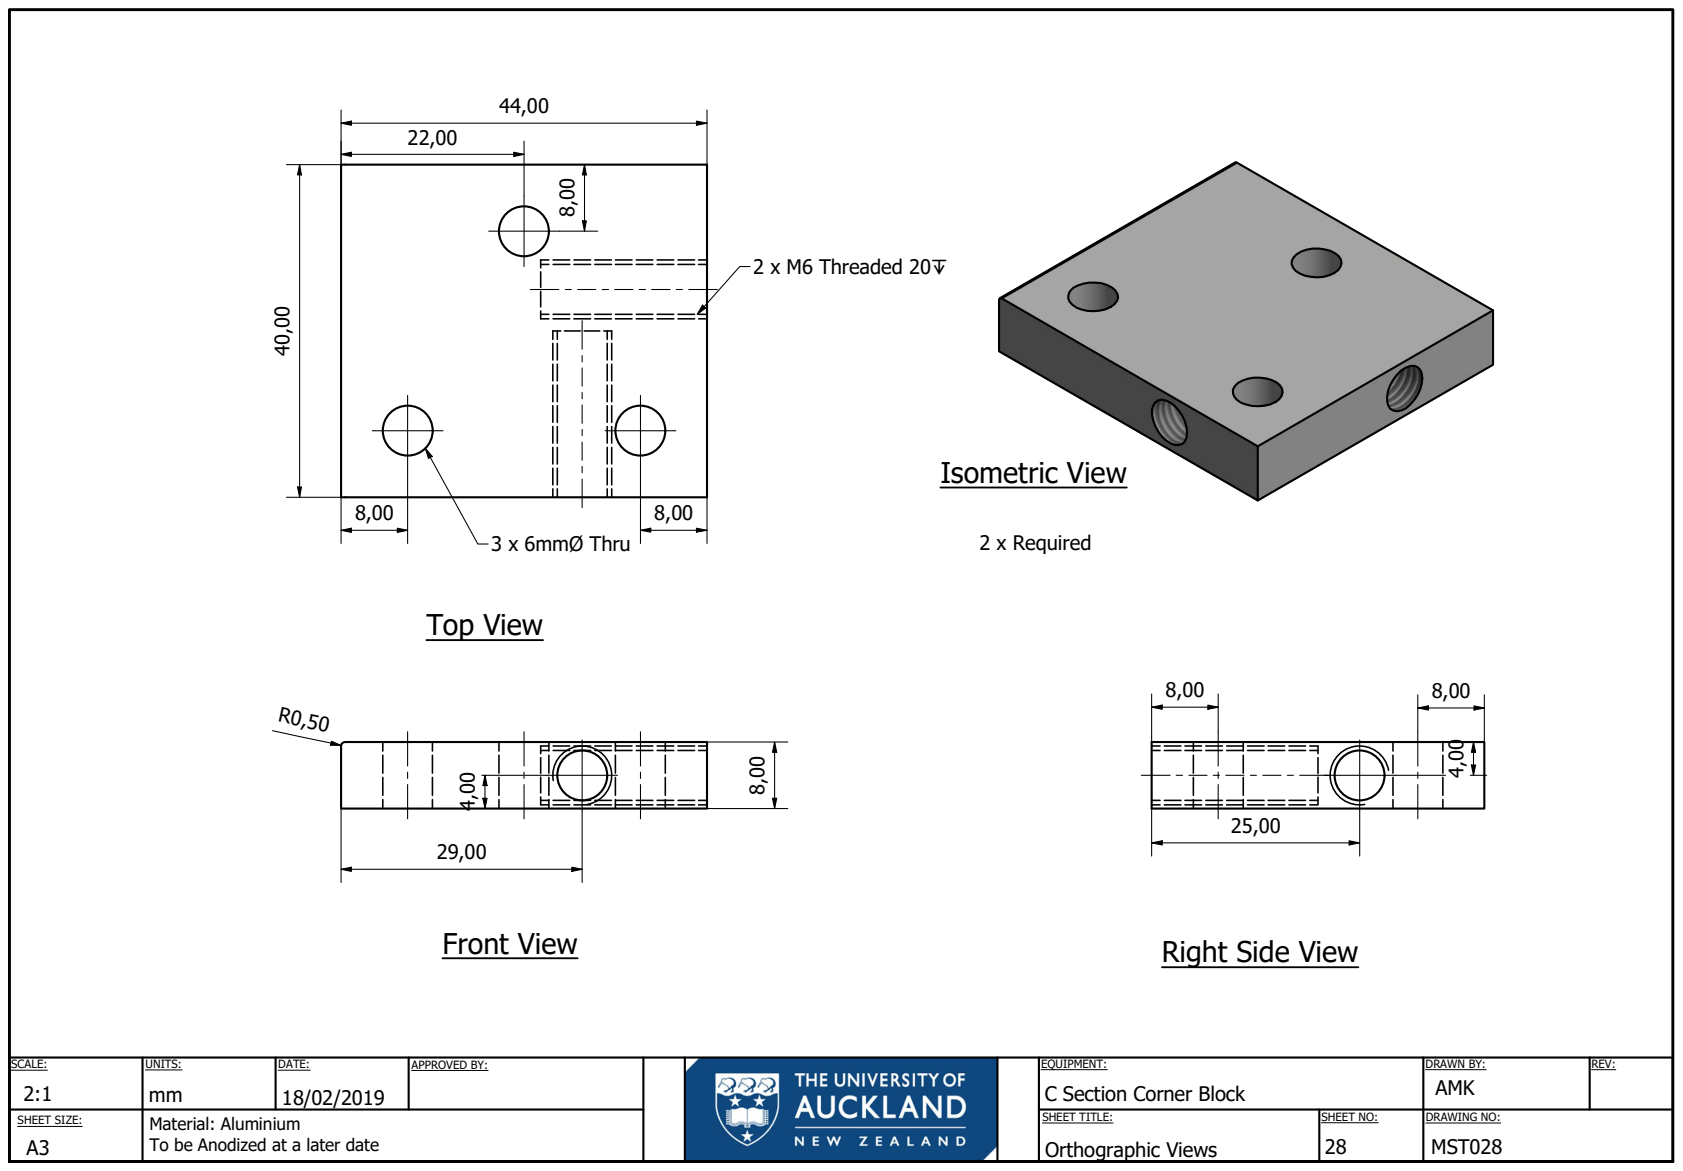
[picture p33: page 28]
SCALE:; UNITS:; DATE:; APPROVED BY:; EQUIPMENT:; DRAWN BY:; Orthographic Views; MST028; C Section Corner Block; 3 x 6mmØ Thru; Front View; Right Side View; Top View; Isometric View; 2 x Required

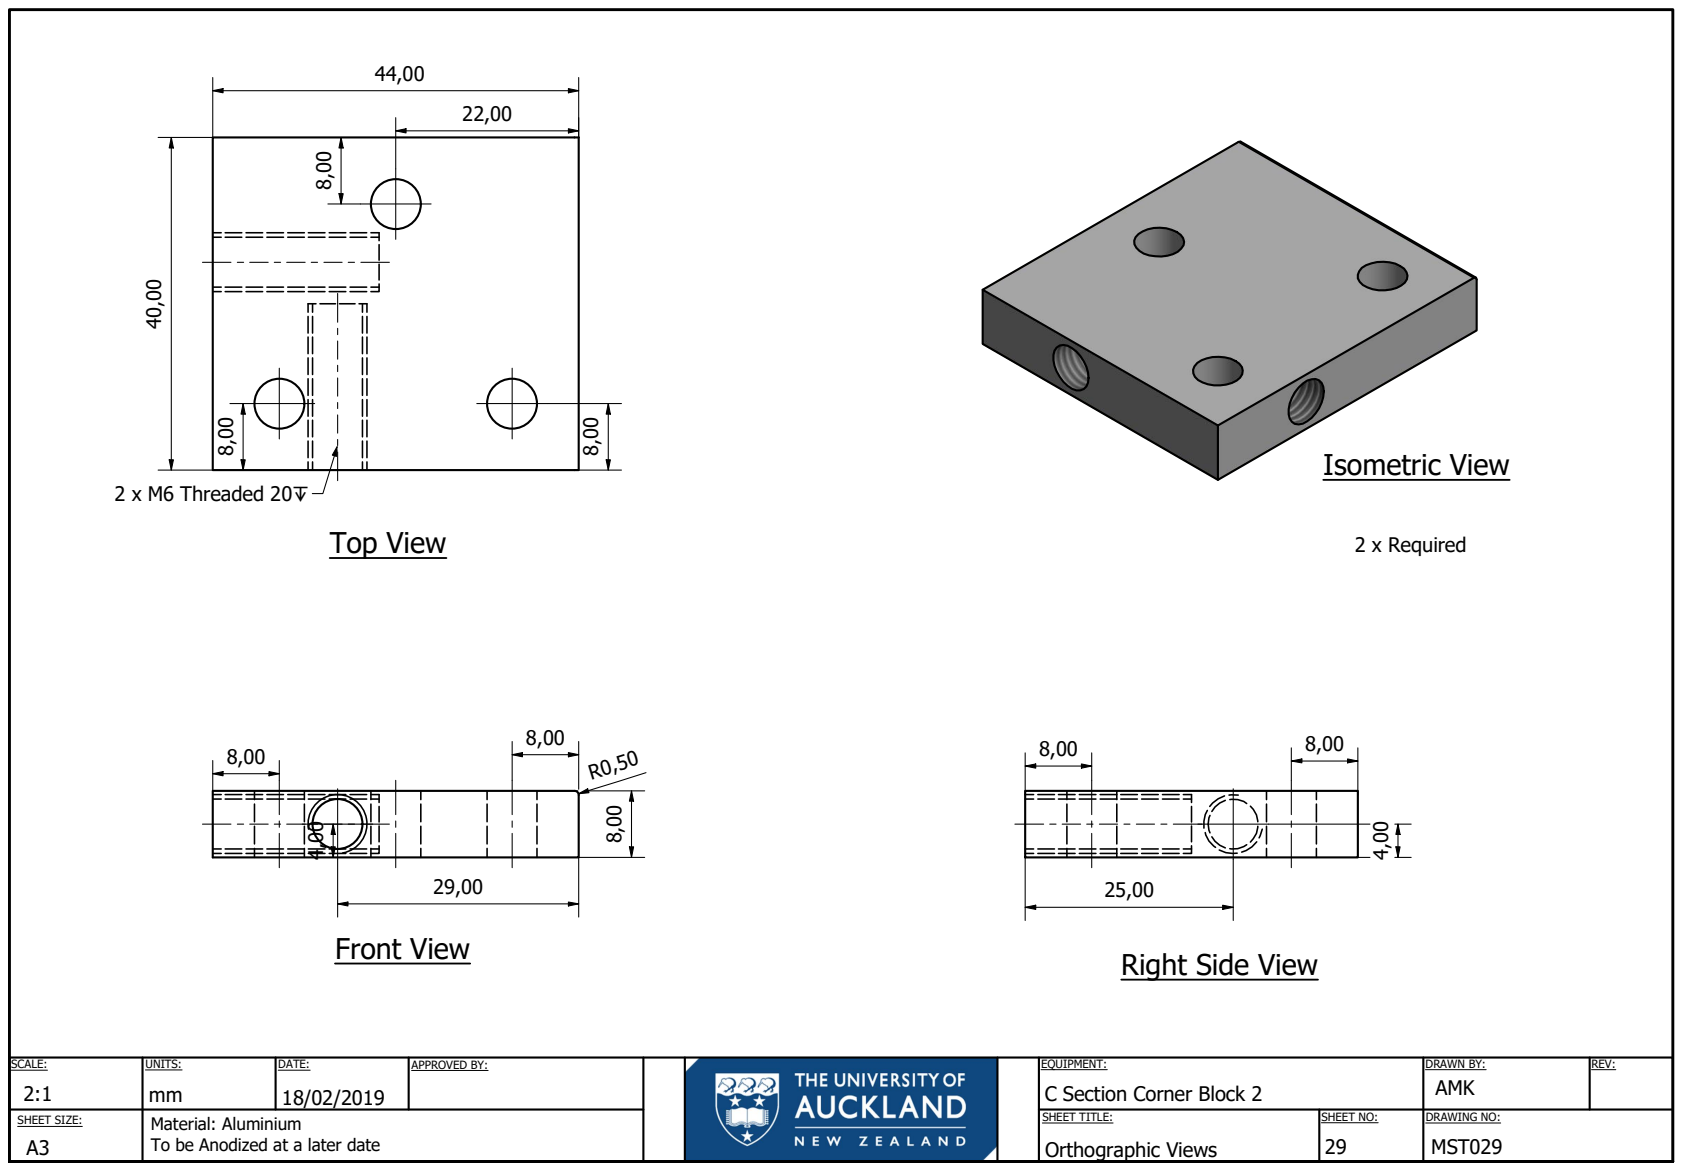
[picture p34: page 29]
SCALE:; UNITS:; DATE:; APPROVED BY:; EQUIPMENT:; DRAWN BY:; Orthographic Views; MST029; C Section Corner Block 2; Front View; Top View; Isometric View; 2 x Required

Right Side View

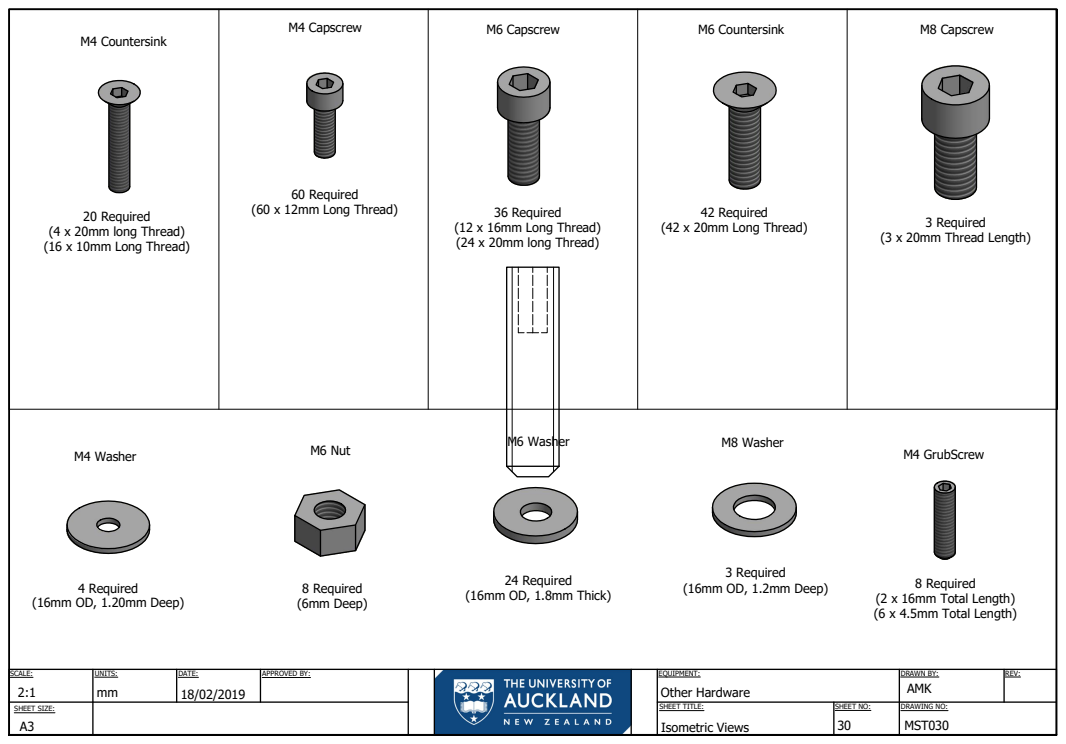
[picture p35: page 30]
M4 Countersink; M4 Capscrew; M6 Capscrew; M6 Countersink; M8 Capscrew; M6 Nut; M6 Washer; M8 Washer; 60 Required (60 x 12mm Long Thread); 20 Required (4 x 20mm long Thread) (16 x 10mm Long Thread); 42 Required (42 x 20mm Long Thread); 36 Required (12 x 16mm Long Thread) (24 x 20mm long Thread); 3 Required (3 x 20mm Thread Length); 8 Required (6mm Deep); 24 Required (16mm OD, 1.8mm Thick); 3 Required (16mm OD, 1.2mm Deep); M4 Washer; 4 Required (16mm OD, 1.20mm Deep); M4 GrubScrew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

SCALE: 2:1 | UNITS: mm | DATE: 18/02/2019 | APPROVED BY: | EQUIPMENT: Other Hardware | DRAWN BY: AMK | REV:

Isometric Views | 30 | MST030

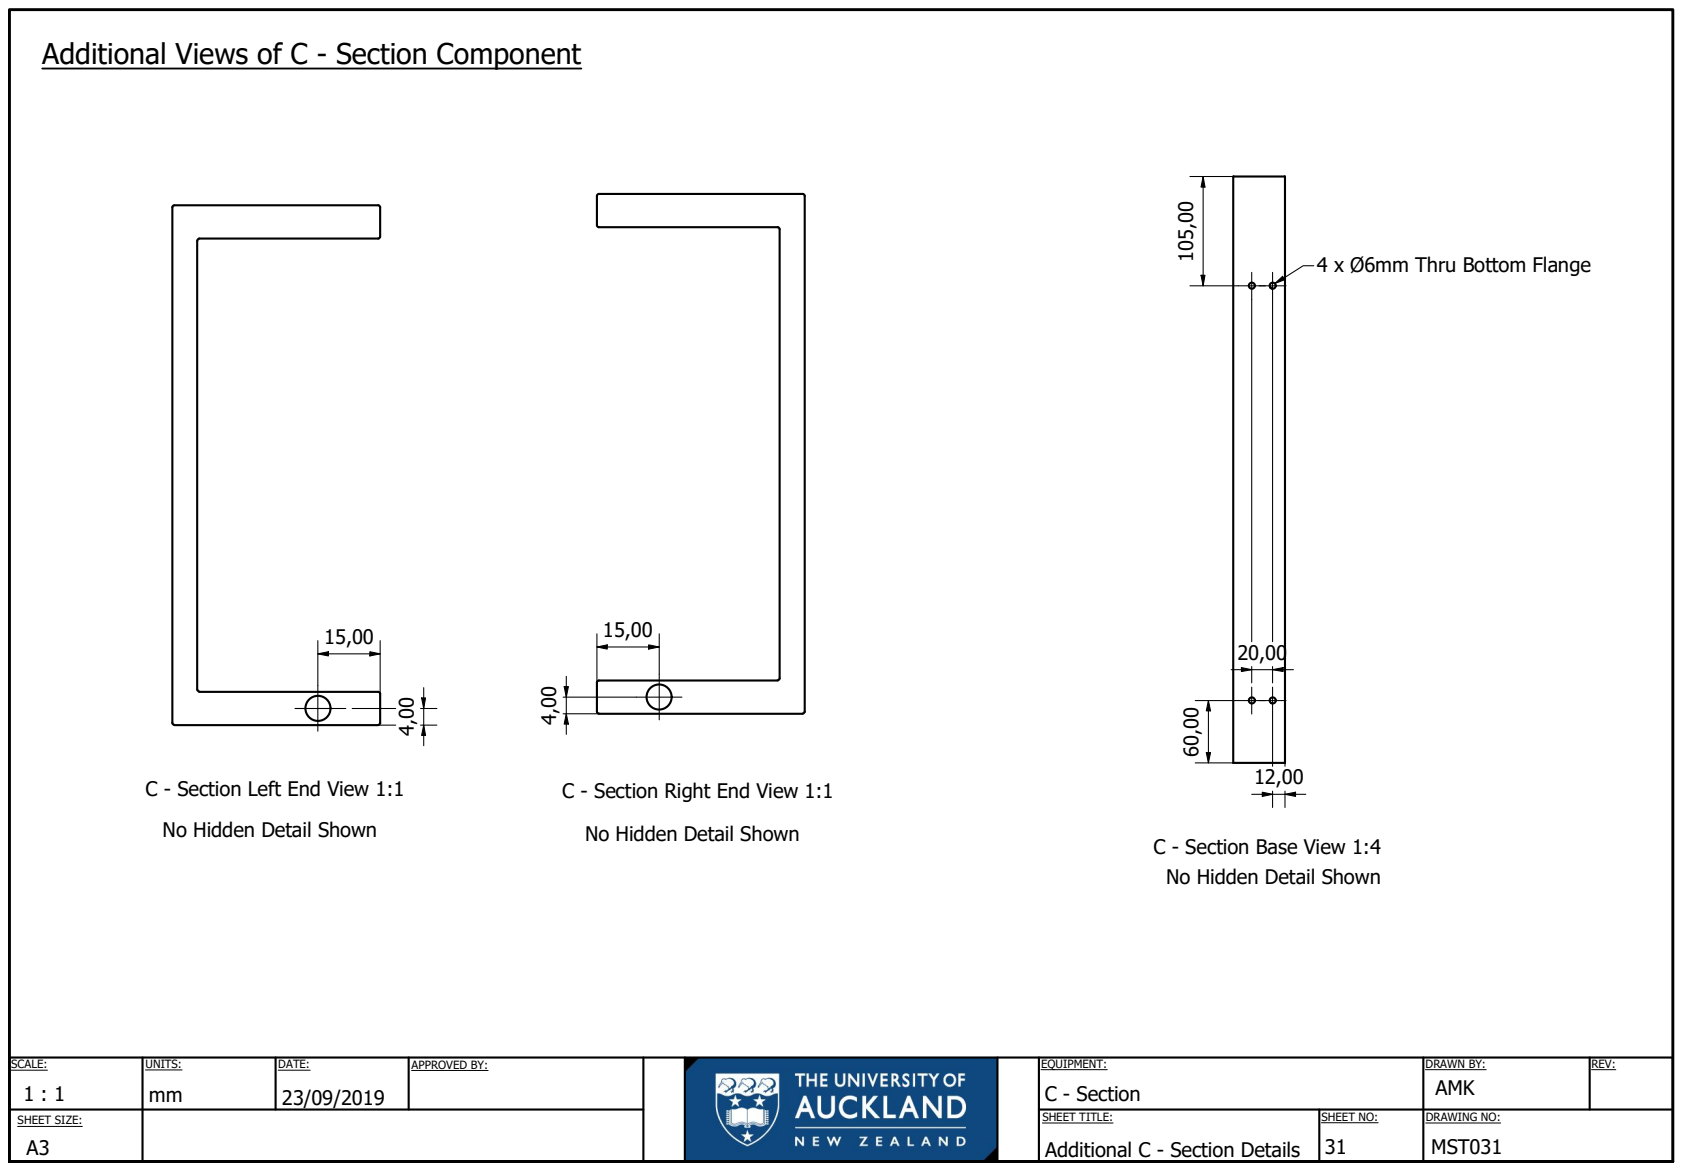
[picture p36: page 31]
C - Section Left End View 1:1; C - Section Right End View 1:1; No Hidden Detail Shown

Additional Views of C - Section Component

4 x Ø6mm Thru Bottom Flange

C - Section Base View 1:4
No Hidden Detail Shown

SCALE: 1 : 1 | UNITS: mm | DATE: 23/09/2019 | APPROVED BY: | EQUIPMENT: C - Section | DRAWN BY: AMK | REV:

Additional C - Section Details | 31 | MST031

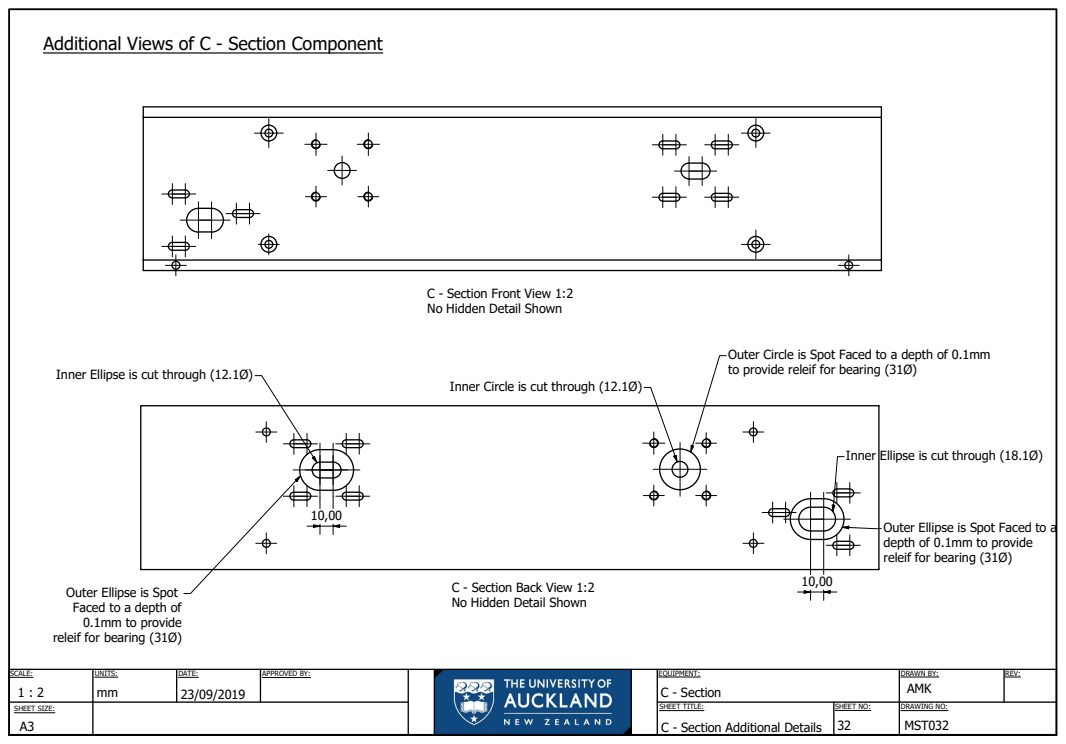
[picture p37: page 32]
SCALE:; UNITS:; DATE:; APPROVED BY:; EQUIPMENT:; DRAWN BY:; C - Section Additional Details; MST032; C - Section; AMK; Inner; Ellipse is cut through (18.1Ø)

Additional Views of C - Section Component

C - Section Front View 1:2
No Hidden Detail Shown

Outer Circle is Spot Faced to a depth of 0.1mm
to provide releif for bearing (31Ø)

Inner Ellipse is cut through (12.1Ø)

Inner Circle is cut through (12.1Ø)

Outer Ellipse is Spot Faced to a
depth of 0.1mm to provide
releif for bearing (31Ø)

C - Section Back View 1:2

Outer Ellipse is Spot
Faced to a depth of
0.1mm to provide

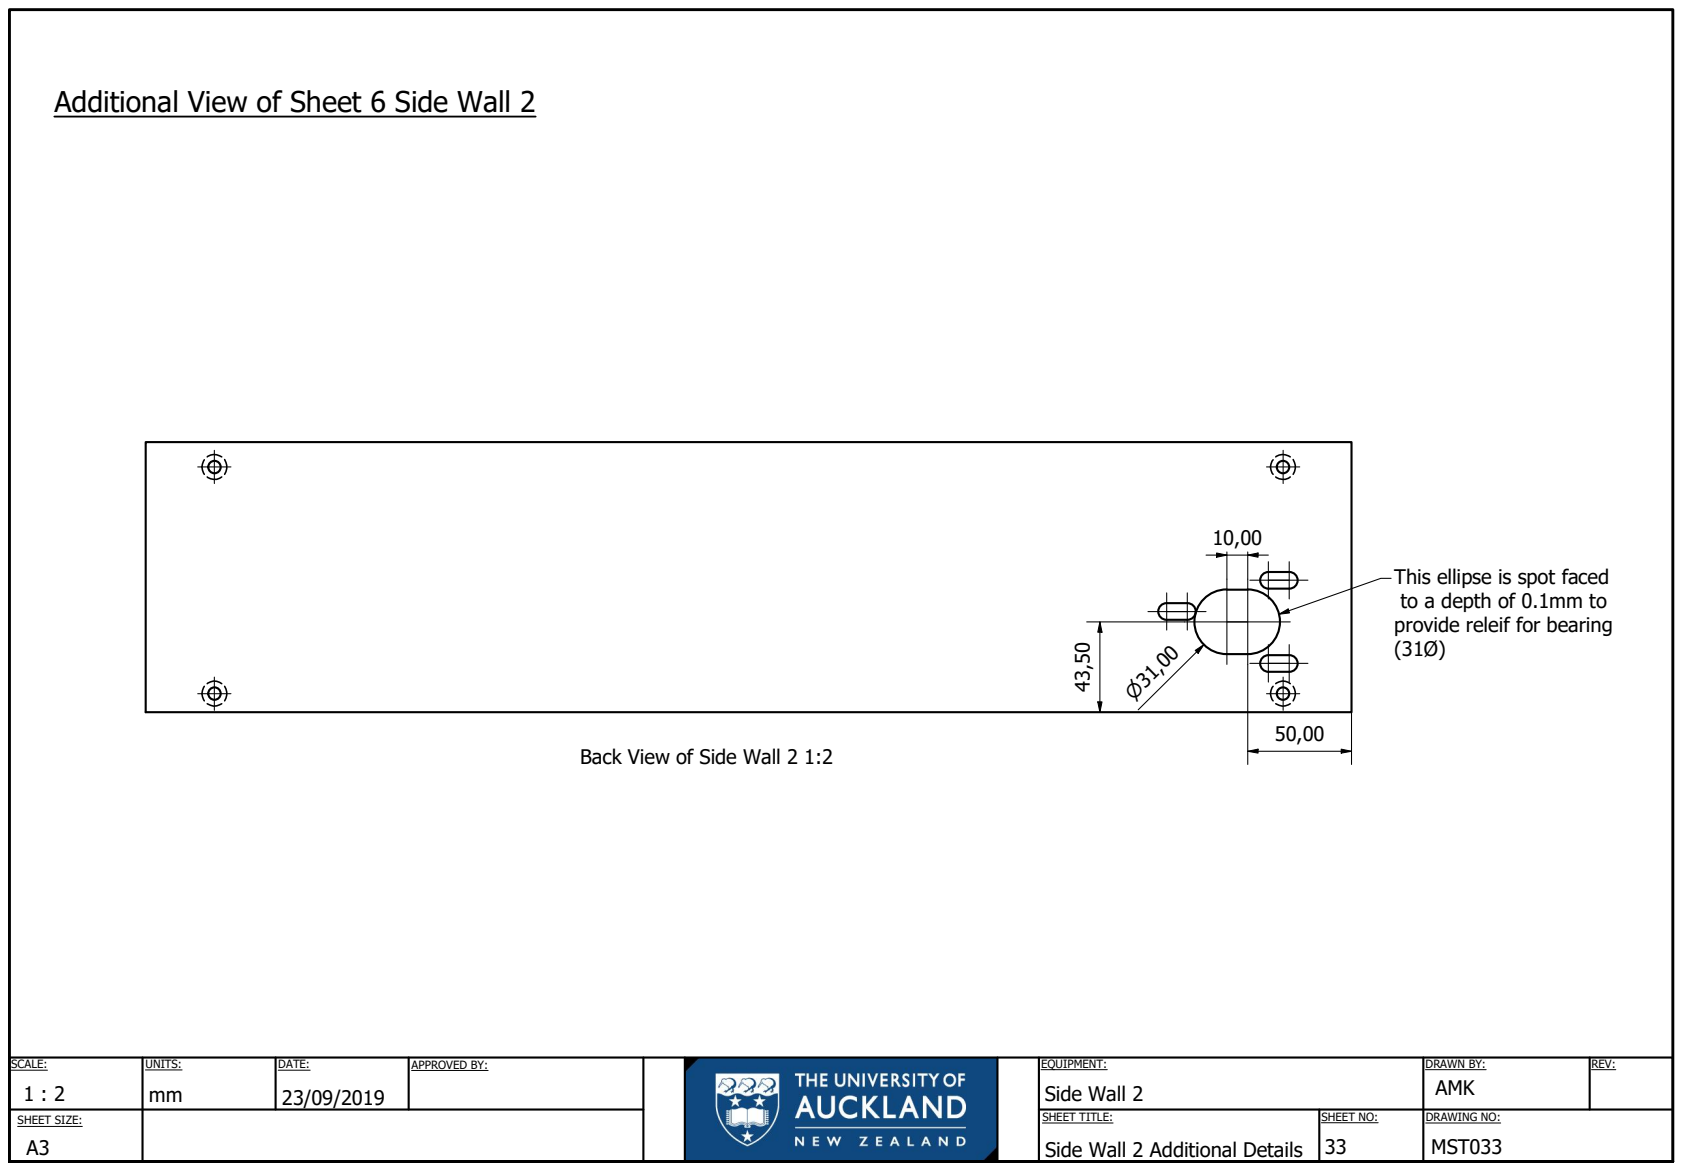
[picture p38: page 33]

Additional View of Sheet 6 Side Wall 2

This ellipse is spot faced
to a depth of 0.1mm to
provide releif for bearing

Back View of Side Wall 2 1:2

SCALE: 1 : 2 | UNITS: mm | DATE: 23/09/2019 | APPROVED BY: | EQUIPMENT: Side Wall 2 | DRAWN BY: AMK | REV:

Side Wall 2 Additional Details | 33 | MST033

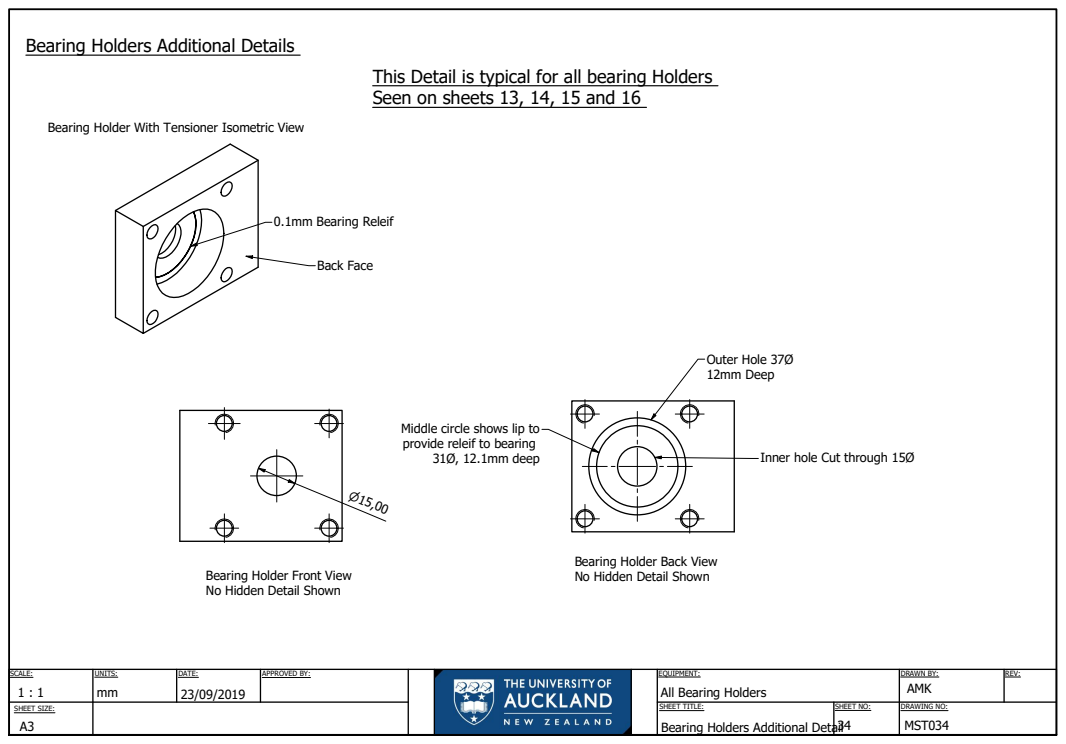
[picture p39: page 34]
Back Face; Outer Hole 37Ø 12mm Deep; 0.1mm Bearing Releif

Bearing Holders Additional Details

This Detail is typical for all bearing Holders
Seen on sheets 13, 14, 15 and 16

Bearing Holder With Tensioner Isometric View

Middle circle shows lip to
provide releif to bearing
31Ø, 12.1mm deep

Inner hole Cut through 15Ø

Bearing Holder Back View
No Hidden Detail Shown

Bearing Holder Front View

SCALE: 1 : 1 | UNITS: mm | DATE: 23/09/2019 | APPROVED BY: | EQUIPMENT: All Bearing Holders | DRAWN BY: AMK | REV:

Bearing Holders Additional Deta3il4 | | MST034
