Saultes45/Mini-Shake-Table-UoA/(commit log)

2021-06-29 Create Manufacturer Motor
2021-07-14 Prepared trimpot calibration sketches
2021-07-14 HW timer with trimpots done
2021-07-15 Finished debounce mode switch
2021-07-21 Added xlsx scenarios
    [F convolution.xlsx, F sweep.xlsx, High F Low A.xlsx]
2021-07-21 Create Test - S.xlsx
    [Test - S.xlsx]
2021-07-21 Added PCB fabrication files
    [BOM_Minishake RT micro_2021-07-20.xlsx]
2021-07-22 Update test API Stepper
2021-07-24 switch case
2021-07-24 Added switch scenario
2021-07-25 Modification of the calibration
2021-07-25 Added calibration and serial buffer
2021-07-28 Update Manufacturer Motor.txt
2021-08-04 Create Calibration Flowchart Minishake.drawio
2021-08-04 Update Calibration Flowchart Minishake.drawio
2021-08-04 Update calibration
2021-08-04 Calibration finished
2021-08-06 Stored motor information
